mmmaisel/Keyboard/README.md

# Keyboard

This repo was migrated to [Codeberg](https://codeberg.org/mmmaisel/Keyboard).

An Open-Source and Open-Hardware full-sized modular, ergonomic, RGB keyboard.

This project is currently work in progress and not tested.

## License

Keyboard KiCAD hardware design files in the "hw" directory are licenses under
the CERN-OHL-S v2, or (at your option) any later version.

The Keyboard firmware in the "src" directory is licensed under the
GNU GPLv3, or (at your option) any later version.
