mmmaisel/Keyboard/hw/Keyboard-Outer-Case.FCStd

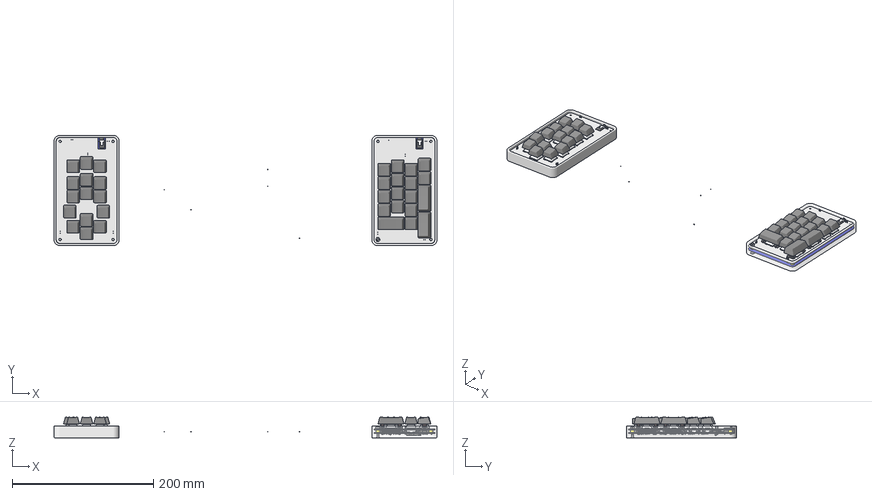
[picture p1: CAD file, 2024-01-11]
hw/Keyboard-Outer-Case.FCStd
542.3 x 156.3 x 29.3 mm
Outer Case
ISO14581 M3x16
M3-Mutter
Metal Nav
Metal Num
Case Clone
