mmmaisel/Keyboard/hw/CPU-Left.kicad_sch

## KiCad design hw/CPU-Left.kicad_sch (2026-01-05)

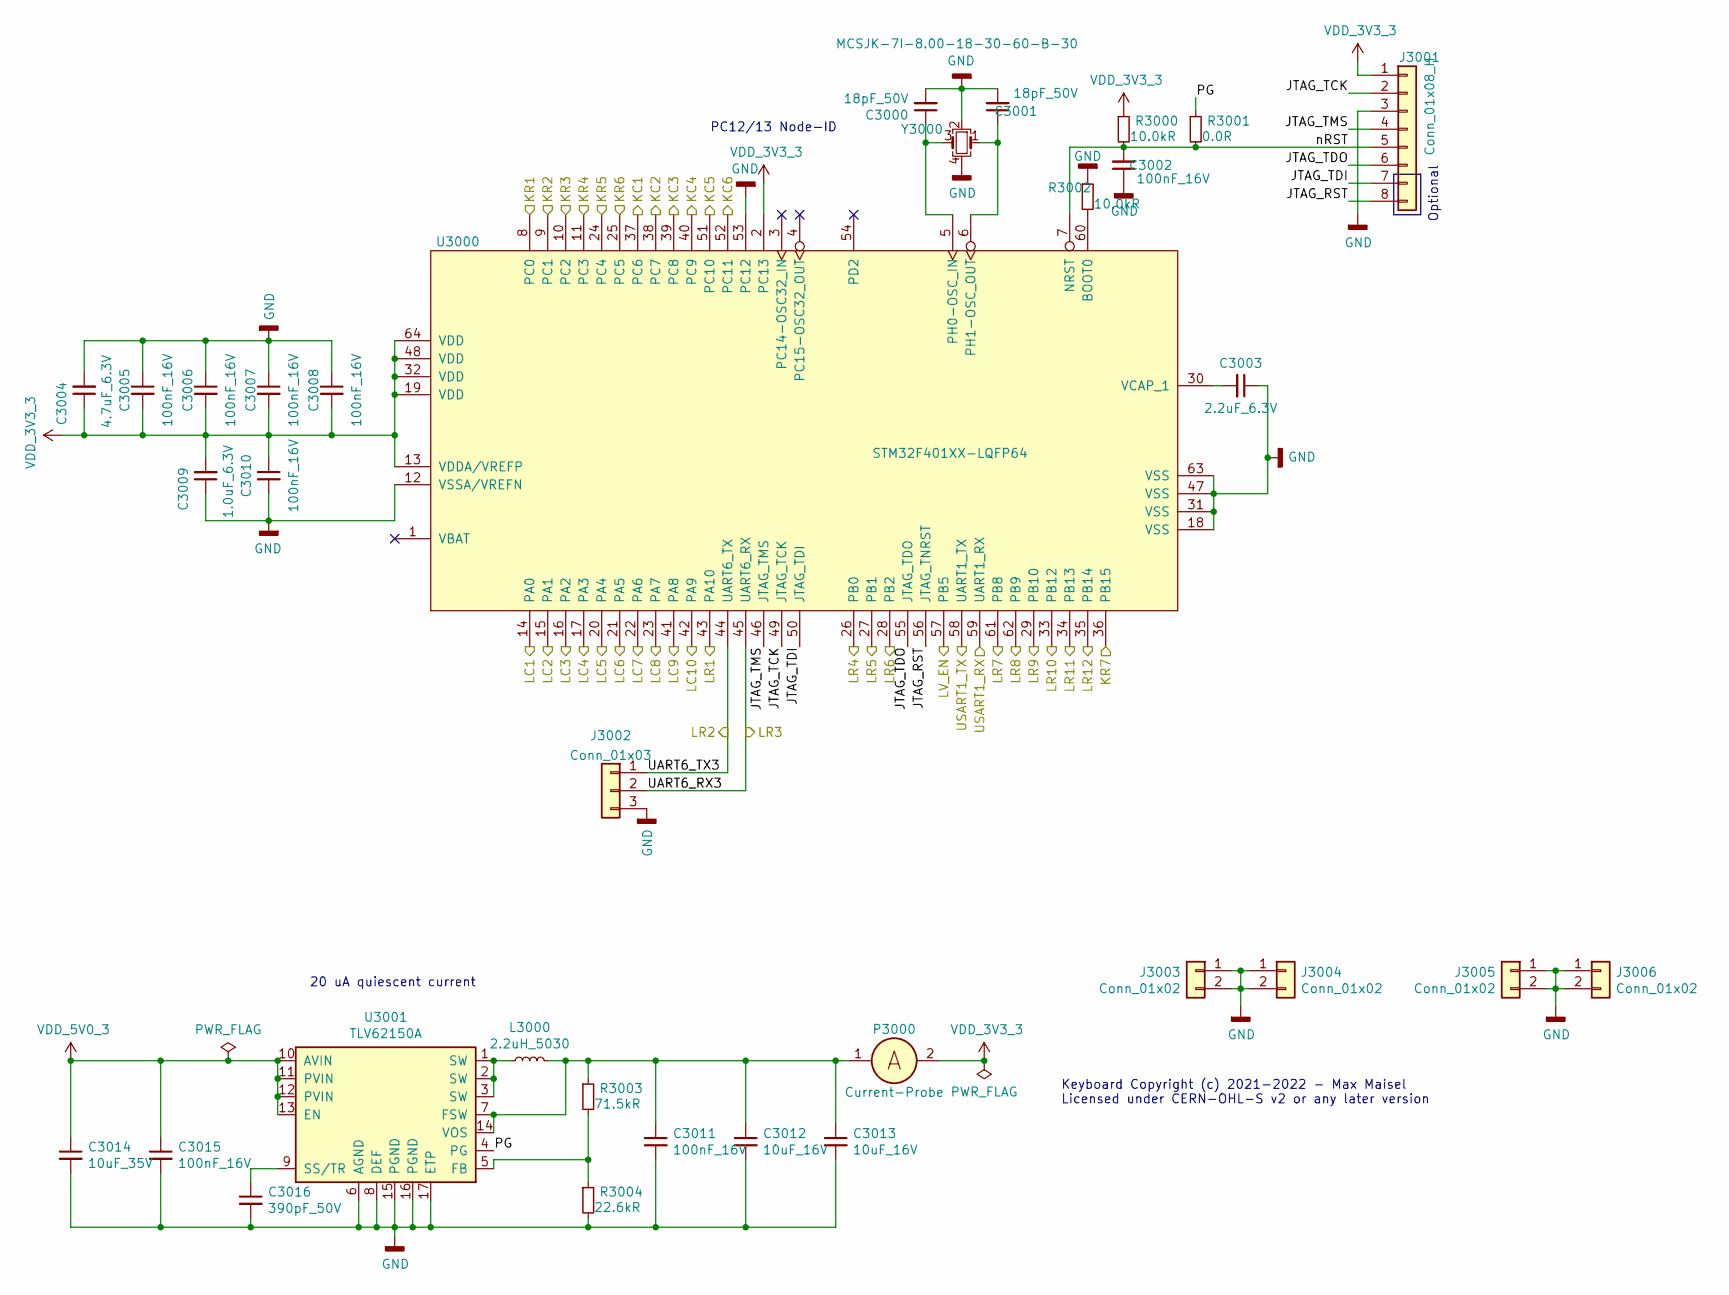
[picture p2: schematic CPU-Left.kicad_sch]

Parts:
C3000, C3001: 18pF_50V; C_0402; mouser# 81-GRM1555C1H180FA1D
C3002, C3005, C3006, C3007, C3008, C3010, C3011, C3015: 100nF_16V; C_0402; mouser# 80-C0402C104K4R
C3003: 2.2uF_6.3V; C_0402; mouser# 81-GRM155R60J225ME9D
C3004: 4.7uF_6.3V; C_0402; mouser# 81-GRM155R60J475ME7D
C3009: 1.0uF_6.3V; C_0402; mouser# 81-GRM152R60J105ME5D
C3012, C3013: 10uF_16V; C_1206; mouser# 80-C1206C106K4P
C3014: 10uF_35V; C_1210; mouser# 963-GMK325BJ106KN-T
C3016: 390pF_50V; C_0402; mouser# 81-GRM155R71H391KA1D
J3001: Conn_01x08_H; Pin_Header_Horizontal_1x08_Pitch2.54mm; farnell# 1593431
J3002: Conn_01x03; Pin_Header_Straight_1x03_Pitch2.54mm; farnell# 1593412
J3003, J3004, J3005, J3006: Conn_01x02; Pin_Header_Straight_1x02_Pitch2.54mm; farnell# 1593411
L3000: 2.2uH_5030; L_Taiyo-Yuden_NR-50xx; mouser# 963-NRS5030T2R2NMGJV
P3000: Current-Probe; Current-Probe-2.54
R3000, R3002: 10.0kR; R_0402; mouser# 667-ERJ-2RKF1002X
R3001: 0.0R; R_0402; mouser# 667-ERJ-2GE0R00X
R3003: 71.5kR; R_0402; mouser# 667-ERJ-2RKF7152X
R3004: 22.6kR; R_0402; mouser# 667-ERJ-S02F2262X
U3000: STM32F401XX-LQFP64; LQFP-64
U3001: TLV62150A; VQFN16-RGT; mouser# 595-TLV62150ARGTR
Y3000: MCSJK-7I-8.00-18-30-60-B-30; Crystal_SMD_Multicomp_5032; farnell# 2854013

Connections:
GND: C3000.2, C3001.2, C3002.1, C3003.1, C3004.2, C3005.1, C3006.1, C3007.1, C3008.1, C3009.1, C3010.2, C3011.2, C3012.2, C3013.2, C3014.2, C3015.2, C3016.2, J3001.3, J3002.3, J3003.1, J3003.2, J3004.1, J3004.2, J3005.1, J3005.2, J3006.1, J3006.2, R3002.1, R3004.2, U3000.12 (VSSA/VREFN), U3000.18 (VSS), U3000.31 (VSS), U3000.47 (VSS), U3000.53 (PC12), U3000.63 (VSS), U3001.6 (AGND), U3001.8 (DEF), U3001.15 (PGND), U3001.16 (PGND), U3001.17 (ETP), Y3000.2, Y3000.4
JTAG_RST: J3001.8, U3000.56 (PB4)
JTAG_TCK: J3001.2, U3000.49 (PA14)
JTAG_TDI: J3001.7, U3000.50 (PA15)
JTAG_TDO: J3001.6, U3000.55 (PB3)
JTAG_TMS: J3001.4, U3000.46 (PA13)
KC1: U3000.37 (PC6)
KC2: U3000.38 (PC7)
KC3: U3000.39 (PC8)
KC4: U3000.40 (PC9)
KC5: U3000.51 (PC10)
KC6: U3000.52 (PC11)
KR1: U3000.8 (PC0)
KR2: U3000.9 (PC1)
KR3: U3000.10 (PC2)
KR4: U3000.11 (PC3)
KR5: U3000.24 (PC4)
KR6: U3000.25 (PC5)
KR7: U3000.36 (PB15)
LC1: U3000.14 (PA0)
LC2: U3000.15 (PA1)
LC3: U3000.16 (PA2)
LC4: U3000.17 (PA3)
LC5: U3000.20 (PA4)
LC6: U3000.21 (PA5)
LC7: U3000.22 (PA6)
LC8: U3000.23 (PA7)
LC9: U3000.41 (PA8)
LC10: U3000.42 (PA9)
LR1: U3000.43 (PA10)
LR2: J3002.1, U3000.44 (PA11)
LR3: J3002.2, U3000.45 (PA12)
LR4: U3000.26 (PB0)
LR5: U3000.27 (PB1)
LR6: U3000.28 (PB2)
LR7: U3000.61 (PB8)
LR8: U3000.62 (PB9)
LR9: U3000.29 (PB10)
LR10: U3000.33 (PB12)
LR11: U3000.34 (PB13)
LR12: U3000.35 (PB14)
LV_EN: U3000.57 (PB5)
unnamed: C3000.1, U3000.5 (PH0-OSC_IN), Y3000.3
unnamed: C3001.1, U3000.6 (PH1-OSC_OUT), Y3000.1
unnamed: C3003.2, U3000.30 (VCAP_1)
unnamed: C3011.1, C3012.1, C3013.1, L3000.2, P3000.1, R3003.1, U3001.7 (FSW), U3001.14 (VOS)
unnamed: C3016.1, U3001.9 (SS/TR)
unnamed: L3000.1, U3001.1 (SW), U3001.2 (SW), U3001.3 (SW)
unnamed: R3002.2, U3000.60 (BOOT0)
unnamed: R3003.2, R3004.1, U3001.5 (FB)
PG: R3001.1, U3001.4 (PG)
USART1_RX: U3000.59 (PB7)
USART1_TX: U3000.58 (PB6)
VDD_3V3_3: C3004.1, C3005.2, C3006.2, C3007.2, C3008.2, C3009.2, C3010.1, J3001.1, P3000.2, R3000.1, U3000.2 (PC13), U3000.13 (VDDA/VREFP), U3000.19 (VDD), U3000.32 (VDD), U3000.48 (VDD), U3000.64 (VDD)
VDD_5V0_3: C3014.1, C3015.1, U3001.10 (AVIN), U3001.11 (PVIN), U3001.12 (PVIN), U3001.13 (EN)
nRST: C3002.2, J3001.5, R3000.2, R3001.2, U3000.7 (NRST)

Notes on the sheet:
PC12/13 Node-ID
Keyboard Copyright (c) 2021-2022 - Max Maisel Licensed under CERN-OHL-S v2 or any later version
Optional
20 uA quiescent current
