mmmaisel/Keyboard/hw/CPU-Navblock.kicad_sch

## KiCad design hw/CPU-Navblock.kicad_sch (2026-01-05)

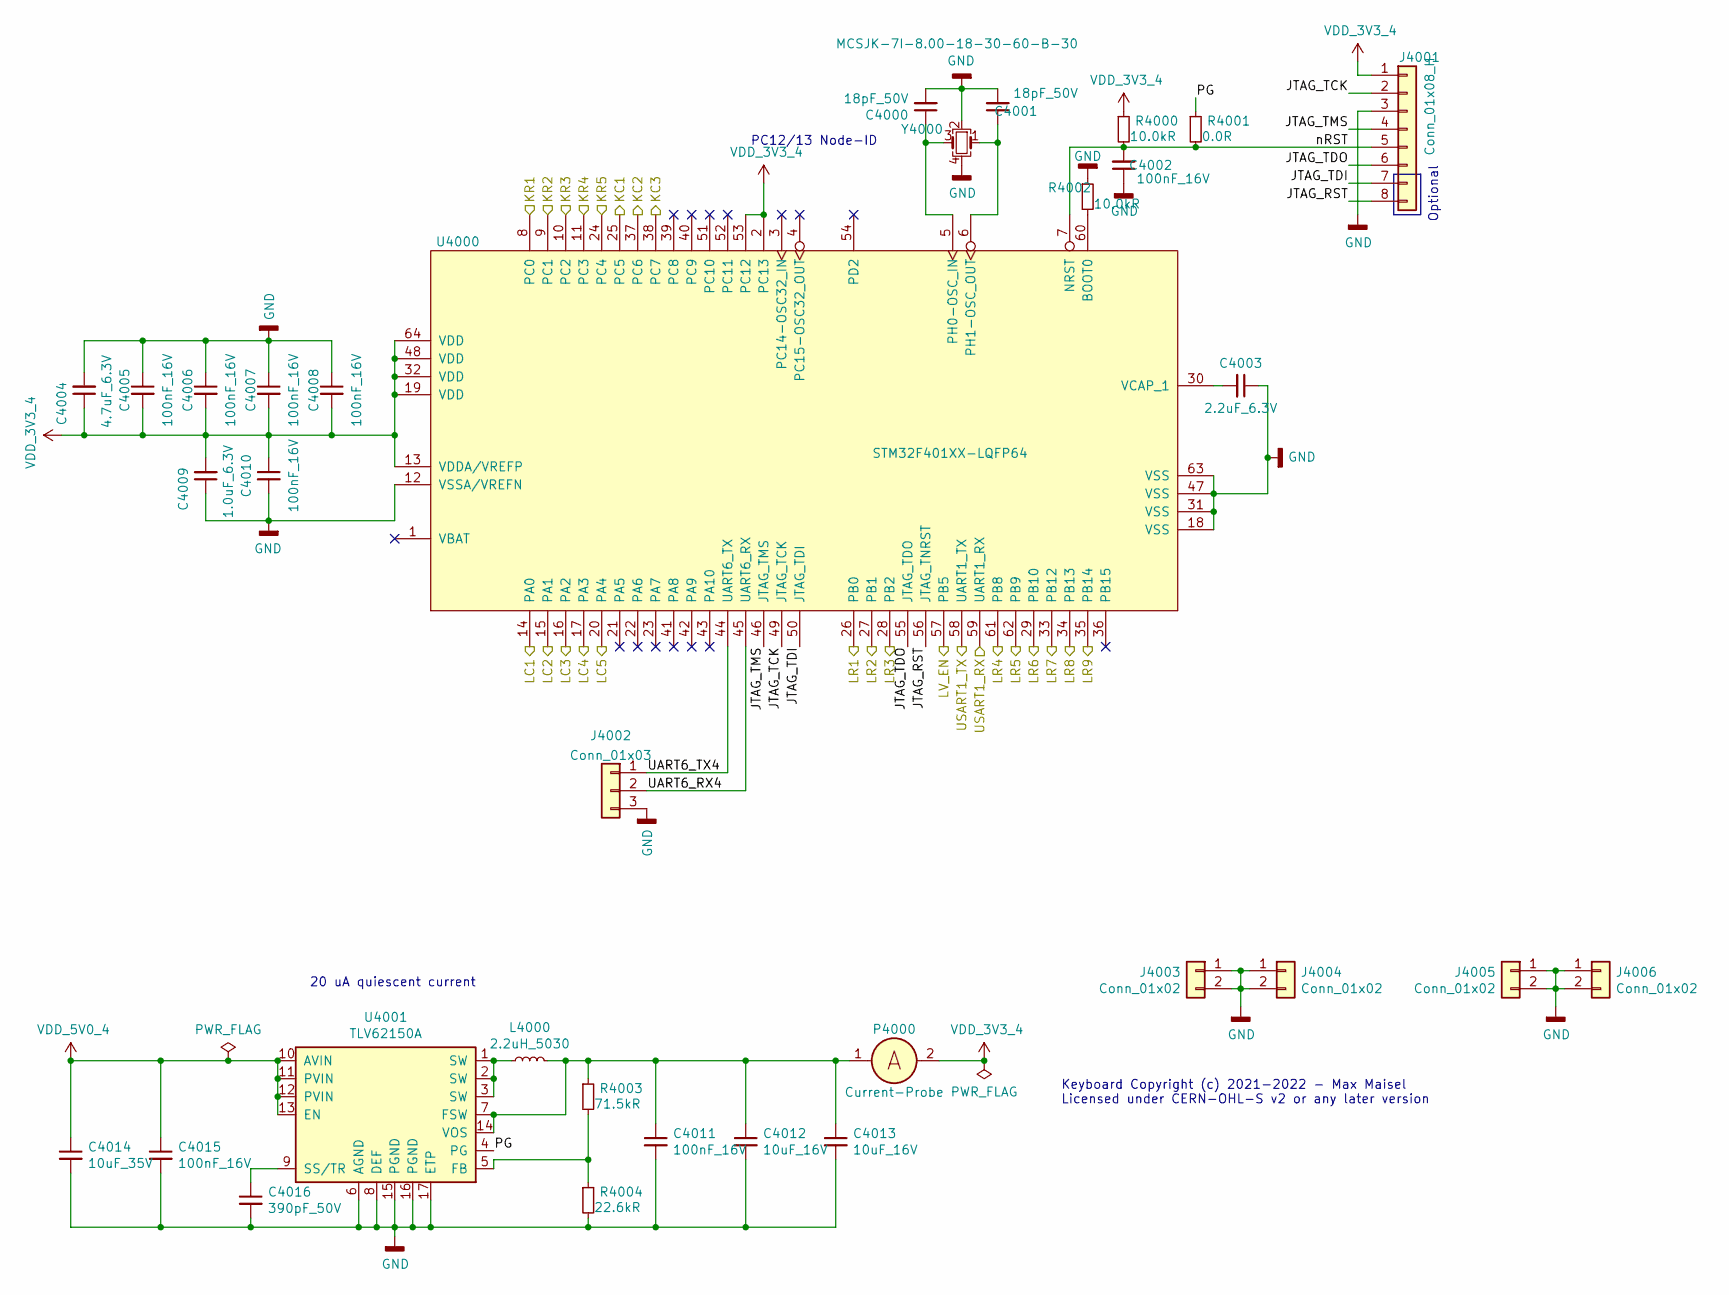
[picture p3: schematic CPU-Navblock.kicad_sch]

Parts:
C4000, C4001: 18pF_50V; C_0402; mouser# 81-GRM1555C1H180FA1D
C4002, C4005, C4006, C4007, C4008, C4010, C4011, C4015: 100nF_16V; C_0402; mouser# 80-C0402C104K4R
C4003: 2.2uF_6.3V; C_0402; mouser# 81-GRM155R60J225ME9D
C4004: 4.7uF_6.3V; C_0402; mouser# 81-GRM155R60J475ME7D
C4009: 1.0uF_6.3V; C_0402; mouser# 81-GRM152R60J105ME5D
C4012, C4013: 10uF_16V; C_1206; mouser# 80-C1206C106K4P
C4014: 10uF_35V; C_1210; mouser# 963-GMK325BJ106KN-T
C4016: 390pF_50V; C_0402; mouser# 81-GRM155R71H391KA1D
J4001: Conn_01x08_H; Pin_Header_Horizontal_1x08_Pitch2.54mm; farnell# 1593431
J4002: Conn_01x03; Pin_Header_Straight_1x03_Pitch2.54mm; farnell# 1593412
J4003, J4004, J4005, J4006: Conn_01x02; Pin_Header_Straight_1x02_Pitch2.54mm; farnell# 1593411
L4000: 2.2uH_5030; L_Taiyo-Yuden_NR-50xx; mouser# 963-NRS5030T2R2NMGJV
P4000: Current-Probe; Current-Probe-2.54
R4000, R4002: 10.0kR; R_0402; mouser# 667-ERJ-2RKF1002X
R4001: 0.0R; R_0402; mouser# 667-ERJ-2GE0R00X
R4003: 71.5kR; R_0402; mouser# 667-ERJ-2RKF7152X
R4004: 22.6kR; R_0402; mouser# 667-ERJ-S02F2262X
U4000: STM32F401XX-LQFP64; LQFP-64
U4001: TLV62150A; VQFN16-RGT; mouser# 595-TLV62150ARGTR
Y4000: MCSJK-7I-8.00-18-30-60-B-30; Crystal_SMD_Multicomp_5032; farnell# 2854013

Connections:
GND: C4000.2, C4001.2, C4002.1, C4003.1, C4004.2, C4005.1, C4006.1, C4007.1, C4008.1, C4009.1, C4010.2, C4011.2, C4012.2, C4013.2, C4014.2, C4015.2, C4016.2, J4001.3, J4002.3, J4003.1, J4003.2, J4004.1, J4004.2, J4005.1, J4005.2, J4006.1, J4006.2, R4002.1, R4004.2, U4000.12 (VSSA/VREFN), U4000.18 (VSS), U4000.31 (VSS), U4000.47 (VSS), U4000.63 (VSS), U4001.6 (AGND), U4001.8 (DEF), U4001.15 (PGND), U4001.16 (PGND), U4001.17 (ETP), Y4000.2, Y4000.4
JTAG_RST: J4001.8, U4000.56 (PB4)
JTAG_TCK: J4001.2, U4000.49 (PA14)
JTAG_TDI: J4001.7, U4000.50 (PA15)
JTAG_TDO: J4001.6, U4000.55 (PB3)
JTAG_TMS: J4001.4, U4000.46 (PA13)
KC1: U4000.25 (PC5)
KC2: U4000.37 (PC6)
KC3: U4000.38 (PC7)
KR1: U4000.8 (PC0)
KR2: U4000.9 (PC1)
KR3: U4000.10 (PC2)
KR4: U4000.11 (PC3)
KR5: U4000.24 (PC4)
LC1: U4000.14 (PA0)
LC2: U4000.15 (PA1)
LC3: U4000.16 (PA2)
LC4: U4000.17 (PA3)
LC5: U4000.20 (PA4)
LR1: U4000.26 (PB0)
LR2: U4000.27 (PB1)
LR3: U4000.28 (PB2)
LR4: U4000.61 (PB8)
LR5: U4000.62 (PB9)
LR6: U4000.29 (PB10)
LR7: U4000.33 (PB12)
LR8: U4000.34 (PB13)
LR9: U4000.35 (PB14)
LV_EN: U4000.57 (PB5)
unnamed: C4000.1, U4000.5 (PH0-OSC_IN), Y4000.3
unnamed: C4001.1, U4000.6 (PH1-OSC_OUT), Y4000.1
unnamed: C4003.2, U4000.30 (VCAP_1)
unnamed: C4011.1, C4012.1, C4013.1, L4000.2, P4000.1, R4003.1, U4001.7 (FSW), U4001.14 (VOS)
unnamed: C4016.1, U4001.9 (SS/TR)
unnamed: L4000.1, U4001.1 (SW), U4001.2 (SW), U4001.3 (SW)
unnamed: R4002.2, U4000.60 (BOOT0)
unnamed: R4003.2, R4004.1, U4001.5 (FB)
PG: R4001.1, U4001.4 (PG)
UART6_RX4: J4002.2, U4000.45 (PA12)
UART6_TX4: J4002.1, U4000.44 (PA11)
USART1_RX: U4000.59 (PB7)
USART1_TX: U4000.58 (PB6)
VDD_3V3_4: C4004.1, C4005.2, C4006.2, C4007.2, C4008.2, C4009.2, C4010.1, J4001.1, P4000.2, R4000.1, U4000.2 (PC13), U4000.13 (VDDA/VREFP), U4000.19 (VDD), U4000.32 (VDD), U4000.48 (VDD), U4000.53 (PC12), U4000.64 (VDD)
VDD_5V0_4: C4014.1, C4015.1, U4001.10 (AVIN), U4001.11 (PVIN), U4001.12 (PVIN), U4001.13 (EN)
nRST: C4002.2, J4001.5, R4000.2, R4001.2, U4000.7 (NRST)

Notes on the sheet:
PC12/13 Node-ID
Optional
Keyboard Copyright (c) 2021-2022 - Max Maisel Licensed under CERN-OHL-S v2 or any later version
20 uA quiescent current
