mmmaisel/Keyboard/hw/CPU-Numblock.kicad_sch

## KiCad design hw/CPU-Numblock.kicad_sch (2026-01-05)

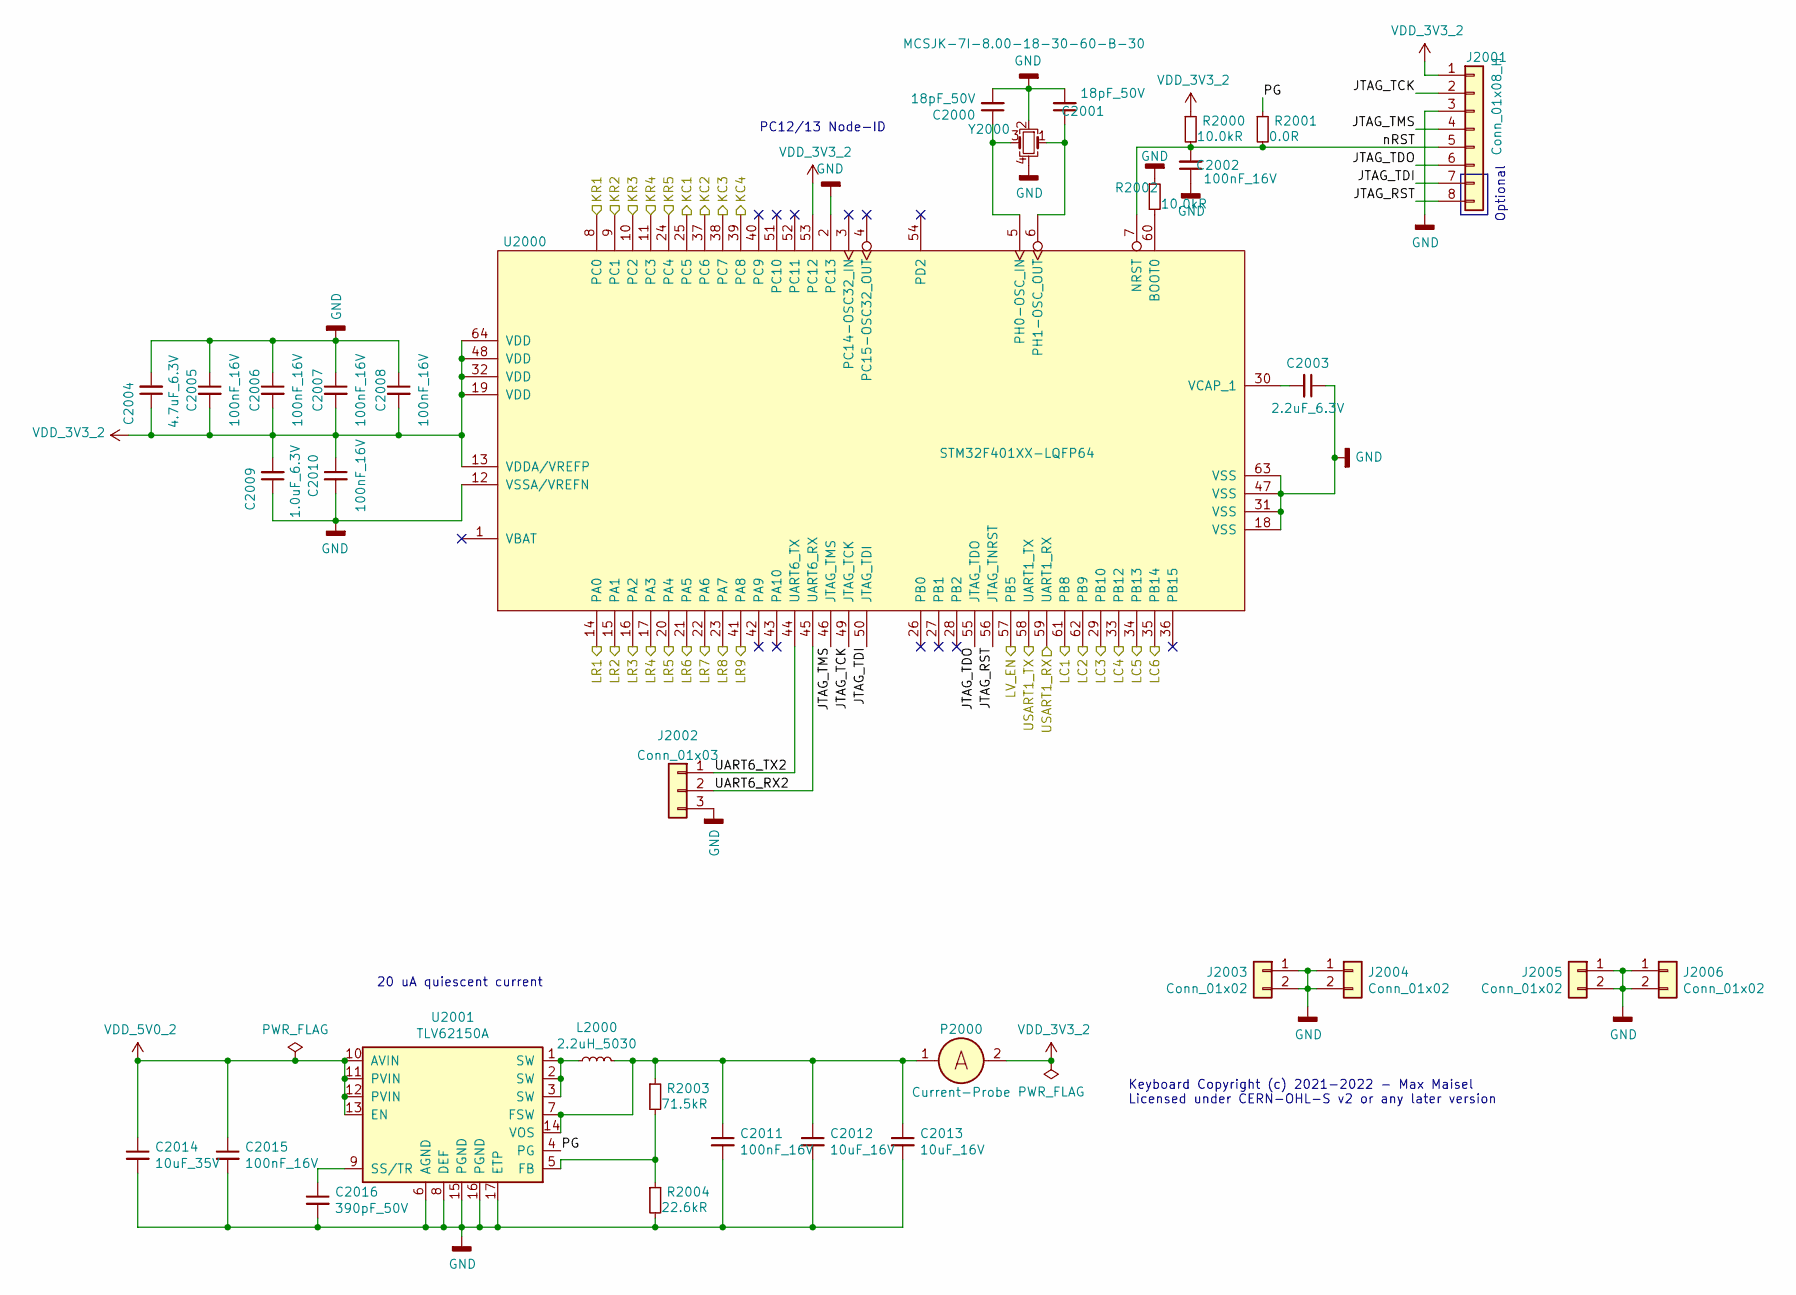
[picture p4: schematic CPU-Numblock.kicad_sch]

Parts:
C2000, C2001: 18pF_50V; C_0402; mouser# 81-GRM1555C1H180FA1D
C2002, C2005, C2006, C2007, C2008, C2010, C2011, C2015: 100nF_16V; C_0402; mouser# 80-C0402C104K4R
C2003: 2.2uF_6.3V; C_0402; mouser# 81-GRM155R60J225ME9D
C2004: 4.7uF_6.3V; C_0402; mouser# 81-GRM155R60J475ME7D
C2009: 1.0uF_6.3V; C_0402; mouser# 81-GRM152R60J105ME5D
C2012, C2013: 10uF_16V; C_1206; mouser# 80-C1206C106K4P
C2014: 10uF_35V; C_1210; mouser# 963-GMK325BJ106KN-T
C2016: 390pF_50V; C_0402; mouser# 81-GRM155R71H391KA1D
J2001: Conn_01x08_H; Pin_Header_Horizontal_1x08_Pitch2.54mm; farnell# 1593431
J2002: Conn_01x03; Pin_Header_Straight_1x03_Pitch2.54mm; farnell# 1593412
J2003, J2004, J2005, J2006: Conn_01x02; Pin_Header_Straight_1x02_Pitch2.54mm; farnell# 1593411
L2000: 2.2uH_5030; L_Taiyo-Yuden_NR-50xx; mouser# 963-NRS5030T2R2NMGJV
P2000: Current-Probe; Current-Probe-2.54
R2000, R2002: 10.0kR; R_0402; mouser# 667-ERJ-2RKF1002X
R2001: 0.0R; R_0402; mouser# 667-ERJ-2GE0R00X
R2003: 71.5kR; R_0402; mouser# 667-ERJ-2RKF7152X
R2004: 22.6kR; R_0402; mouser# 667-ERJ-S02F2262X
U2000: STM32F401XX-LQFP64; LQFP-64
U2001: TLV62150A; VQFN16-RGT; mouser# 595-TLV62150ARGTR
Y2000: MCSJK-7I-8.00-18-30-60-B-30; Crystal_SMD_Multicomp_5032; farnell# 2854013

Connections:
GND: C2000.2, C2001.2, C2002.1, C2003.1, C2004.2, C2005.1, C2006.1, C2007.1, C2008.1, C2009.1, C2010.2, C2011.2, C2012.2, C2013.2, C2014.2, C2015.2, C2016.2, J2001.3, J2002.3, J2003.1, J2003.2, J2004.1, J2004.2, J2005.1, J2005.2, J2006.1, J2006.2, R2002.1, R2004.2, U2000.2 (PC13), U2000.12 (VSSA/VREFN), U2000.18 (VSS), U2000.31 (VSS), U2000.47 (VSS), U2000.63 (VSS), U2001.6 (AGND), U2001.8 (DEF), U2001.15 (PGND), U2001.16 (PGND), U2001.17 (ETP), Y2000.2, Y2000.4
JTAG_RST: J2001.8, U2000.56 (PB4)
JTAG_TCK: J2001.2, U2000.49 (PA14)
JTAG_TDI: J2001.7, U2000.50 (PA15)
JTAG_TDO: J2001.6, U2000.55 (PB3)
JTAG_TMS: J2001.4, U2000.46 (PA13)
KC1: U2000.25 (PC5)
KC2: U2000.37 (PC6)
KC3: U2000.38 (PC7)
KC4: U2000.39 (PC8)
KR1: U2000.8 (PC0)
KR2: U2000.9 (PC1)
KR3: U2000.10 (PC2)
KR4: U2000.11 (PC3)
KR5: U2000.24 (PC4)
LC1: U2000.61 (PB8)
LC2: U2000.62 (PB9)
LC3: U2000.29 (PB10)
LC4: U2000.33 (PB12)
LC5: U2000.34 (PB13)
LC6: U2000.35 (PB14)
LR1: U2000.14 (PA0)
LR2: U2000.15 (PA1)
LR3: U2000.16 (PA2)
LR4: U2000.17 (PA3)
LR5: U2000.20 (PA4)
LR6: U2000.21 (PA5)
LR7: U2000.22 (PA6)
LR8: U2000.23 (PA7)
LR9: U2000.41 (PA8)
LV_EN: U2000.57 (PB5)
unnamed: C2000.1, U2000.5 (PH0-OSC_IN), Y2000.3
unnamed: C2001.1, U2000.6 (PH1-OSC_OUT), Y2000.1
unnamed: C2003.2, U2000.30 (VCAP_1)
unnamed: C2011.1, C2012.1, C2013.1, L2000.2, P2000.1, R2003.1, U2001.7 (FSW), U2001.14 (VOS)
unnamed: C2016.1, U2001.9 (SS/TR)
unnamed: L2000.1, U2001.1 (SW), U2001.2 (SW), U2001.3 (SW)
unnamed: R2002.2, U2000.60 (BOOT0)
unnamed: R2003.2, R2004.1, U2001.5 (FB)
PG: R2001.1, U2001.4 (PG)
UART6_RX2: J2002.2, U2000.45 (PA12)
UART6_TX2: J2002.1, U2000.44 (PA11)
USART1_RX: U2000.59 (PB7)
USART1_TX: U2000.58 (PB6)
VDD_3V3_2: C2004.1, C2005.2, C2006.2, C2007.2, C2008.2, C2009.2, C2010.1, J2001.1, P2000.2, R2000.1, U2000.13 (VDDA/VREFP), U2000.19 (VDD), U2000.32 (VDD), U2000.48 (VDD), U2000.53 (PC12), U2000.64 (VDD)
VDD_5V0_2: C2014.1, C2015.1, U2001.10 (AVIN), U2001.11 (PVIN), U2001.12 (PVIN), U2001.13 (EN)
nRST: C2002.2, J2001.5, R2000.2, R2001.2, U2000.7 (NRST)

Notes on the sheet:
20 uA quiescent current
Optional
PC12/13 Node-ID
Keyboard Copyright (c) 2021-2022 - Max Maisel Licensed under CERN-OHL-S v2 or any later version
