mmmaisel/Keyboard/hw/CPU-Right.kicad_sch

## KiCad design hw/CPU-Right.kicad_sch (2026-01-05)

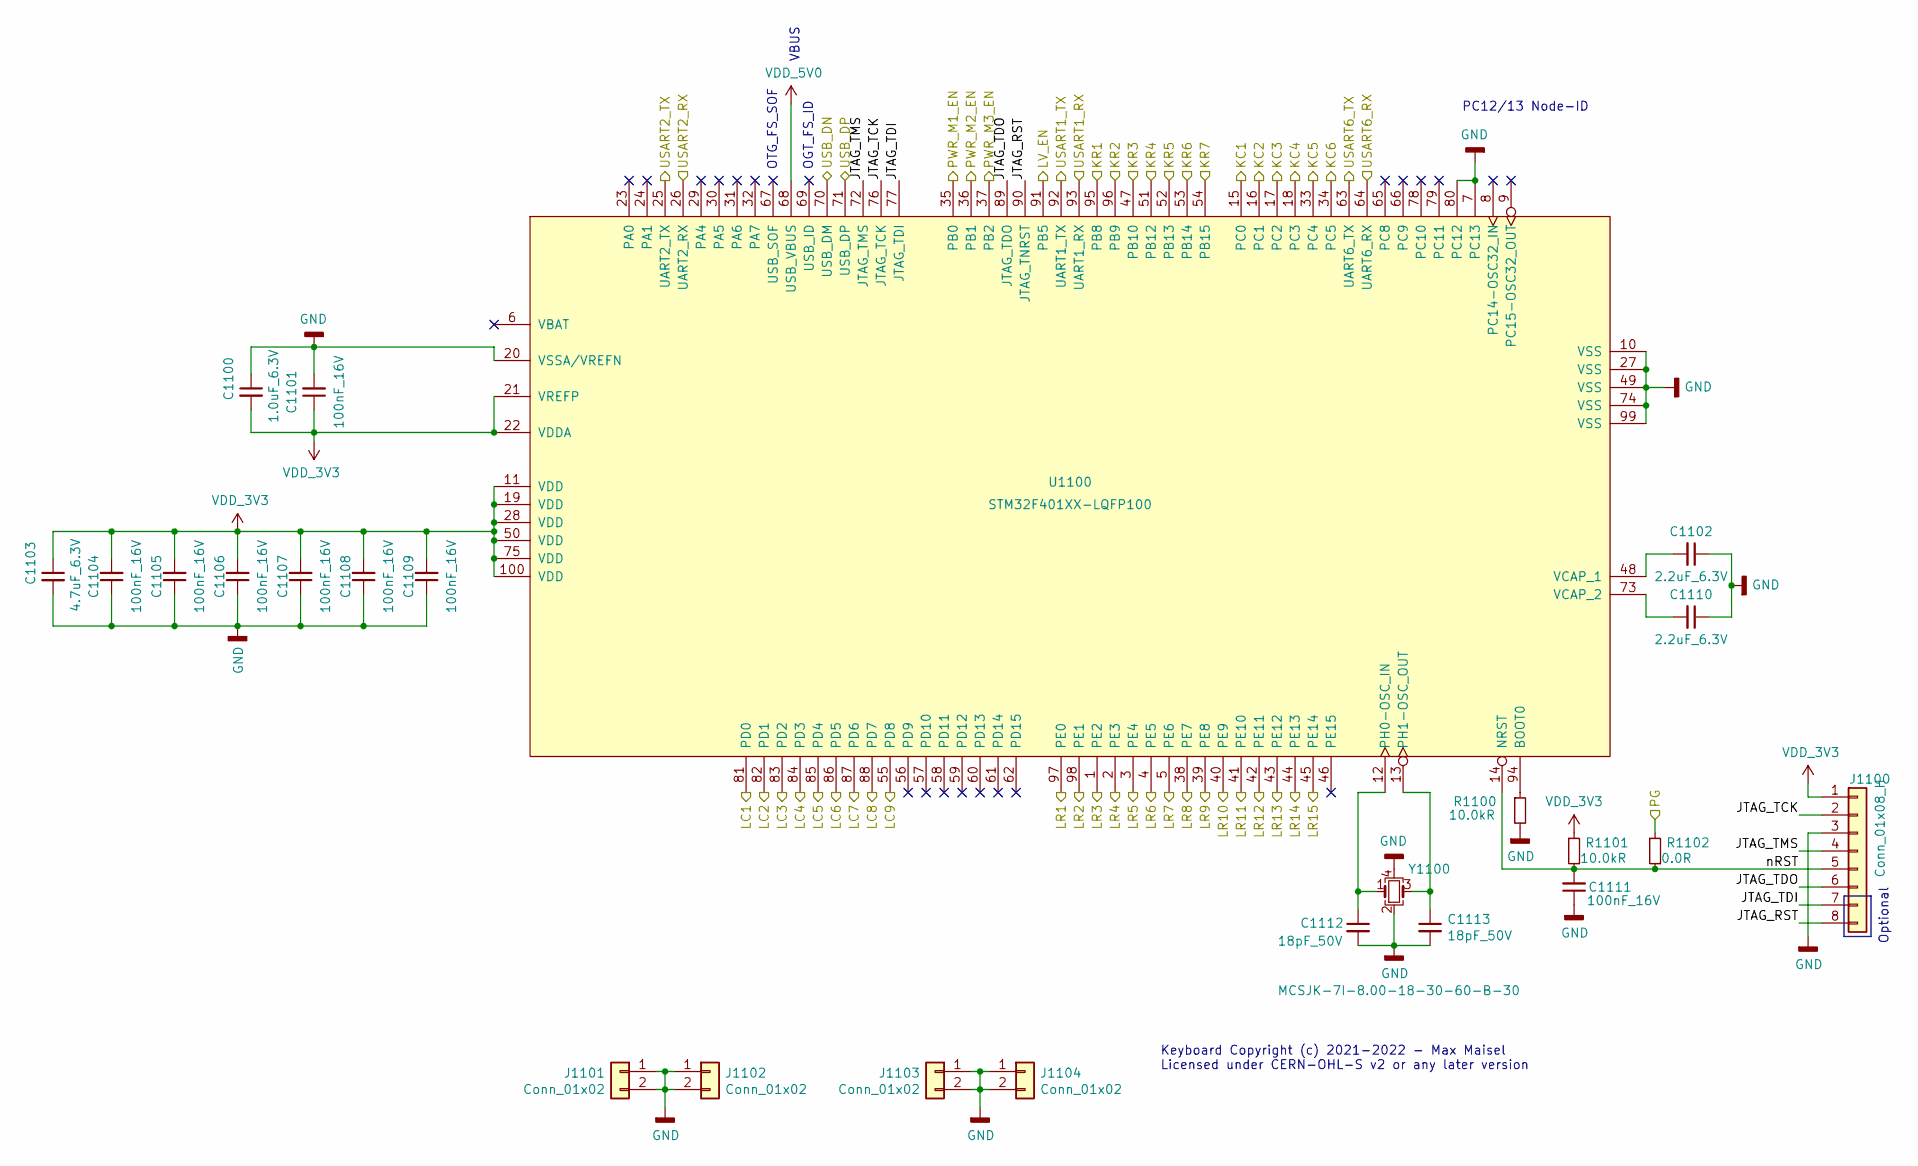
[picture p5: schematic CPU-Right.kicad_sch]

Parts:
C1100: 1.0uF_6.3V; C_0402; mouser# 81-GRM152R60J105ME5D
C1101, C1104, C1105, C1106, C1107, C1108, C1109, C1111: 100nF_16V; C_0402; mouser# 80-C0402C104K4R
C1102, C1110: 2.2uF_6.3V; C_0402; mouser# 81-GRM155R60J225ME9D
C1103: 4.7uF_6.3V; C_0402; mouser# 81-GRM155R60J475ME7D
C1112, C1113: 18pF_50V; C_0402; mouser# 81-GRM1555C1H180FA1D
J1100: Conn_01x08_H; Pin_Header_Horizontal_1x08_Pitch2.54mm; farnell# 1593431
J1101, J1102, J1103, J1104: Conn_01x02; Pin_Header_Straight_1x02_Pitch2.54mm; farnell# 1593411
R1100, R1101: 10.0kR; R_0402; mouser# 667-ERJ-2RKF1002X
R1102: 0.0R; R_0402; mouser# 667-ERJ-2GE0R00X
U1100: STM32F401XX-LQFP100; LQFP-100
Y1100: MCSJK-7I-8.00-18-30-60-B-30; Crystal_SMD_Multicomp_5032; farnell# 2854013

Connections:
GND: C1100.1, C1101.2, C1102.1, C1103.2, C1104.1, C1105.1, C1106.1, C1107.1, C1108.1, C1109.1, C1110.1, C1111.1, C1112.2, C1113.2, J1100.3, J1101.1, J1101.2, J1102.1, J1102.2, J1103.1, J1103.2, J1104.1, J1104.2, R1100.2, U1100.7 (PC13), U1100.10 (VSS), U1100.20 (VSSA/VREFN), U1100.27 (VSS), U1100.49 (VSS), U1100.74 (VSS), U1100.80 (PC12), U1100.99 (VSS), Y1100.2, Y1100.4
JTAG_RST: J1100.8, U1100.90 (PB4)
JTAG_TCK: J1100.2, U1100.76 (PA14)
JTAG_TDI: J1100.7, U1100.77 (PA15)
JTAG_TDO: J1100.6, U1100.89 (PB3)
JTAG_TMS: J1100.4, U1100.72 (PA13)
KC1: U1100.15 (PC0)
KC2: U1100.16 (PC1)
KC3: U1100.17 (PC2)
KC4: U1100.18 (PC3)
KC5: U1100.33 (PC4)
KC6: U1100.34 (PC5)
KR1: U1100.95 (PB8)
KR2: U1100.96 (PB9)
KR3: U1100.47 (PB10)
KR4: U1100.51 (PB12)
KR5: U1100.52 (PB13)
KR6: U1100.53 (PB14)
KR7: U1100.54 (PB15)
LC1: U1100.81 (PD0)
LC2: U1100.82 (PD1)
LC3: U1100.83 (PD2)
LC4: U1100.84 (PD3)
LC5: U1100.85 (PD4)
LC6: U1100.86 (PD5)
LC7: U1100.87 (PD6)
LC8: U1100.88 (PD7)
LC9: U1100.55 (PD8)
LR1: U1100.97 (PE0)
LR2: U1100.98 (PE1)
LR3: U1100.1 (PE2)
LR4: U1100.2 (PE3)
LR5: U1100.3 (PE4)
LR6: U1100.4 (PE5)
LR7: U1100.5 (PE6)
LR8: U1100.38 (PE7)
LR9: U1100.39 (PE8)
LR10: U1100.40 (PE9)
LR11: U1100.41 (PE10)
LR12: U1100.42 (PE11)
LR13: U1100.43 (PE12)
LR14: U1100.44 (PE13)
LR15: U1100.45 (PE14)
LV_EN: U1100.91 (PB5)
unnamed: C1102.2, U1100.48 (VCAP_1)
unnamed: C1110.2, U1100.73 (VCAP_2)
unnamed: C1112.1, U1100.12 (PH0-OSC_IN), Y1100.1
unnamed: C1113.1, U1100.13 (PH1-OSC_OUT), Y1100.3
unnamed: R1100.1, U1100.94 (BOOT0)
PG: R1102.1
PWR_M1_EN: U1100.35 (PB0)
PWR_M2_EN: U1100.36 (PB1)
PWR_M3_EN: U1100.37 (PB2)
USART1_RX: U1100.93 (PB7)
USART1_TX: U1100.92 (PB6)
USART2_RX: U1100.26 (PA3)
USART2_TX: U1100.25 (PA2)
USART6_RX: U1100.64 (PC7)
USART6_TX: U1100.63 (PC6)
USB_DN: U1100.70 (PA11)
USB_DP: U1100.71 (PA12)
VDD_3V3: C1100.2, C1101.1, C1103.1, C1104.2, C1105.2, C1106.2, C1107.2, C1108.2, C1109.2, J1100.1, R1101.1, U1100.11 (VDD), U1100.19 (VDD), U1100.21 (VREFP), U1100.22 (VDDA), U1100.28 (VDD), U1100.50 (VDD), U1100.75 (VDD), U1100.100 (VDD)
VDD_5V0: U1100.68 (PA9)
nRST: C1111.2, J1100.5, R1101.2, R1102.2, U1100.14 (NRST)

Notes on the sheet:
Keyboard Copyright (c) 2021-2022 - Max Maisel Licensed under CERN-OHL-S v2 or any later version
VBUS
OTG_FS_SOF
Optional
PC12/13 Node-ID
OGT_FS_ID
