mmmaisel/Keyboard/hw/KeyMatrix-Left.kicad_sch

## KiCad design hw/KeyMatrix-Left.kicad_sch (2026-01-05)

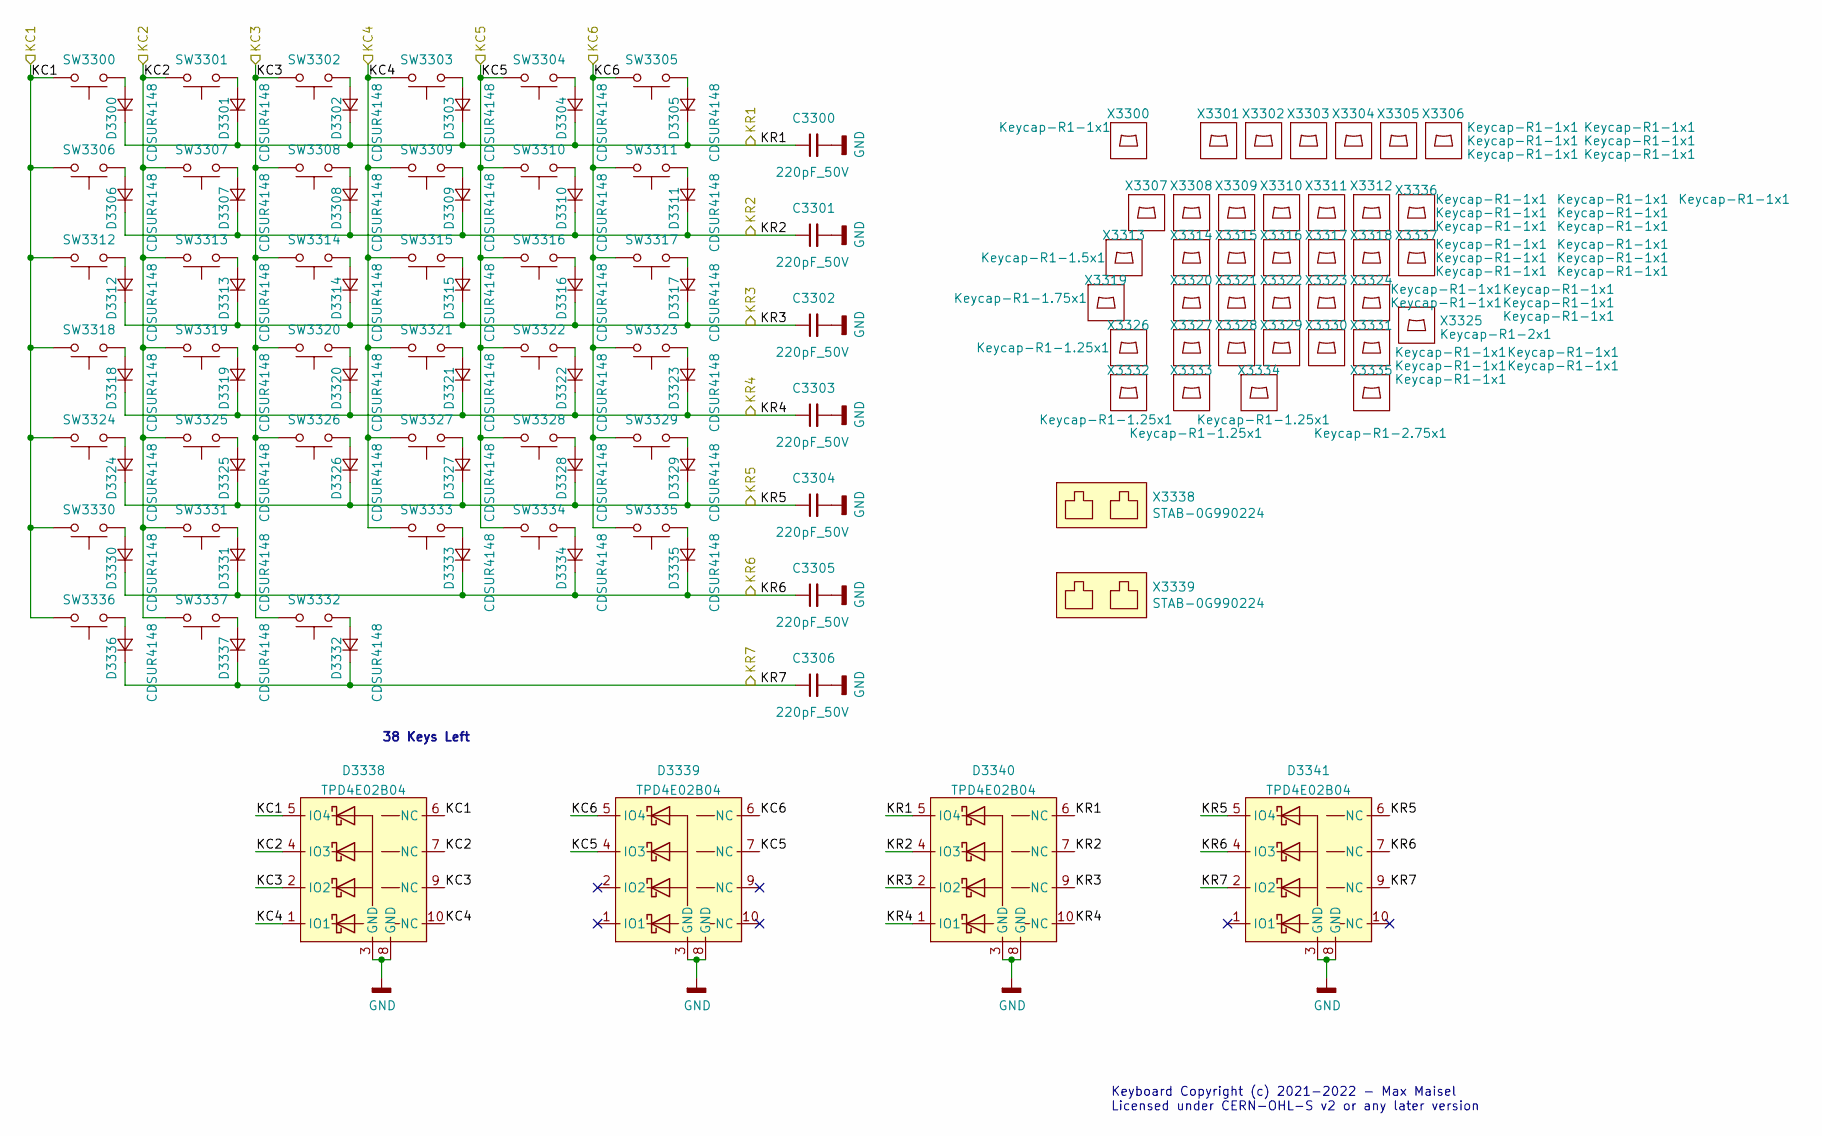
[picture p6: schematic KeyMatrix-Left.kicad_sch]

Parts:
C3300, C3301, C3302, C3303, C3304, C3305, C3306: 220pF_50V; C_0402; mouser# 81-GRM0335C1H221JA1D
D3300, D3301, D3302, D3303, D3304, D3305, D3306, D3307, D3308, D3309, D3310, D3311, D3312, D3313, D3314, D3315, D3316, D3317, D3318, D3319, D3320, D3321, D3322, D3323, D3324, D3325, D3326, D3327, D3328, D3329, D3330, D3331, D3332, D3333, D3334, D3335, D3336, D3337: CDSUR4148; SOD-523; mouser# 750-CDSUR4148
D3338, D3339, D3340, D3341: TPD4E02B04; USON10; mouser# 595-TPD4E02B04DQAR
SW3300, SW3301, SW3302, SW3303, SW3304, SW3305, SW3306, SW3307, SW3308, SW3309, SW3310, SW3311, SW3312, SW3313, SW3314, SW3315, SW3316, SW3317, SW3318, SW3319, SW3320, SW3321, SW3322, SW3323, SW3324, SW3325, SW3326, SW3327, SW3328, SW3329, SW3330, SW3331, SW3332, SW3333, SW3334, SW3335, SW3336, SW3337: SW_Cherry_MX_RGB; SW_Cherry_MX1A_RGB
X3300, X3301, X3302, X3303, X3304, X3305, X3306, X3307, X3308, X3309, X3310, X3311, X3312, X3314, X3315, X3316, X3317, X3318, X3320, X3321, X3322, X3323, X3324, X3327, X3328, X3329, X3330, X3331, X3336, X3337: Keycap-R1-1x1
X3313: Keycap-R1-1.5x1
X3319: Keycap-R1-1.75x1
X3325: Keycap-R1-2x1
X3326, X3332, X3333, X3334: Keycap-R1-1.25x1
X3335: Keycap-R1-2.75x1
X3338, X3339: STAB-0G990224; STAB-G99-0224; mouser# 540-G99-0224

Connections:
GND: C3300.2, C3301.2, C3302.2, C3303.2, C3304.2, C3305.2, C3306.2, D3338.3 (GND), D3338.8 (GND), D3339.3 (GND), D3339.8 (GND), D3340.3 (GND), D3340.8 (GND), D3341.3 (GND), D3341.8 (GND)
KC1: D3338.5 (IO4), D3338.6 (NC), SW3300.1, SW3306.1, SW3312.1, SW3318.1, SW3324.1, SW3330.1, SW3336.1
KC2: D3338.4 (IO3), D3338.7 (NC), SW3301.1, SW3307.1, SW3313.1, SW3319.1, SW3325.1, SW3331.1, SW3337.1
KC3: D3338.2 (IO2), D3338.9 (NC), SW3302.1, SW3308.1, SW3314.1, SW3320.1, SW3326.1, SW3332.1
KC4: D3338.1 (IO1), D3338.10 (NC), SW3303.1, SW3309.1, SW3315.1, SW3321.1, SW3327.1, SW3333.1
KC5: D3339.4 (IO3), D3339.7 (NC), SW3304.1, SW3310.1, SW3316.1, SW3322.1, SW3328.1, SW3334.1
KC6: D3339.5 (IO4), D3339.6 (NC), SW3305.1, SW3311.1, SW3317.1, SW3323.1, SW3329.1, SW3335.1
KR1: C3300.1, D3300.1 (K), D3301.1 (K), D3302.1 (K), D3303.1 (K), D3304.1 (K), D3305.1 (K), D3340.5 (IO4), D3340.6 (NC)
KR2: C3301.1, D3306.1 (K), D3307.1 (K), D3308.1 (K), D3309.1 (K), D3310.1 (K), D3311.1 (K), D3340.4 (IO3), D3340.7 (NC)
KR3: C3302.1, D3312.1 (K), D3313.1 (K), D3314.1 (K), D3315.1 (K), D3316.1 (K), D3317.1 (K), D3340.2 (IO2), D3340.9 (NC)
KR4: C3303.1, D3318.1 (K), D3319.1 (K), D3320.1 (K), D3321.1 (K), D3322.1 (K), D3323.1 (K), D3340.1 (IO1), D3340.10 (NC)
KR5: C3304.1, D3324.1 (K), D3325.1 (K), D3326.1 (K), D3327.1 (K), D3328.1 (K), D3329.1 (K), D3341.5 (IO4), D3341.6 (NC)
KR6: C3305.1, D3330.1 (K), D3331.1 (K), D3333.1 (K), D3334.1 (K), D3335.1 (K), D3341.4 (IO3), D3341.7 (NC)
KR7: C3306.1, D3332.1 (K), D3336.1 (K), D3337.1 (K), D3341.2 (IO2), D3341.9 (NC)
unnamed: D3300.2 (A), SW3300.2
unnamed: D3301.2 (A), SW3301.2
unnamed: D3302.2 (A), SW3302.2
unnamed: D3303.2 (A), SW3303.2
unnamed: D3304.2 (A), SW3304.2
unnamed: D3305.2 (A), SW3305.2
unnamed: D3306.2 (A), SW3306.2
unnamed: D3307.2 (A), SW3307.2
unnamed: D3308.2 (A), SW3308.2
unnamed: D3309.2 (A), SW3309.2
unnamed: D3310.2 (A), SW3310.2
unnamed: D3311.2 (A), SW3311.2
unnamed: D3312.2 (A), SW3312.2
unnamed: D3313.2 (A), SW3313.2
unnamed: D3314.2 (A), SW3314.2
unnamed: D3315.2 (A), SW3315.2
unnamed: D3316.2 (A), SW3316.2
unnamed: D3317.2 (A), SW3317.2
unnamed: D3318.2 (A), SW3318.2
unnamed: D3319.2 (A), SW3319.2
unnamed: D3320.2 (A), SW3320.2
unnamed: D3321.2 (A), SW3321.2
unnamed: D3322.2 (A), SW3322.2
unnamed: D3323.2 (A), SW3323.2
unnamed: D3324.2 (A), SW3324.2
unnamed: D3325.2 (A), SW3325.2
unnamed: D3326.2 (A), SW3326.2
unnamed: D3327.2 (A), SW3327.2
unnamed: D3328.2 (A), SW3328.2
unnamed: D3329.2 (A), SW3329.2
unnamed: D3330.2 (A), SW3330.2
unnamed: D3331.2 (A), SW3331.2
unnamed: D3332.2 (A), SW3332.2
unnamed: D3333.2 (A), SW3333.2
unnamed: D3334.2 (A), SW3334.2
unnamed: D3335.2 (A), SW3335.2
unnamed: D3336.2 (A), SW3336.2
unnamed: D3337.2 (A), SW3337.2

Notes on the sheet:
Keyboard Copyright (c) 2021-2022 - Max Maisel Licensed under CERN-OHL-S v2 or any later version
38 Keys Left
