mmmaisel/Keyboard/hw/KeyMatrix-Navblock.kicad_sch

## KiCad design hw/KeyMatrix-Navblock.kicad_sch (2026-01-05)

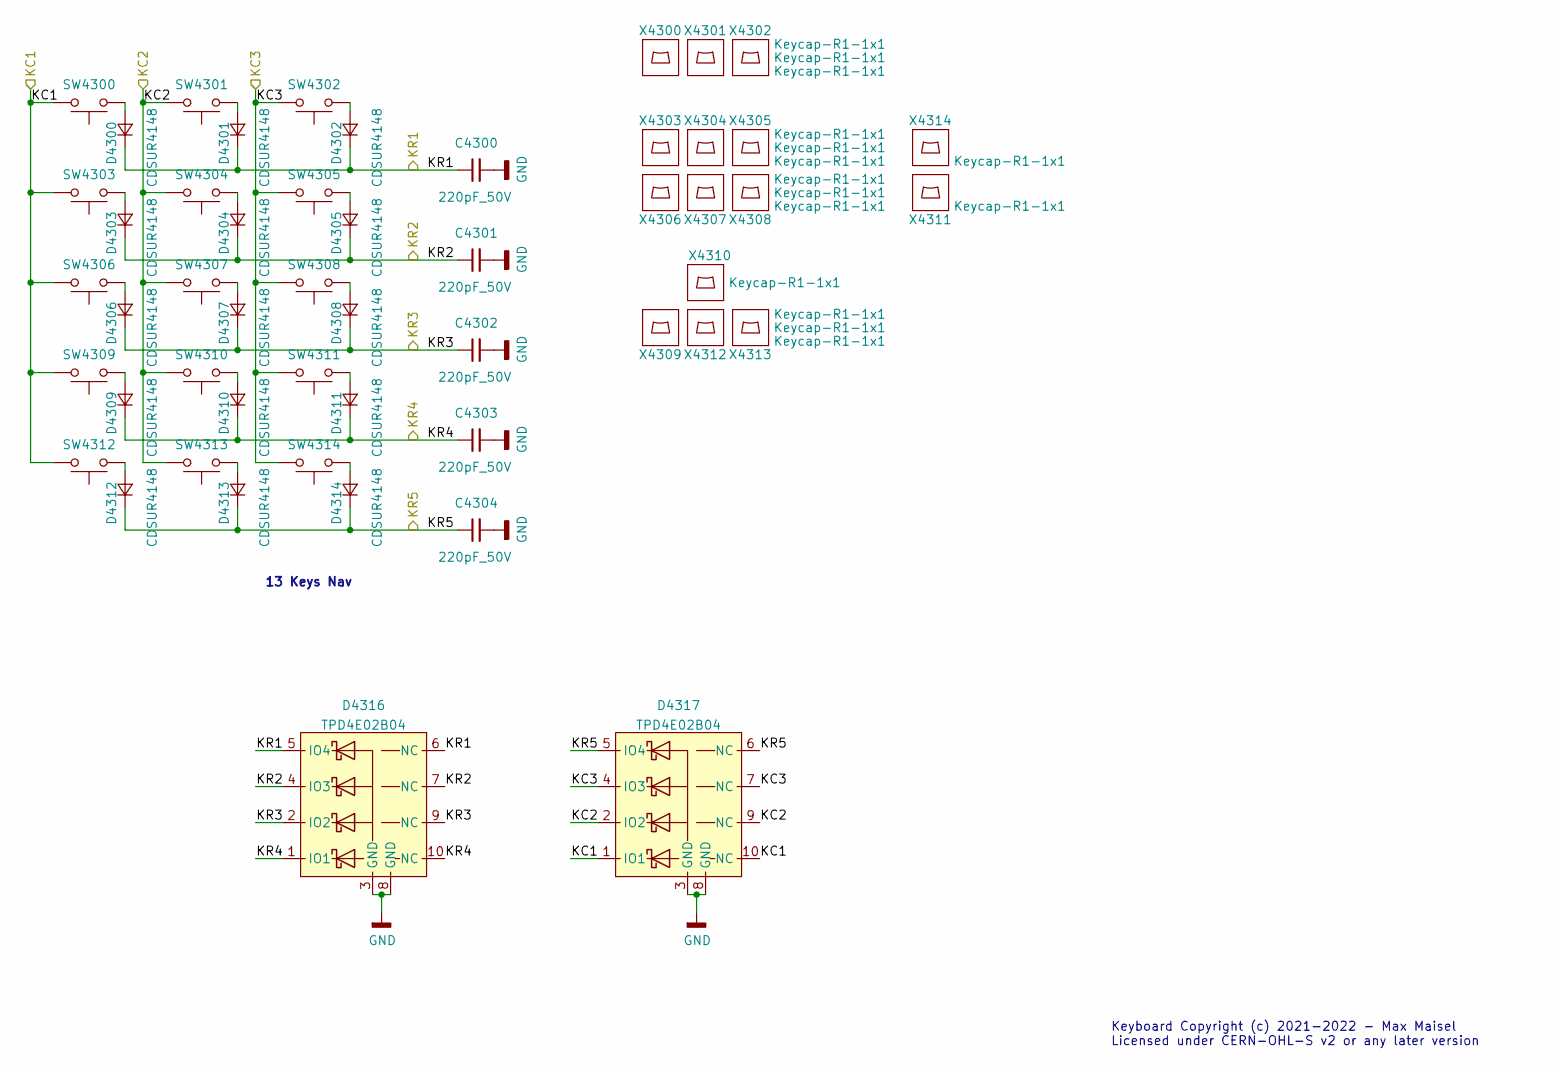
[picture p7: schematic KeyMatrix-Navblock.kicad_sch]

Parts:
C4300, C4301, C4302, C4303, C4304: 220pF_50V; C_0402; mouser# 81-GRM0335C1H221JA1D
D4300, D4301, D4302, D4303, D4304, D4305, D4306, D4307, D4308, D4309, D4310, D4311, D4312, D4313, D4314: CDSUR4148; SOD-523; mouser# 750-CDSUR4148
D4316, D4317: TPD4E02B04; USON10; mouser# 595-TPD4E02B04DQAR
SW4300, SW4301, SW4302, SW4303, SW4304, SW4305, SW4306, SW4307, SW4308, SW4309, SW4310, SW4311, SW4312, SW4313, SW4314: SW_Cherry_MX_RGB; SW_Cherry_MX1A_RGB
X4300, X4301, X4302, X4303, X4304, X4305, X4306, X4307, X4308, X4309, X4310, X4311, X4312, X4313, X4314: Keycap-R1-1x1

Connections:
GND: C4300.2, C4301.2, C4302.2, C4303.2, C4304.2, D4316.3 (GND), D4316.8 (GND), D4317.3 (GND), D4317.8 (GND)
KC1: D4317.1 (IO1), D4317.10 (NC), SW4300.1, SW4303.1, SW4306.1, SW4309.1, SW4312.1
KC2: D4317.2 (IO2), D4317.9 (NC), SW4301.1, SW4304.1, SW4307.1, SW4310.1, SW4313.1
KC3: D4317.4 (IO3), D4317.7 (NC), SW4302.1, SW4305.1, SW4308.1, SW4311.1, SW4314.1
KR1: C4300.1, D4300.1 (K), D4301.1 (K), D4302.1 (K), D4316.5 (IO4), D4316.6 (NC)
KR2: C4301.1, D4303.1 (K), D4304.1 (K), D4305.1 (K), D4316.4 (IO3), D4316.7 (NC)
KR3: C4302.1, D4306.1 (K), D4307.1 (K), D4308.1 (K), D4316.2 (IO2), D4316.9 (NC)
KR4: C4303.1, D4309.1 (K), D4310.1 (K), D4311.1 (K), D4316.1 (IO1), D4316.10 (NC)
KR5: C4304.1, D4312.1 (K), D4313.1 (K), D4314.1 (K), D4317.5 (IO4), D4317.6 (NC)
unnamed: D4300.2 (A), SW4300.2
unnamed: D4301.2 (A), SW4301.2
unnamed: D4302.2 (A), SW4302.2
unnamed: D4303.2 (A), SW4303.2
unnamed: D4304.2 (A), SW4304.2
unnamed: D4305.2 (A), SW4305.2
unnamed: D4306.2 (A), SW4306.2
unnamed: D4307.2 (A), SW4307.2
unnamed: D4308.2 (A), SW4308.2
unnamed: D4309.2 (A), SW4309.2
unnamed: D4310.2 (A), SW4310.2
unnamed: D4311.2 (A), SW4311.2
unnamed: D4312.2 (A), SW4312.2
unnamed: D4313.2 (A), SW4313.2
unnamed: D4314.2 (A), SW4314.2

Notes on the sheet:
Keyboard Copyright (c) 2021-2022 - Max Maisel Licensed under CERN-OHL-S v2 or any later version
13 Keys Nav
