mmmaisel/Keyboard/hw/KeyMatrix-Numblock.kicad_sch

## KiCad design hw/KeyMatrix-Numblock.kicad_sch (2026-01-05)

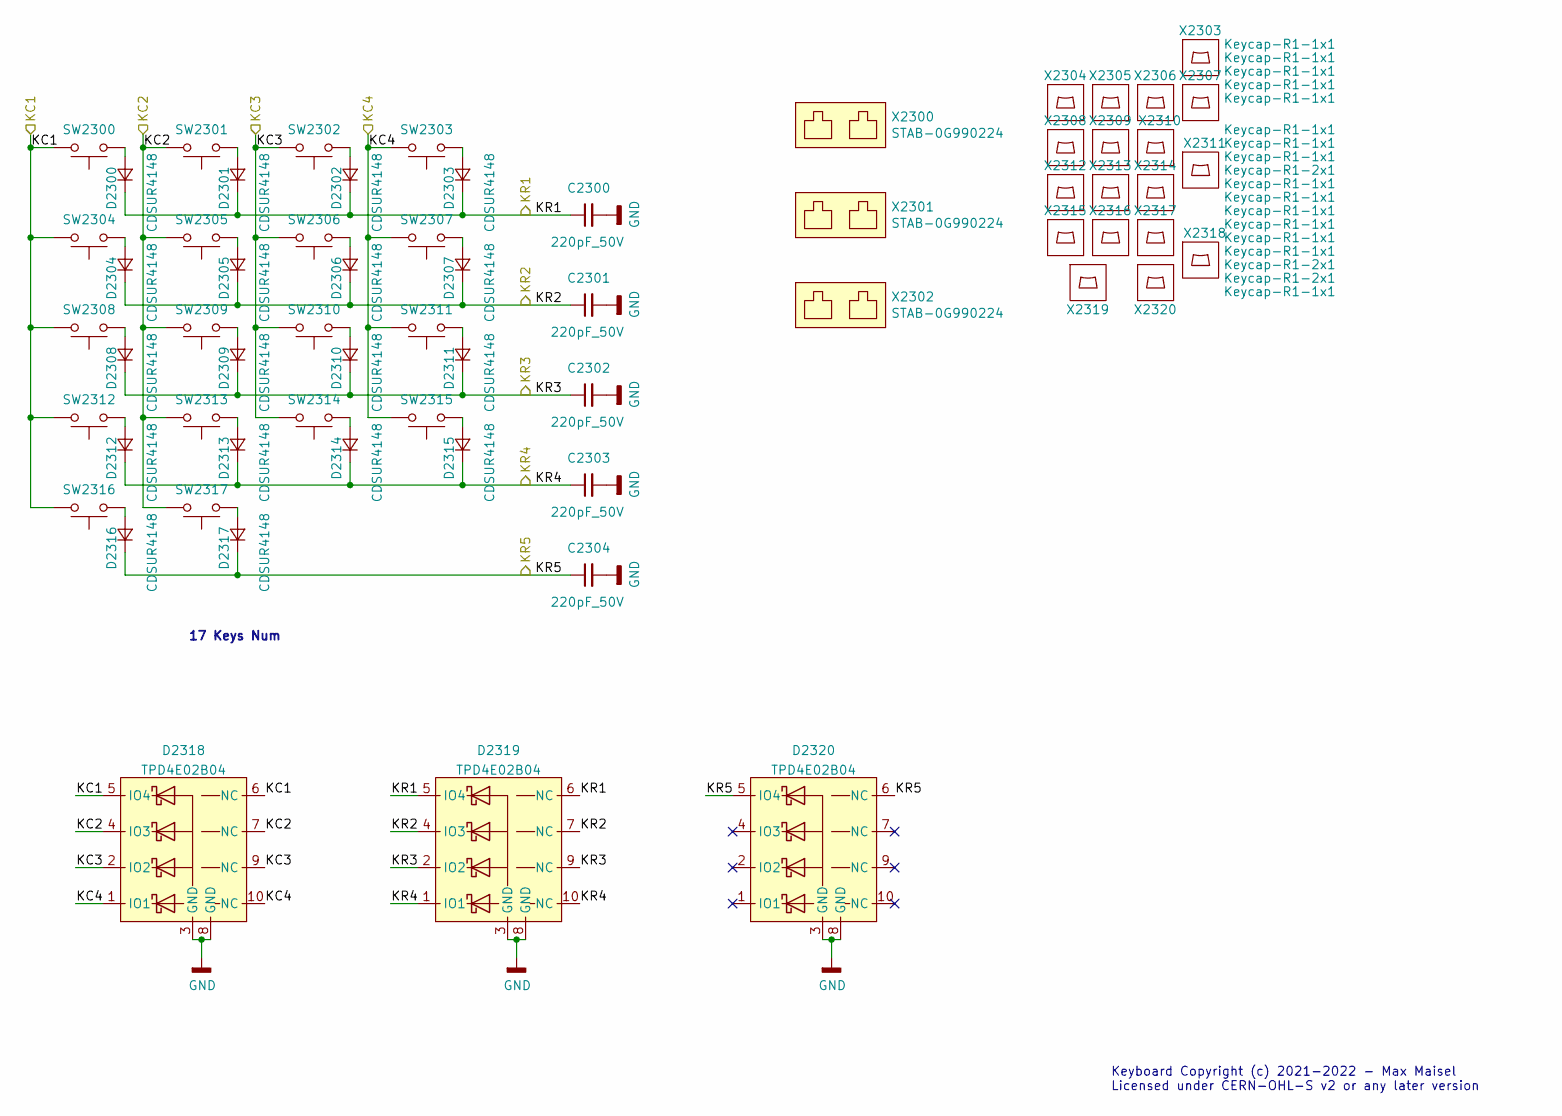
[picture p8: schematic KeyMatrix-Numblock.kicad_sch]

Parts:
C2300, C2301, C2302, C2303, C2304: 220pF_50V; C_0402; mouser# 81-GRM0335C1H221JA1D
D2300, D2301, D2302, D2303, D2304, D2305, D2306, D2307, D2308, D2309, D2310, D2311, D2312, D2313, D2314, D2315, D2316, D2317: CDSUR4148; SOD-523; mouser# 750-CDSUR4148
D2318, D2319, D2320: TPD4E02B04; USON10; mouser# 595-TPD4E02B04DQAR
SW2300, SW2301, SW2302, SW2303, SW2304, SW2305, SW2306, SW2307, SW2308, SW2309, SW2310, SW2311, SW2312, SW2313, SW2314, SW2315, SW2316, SW2317: SW_Cherry_MX_RGB; SW_Cherry_MX1A_RGB
X2300, X2301, X2302: STAB-0G990224; STAB-G99-0224; mouser# 540-G99-0224
X2303, X2304, X2305, X2306, X2307, X2308, X2309, X2310, X2312, X2313, X2314, X2315, X2316, X2317, X2320: Keycap-R1-1x1
X2311, X2318, X2319: Keycap-R1-2x1

Connections:
GND: C2300.2, C2301.2, C2302.2, C2303.2, C2304.2, D2318.3 (GND), D2318.8 (GND), D2319.3 (GND), D2319.8 (GND), D2320.3 (GND), D2320.8 (GND)
KC1: D2318.5 (IO4), D2318.6 (NC), SW2300.1, SW2304.1, SW2308.1, SW2312.1, SW2316.1
KC2: D2318.4 (IO3), D2318.7 (NC), SW2301.1, SW2305.1, SW2309.1, SW2313.1, SW2317.1
KC3: D2318.2 (IO2), D2318.9 (NC), SW2302.1, SW2306.1, SW2310.1, SW2314.1
KC4: D2318.1 (IO1), D2318.10 (NC), SW2303.1, SW2307.1, SW2311.1, SW2315.1
KR1: C2300.1, D2300.1 (K), D2301.1 (K), D2302.1 (K), D2303.1 (K), D2319.5 (IO4), D2319.6 (NC)
KR2: C2301.1, D2304.1 (K), D2305.1 (K), D2306.1 (K), D2307.1 (K), D2319.4 (IO3), D2319.7 (NC)
KR3: C2302.1, D2308.1 (K), D2309.1 (K), D2310.1 (K), D2311.1 (K), D2319.2 (IO2), D2319.9 (NC)
KR4: C2303.1, D2312.1 (K), D2313.1 (K), D2314.1 (K), D2315.1 (K), D2319.1 (IO1), D2319.10 (NC)
KR5: C2304.1, D2316.1 (K), D2317.1 (K), D2320.5 (IO4), D2320.6 (NC)
unnamed: D2300.2 (A), SW2300.2
unnamed: D2301.2 (A), SW2301.2
unnamed: D2302.2 (A), SW2302.2
unnamed: D2303.2 (A), SW2303.2
unnamed: D2304.2 (A), SW2304.2
unnamed: D2305.2 (A), SW2305.2
unnamed: D2306.2 (A), SW2306.2
unnamed: D2307.2 (A), SW2307.2
unnamed: D2308.2 (A), SW2308.2
unnamed: D2309.2 (A), SW2309.2
unnamed: D2310.2 (A), SW2310.2
unnamed: D2311.2 (A), SW2311.2
unnamed: D2312.2 (A), SW2312.2
unnamed: D2313.2 (A), SW2313.2
unnamed: D2314.2 (A), SW2314.2
unnamed: D2315.2 (A), SW2315.2
unnamed: D2316.2 (A), SW2316.2
unnamed: D2317.2 (A), SW2317.2

Notes on the sheet:
Keyboard Copyright (c) 2021-2022 - Max Maisel Licensed under CERN-OHL-S v2 or any later version
17 Keys Num
