mmmaisel/Keyboard/hw/KeyMatrix-Right.kicad_sch

## KiCad design hw/KeyMatrix-Right.kicad_sch (2026-01-05)

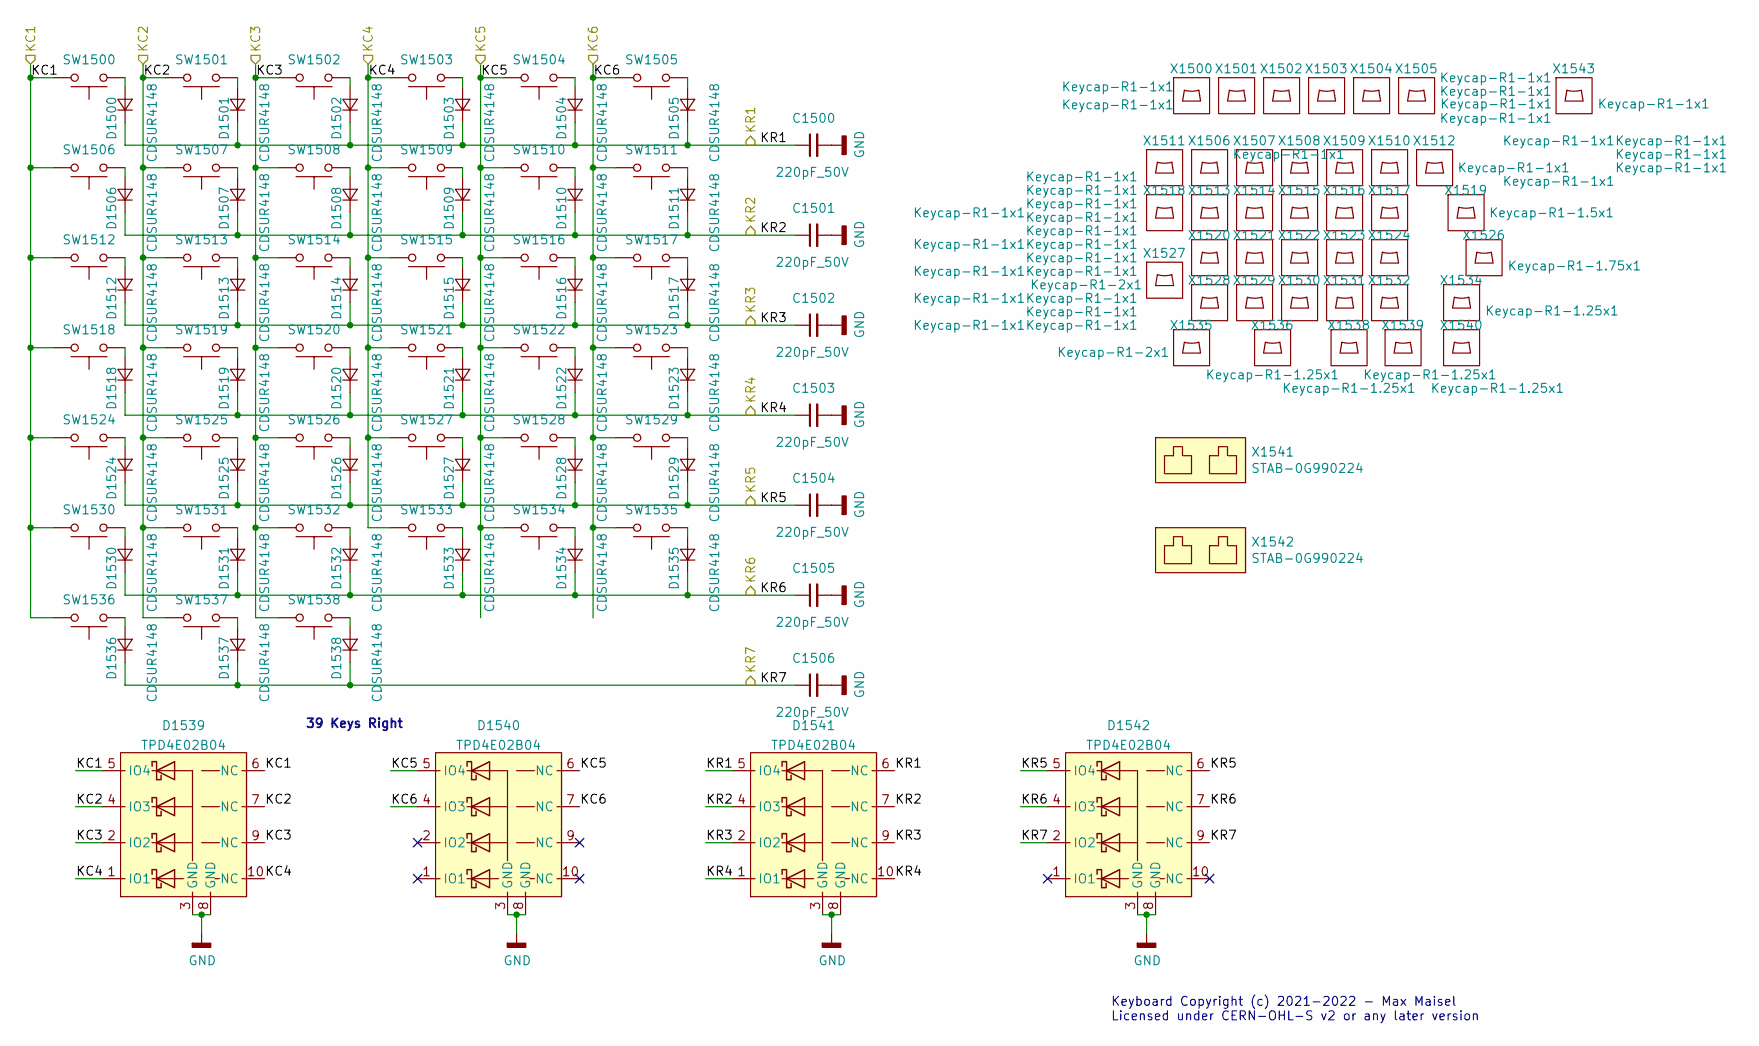
[picture p9: schematic KeyMatrix-Right.kicad_sch]

Parts:
C1500, C1501, C1502, C1503, C1504, C1505, C1506: 220pF_50V; C_0402; mouser# 81-GRM0335C1H221JA1D
D1500, D1501, D1502, D1503, D1504, D1505, D1506, D1507, D1508, D1509, D1510, D1511, D1512, D1513, D1514, D1515, D1516, D1517, D1518, D1519, D1520, D1521, D1522, D1523, D1524, D1525, D1526, D1527, D1528, D1529, D1530, D1531, D1532, D1533, D1534, D1535, D1536, D1537, D1538: CDSUR4148; SOD-523; mouser# 750-CDSUR4148
D1539, D1540, D1541, D1542: TPD4E02B04; USON10; mouser# 595-TPD4E02B04DQAR
SW1500, SW1501, SW1502, SW1503, SW1504, SW1505, SW1506, SW1507, SW1508, SW1509, SW1510, SW1511, SW1512, SW1513, SW1514, SW1515, SW1516, SW1517, SW1518, SW1519, SW1520, SW1521, SW1522, SW1523, SW1524, SW1525, SW1526, SW1527, SW1528, SW1529, SW1530, SW1531, SW1532, SW1533, SW1534, SW1535, SW1536, SW1537, SW1538: SW_Cherry_MX_RGB; SW_Cherry_MX1A_RGB
X1500, X1501, X1502, X1503, X1504, X1505, X1506, X1507, X1508, X1509, X1510, X1511, X1512, X1513, X1514, X1515, X1516, X1517, X1518, X1520, X1521, X1522, X1523, X1524, X1528, X1529, X1530, X1531, X1532, X1543: Keycap-R1-1x1
X1519: Keycap-R1-1.5x1
X1526: Keycap-R1-1.75x1
X1527, X1535: Keycap-R1-2x1
X1534, X1536, X1538, X1539, X1540: Keycap-R1-1.25x1
X1541, X1542: STAB-0G990224; STAB-G99-0224; mouser# 540-G99-0224

Connections:
GND: C1500.2, C1501.2, C1502.2, C1503.2, C1504.2, C1505.2, C1506.2, D1539.3 (GND), D1539.8 (GND), D1540.3 (GND), D1540.8 (GND), D1541.3 (GND), D1541.8 (GND), D1542.3 (GND), D1542.8 (GND)
KC1: D1539.5 (IO4), D1539.6 (NC), SW1500.1, SW1506.1, SW1512.1, SW1518.1, SW1524.1, SW1530.1, SW1536.1
KC2: D1539.4 (IO3), D1539.7 (NC), SW1501.1, SW1507.1, SW1513.1, SW1519.1, SW1525.1, SW1531.1, SW1537.1
KC3: D1539.2 (IO2), D1539.9 (NC), SW1502.1, SW1508.1, SW1514.1, SW1520.1, SW1526.1, SW1532.1, SW1538.1
KC4: D1539.1 (IO1), D1539.10 (NC), SW1503.1, SW1509.1, SW1515.1, SW1521.1, SW1527.1, SW1533.1
KC5: D1540.5 (IO4), D1540.6 (NC), SW1504.1, SW1510.1, SW1516.1, SW1522.1, SW1528.1, SW1534.1
KC6: D1540.4 (IO3), D1540.7 (NC), SW1505.1, SW1511.1, SW1517.1, SW1523.1, SW1529.1, SW1535.1
KR1: C1500.1, D1500.1 (K), D1501.1 (K), D1502.1 (K), D1503.1 (K), D1504.1 (K), D1505.1 (K), D1541.5 (IO4), D1541.6 (NC)
KR2: C1501.1, D1506.1 (K), D1507.1 (K), D1508.1 (K), D1509.1 (K), D1510.1 (K), D1511.1 (K), D1541.4 (IO3), D1541.7 (NC)
KR3: C1502.1, D1512.1 (K), D1513.1 (K), D1514.1 (K), D1515.1 (K), D1516.1 (K), D1517.1 (K), D1541.2 (IO2), D1541.9 (NC)
KR4: C1503.1, D1518.1 (K), D1519.1 (K), D1520.1 (K), D1521.1 (K), D1522.1 (K), D1523.1 (K), D1541.1 (IO1), D1541.10 (NC)
KR5: C1504.1, D1524.1 (K), D1525.1 (K), D1526.1 (K), D1527.1 (K), D1528.1 (K), D1529.1 (K), D1542.5 (IO4), D1542.6 (NC)
KR6: C1505.1, D1530.1 (K), D1531.1 (K), D1532.1 (K), D1533.1 (K), D1534.1 (K), D1535.1 (K), D1542.4 (IO3), D1542.7 (NC)
KR7: C1506.1, D1536.1 (K), D1537.1 (K), D1538.1 (K), D1542.2 (IO2), D1542.9 (NC)
unnamed: D1500.2 (A), SW1500.2
unnamed: D1501.2 (A), SW1501.2
unnamed: D1502.2 (A), SW1502.2
unnamed: D1503.2 (A), SW1503.2
unnamed: D1504.2 (A), SW1504.2
unnamed: D1505.2 (A), SW1505.2
unnamed: D1506.2 (A), SW1506.2
unnamed: D1507.2 (A), SW1507.2
unnamed: D1508.2 (A), SW1508.2
unnamed: D1509.2 (A), SW1509.2
unnamed: D1510.2 (A), SW1510.2
unnamed: D1511.2 (A), SW1511.2
unnamed: D1512.2 (A), SW1512.2
unnamed: D1513.2 (A), SW1513.2
unnamed: D1514.2 (A), SW1514.2
unnamed: D1515.2 (A), SW1515.2
unnamed: D1516.2 (A), SW1516.2
unnamed: D1517.2 (A), SW1517.2
unnamed: D1518.2 (A), SW1518.2
unnamed: D1519.2 (A), SW1519.2
unnamed: D1520.2 (A), SW1520.2
unnamed: D1521.2 (A), SW1521.2
unnamed: D1522.2 (A), SW1522.2
unnamed: D1523.2 (A), SW1523.2
unnamed: D1524.2 (A), SW1524.2
unnamed: D1525.2 (A), SW1525.2
unnamed: D1526.2 (A), SW1526.2
unnamed: D1527.2 (A), SW1527.2
unnamed: D1528.2 (A), SW1528.2
unnamed: D1529.2 (A), SW1529.2
unnamed: D1530.2 (A), SW1530.2
unnamed: D1531.2 (A), SW1531.2
unnamed: D1532.2 (A), SW1532.2
unnamed: D1533.2 (A), SW1533.2
unnamed: D1534.2 (A), SW1534.2
unnamed: D1535.2 (A), SW1535.2
unnamed: D1536.2 (A), SW1536.2
unnamed: D1537.2 (A), SW1537.2
unnamed: D1538.2 (A), SW1538.2

Notes on the sheet:
39 Keys Right
Keyboard Copyright (c) 2021-2022 - Max Maisel Licensed under CERN-OHL-S v2 or any later version
