mmmaisel/Keyboard/hw/Keyboard-Left.kicad_sch

## KiCad design hw/Keyboard-Left.kicad_sch (2026-01-05)

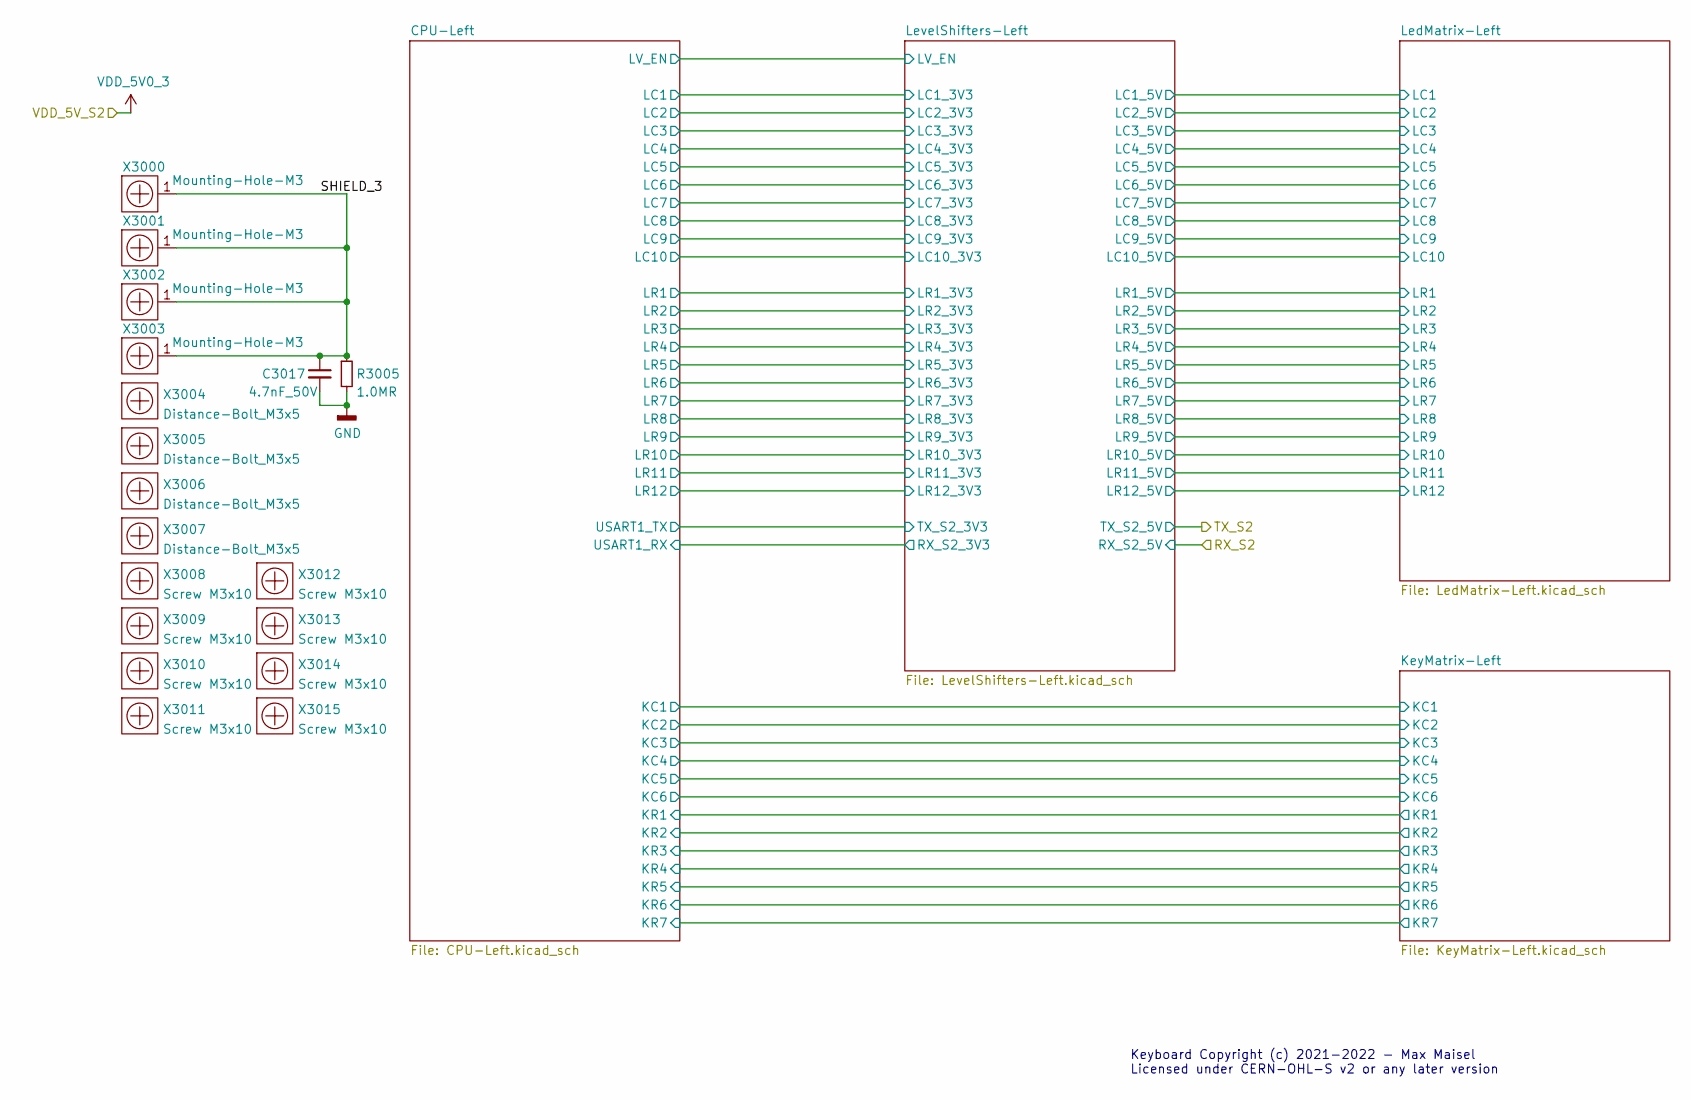
[picture p10: schematic Keyboard-Left.kicad_sch]

Parts:
C3017: 4.7nF_50V; C_0402; mouser# 810-CGA2B2X7R1H472K
R3005: 1.0MR; R_0402; mouser# 667-ERJ-2RKF1004X
X3000, X3001, X3002, X3003: Mounting-Hole-M3
X3004, X3005, X3006, X3007: Distance-Bolt_M3x5; DistanceBolt-6x3.5
X3008, X3009, X3010, X3011, X3012, X3013, X3014, X3015: Screw M3x10

Connections:
GND: C3017.2, R3005.2
SHIELD_3: C3017.1, R3005.1, X3000.1, X3001.1, X3002.1, X3003.1

Notes on the sheet:
Keyboard Copyright (c) 2021-2022 - Max Maisel Licensed under CERN-OHL-S v2 or any later version
