mmmaisel/Keyboard/hw/Keyboard-Navblock.kicad_sch

## KiCad design hw/Keyboard-Navblock.kicad_sch (2026-01-05)

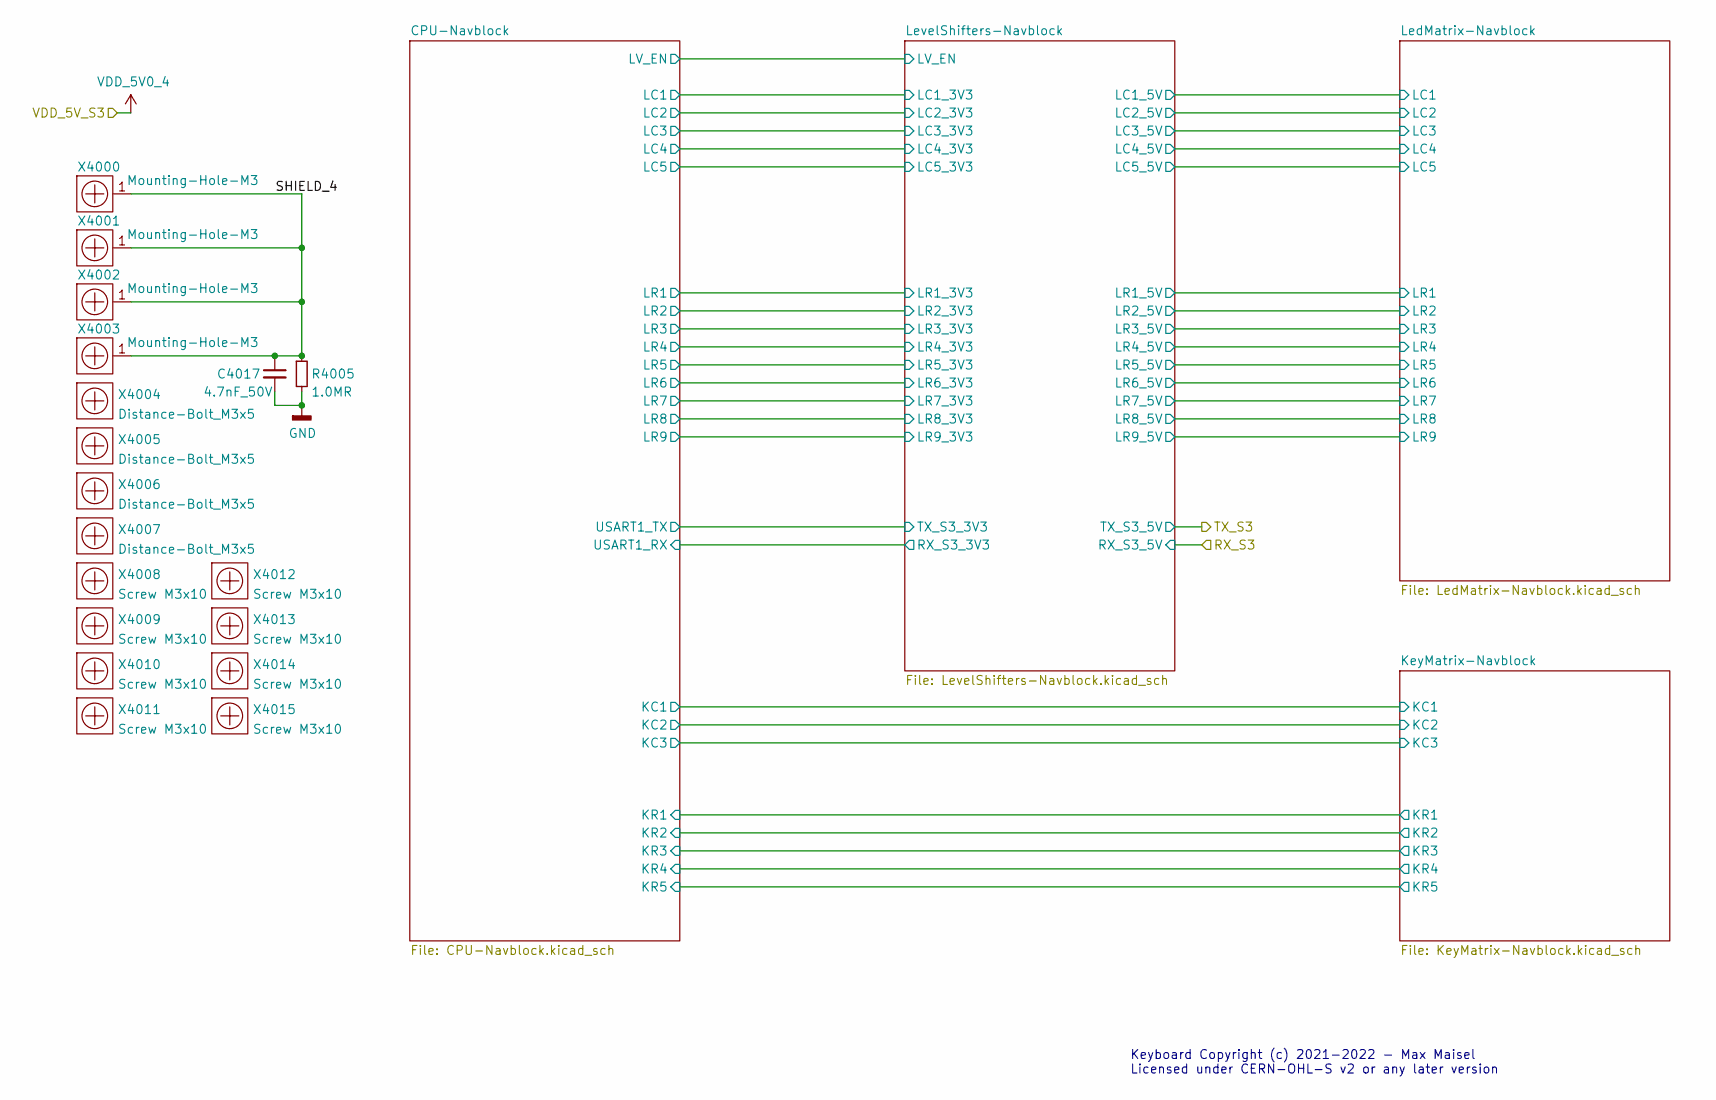
[picture p11: schematic Keyboard-Navblock.kicad_sch]

Parts:
C4017: 4.7nF_50V; C_0402; mouser# 810-CGA2B2X7R1H472K
R4005: 1.0MR; R_0402; mouser# 667-ERJ-2RKF1004X
X4000, X4001, X4002, X4003: Mounting-Hole-M3
X4004, X4005, X4006, X4007: Distance-Bolt_M3x5; DistanceBolt-6x3.5
X4008, X4009, X4010, X4011, X4012, X4013, X4014, X4015: Screw M3x10

Connections:
GND: C4017.2, R4005.2
SHIELD_4: C4017.1, R4005.1, X4000.1, X4001.1, X4002.1, X4003.1

Notes on the sheet:
Keyboard Copyright (c) 2021-2022 - Max Maisel Licensed under CERN-OHL-S v2 or any later version
