mmmaisel/Keyboard/hw/Keyboard-Numblock.kicad_sch

## KiCad design hw/Keyboard-Numblock.kicad_sch (2026-01-05)

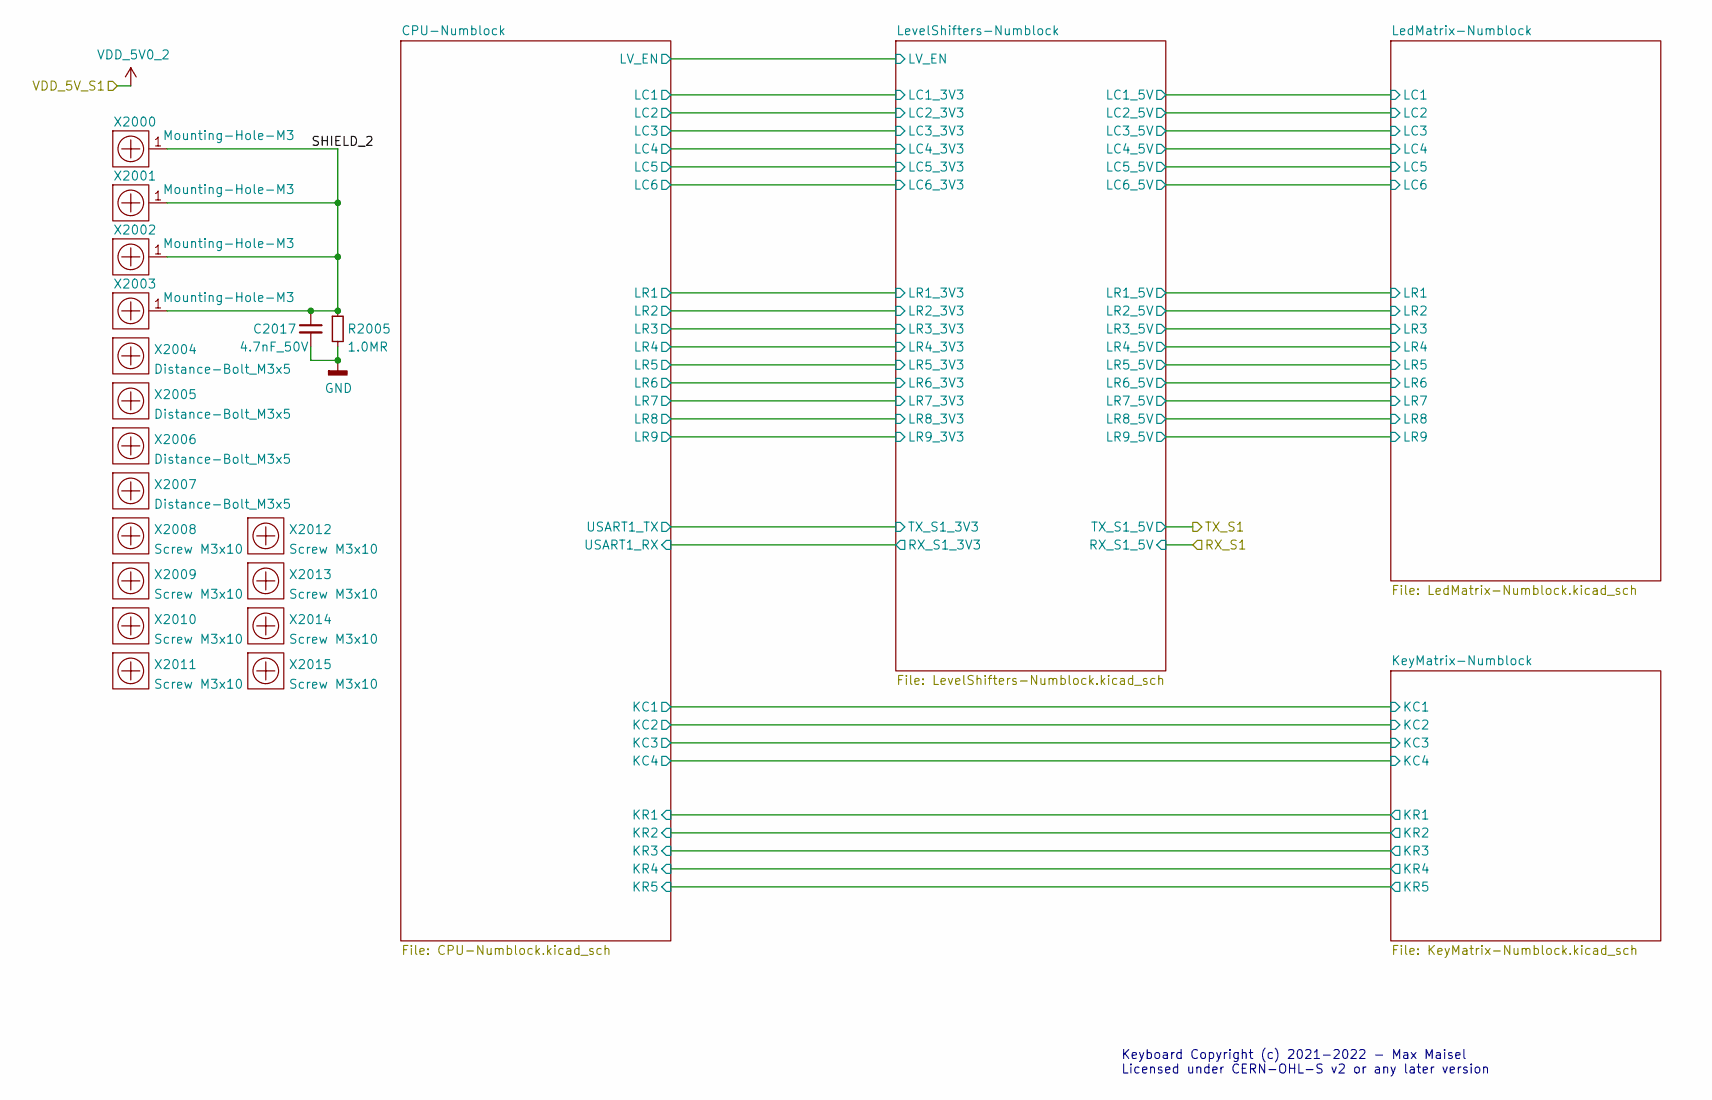
[picture p12: schematic Keyboard-Numblock.kicad_sch]

Parts:
C2017: 4.7nF_50V; C_0402; mouser# 810-CGA2B2X7R1H472K
R2005: 1.0MR; R_0402; mouser# 667-ERJ-2RKF1004X
X2000, X2001, X2002, X2003: Mounting-Hole-M3
X2004, X2005, X2006, X2007: Distance-Bolt_M3x5; DistanceBolt-6x3.5
X2008, X2009, X2010, X2011, X2012, X2013, X2014, X2015: Screw M3x10

Connections:
GND: C2017.2, R2005.2
SHIELD_2: C2017.1, R2005.1, X2000.1, X2001.1, X2002.1, X2003.1

Notes on the sheet:
Keyboard Copyright (c) 2021-2022 - Max Maisel Licensed under CERN-OHL-S v2 or any later version
