mmmaisel/Keyboard/hw/Keyboard-Right.kicad_sch

## KiCad design hw/Keyboard-Right.kicad_sch (2026-01-05)

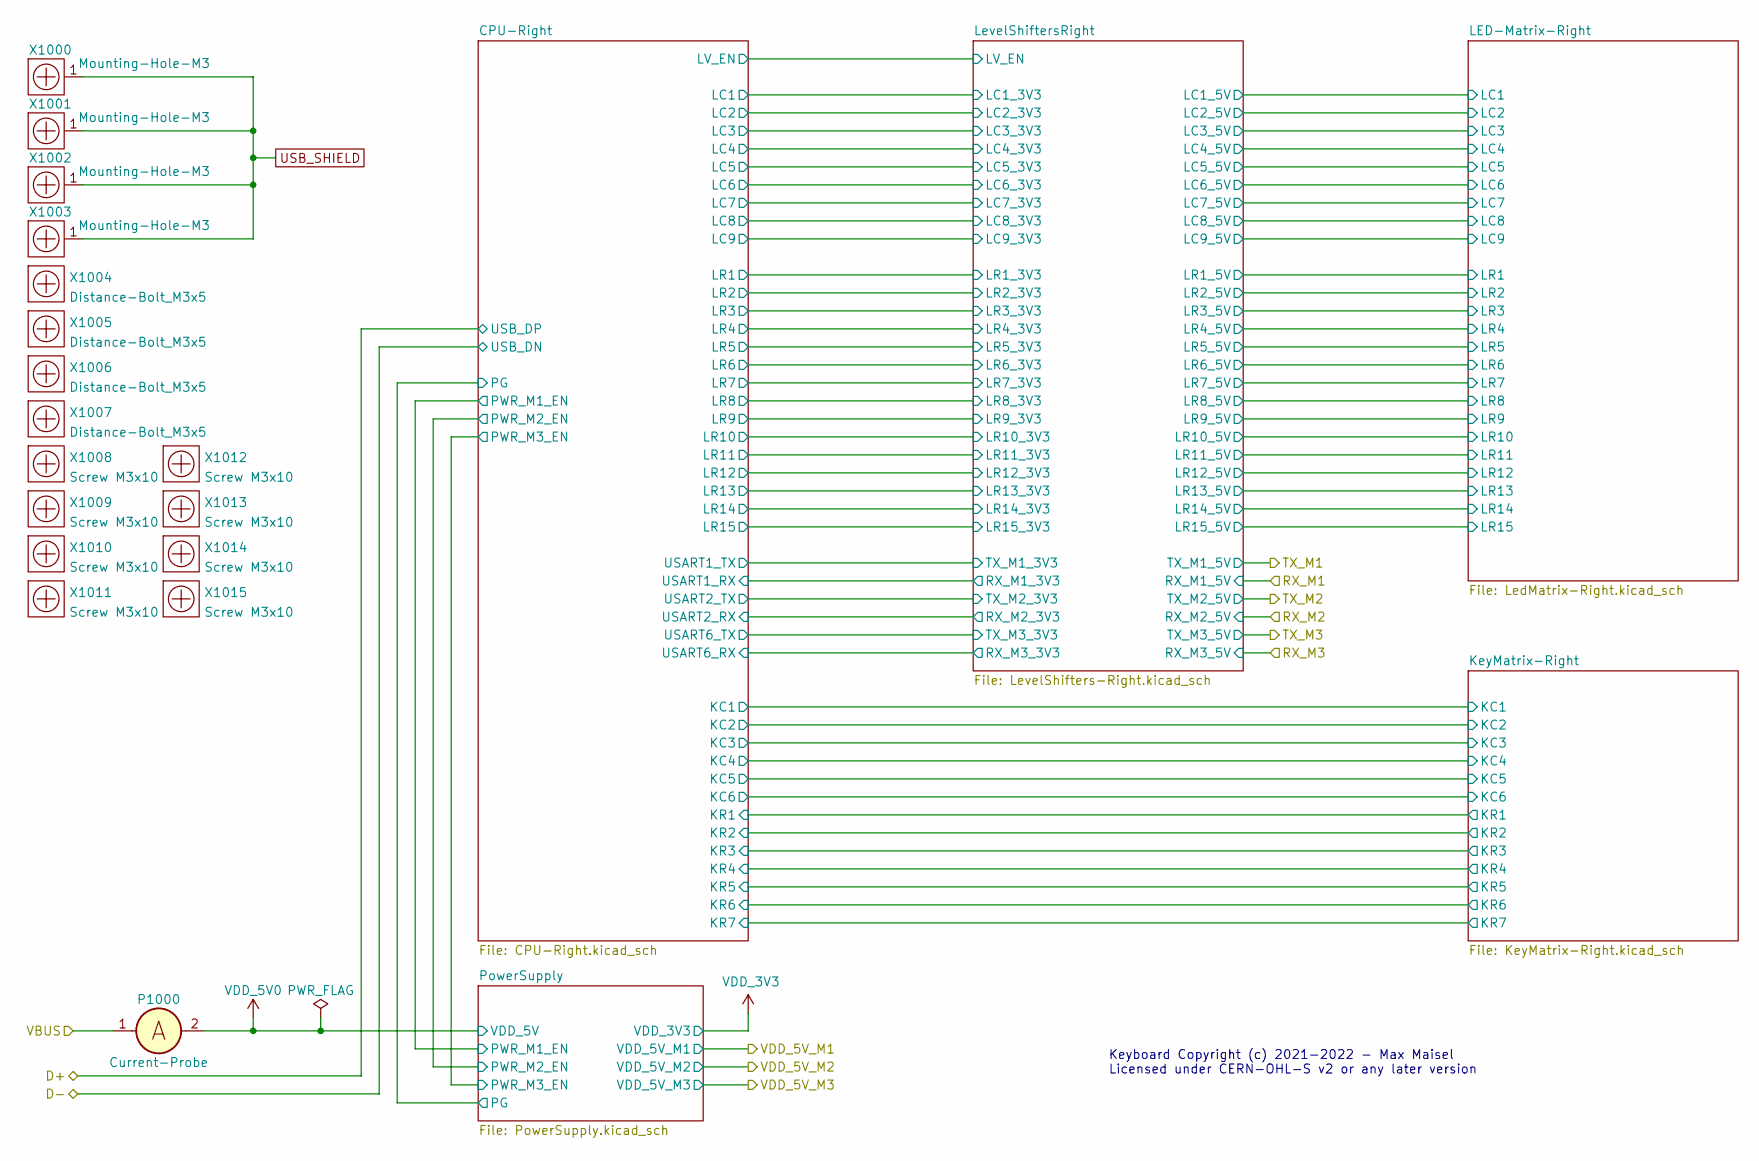
[picture p13: schematic Keyboard-Right.kicad_sch]

Parts:
P1000: Current-Probe; Current-Probe-2.54
X1000, X1001, X1002, X1003: Mounting-Hole-M3
X1004, X1005, X1006, X1007: Distance-Bolt_M3x5; DistanceBolt-6x3.5
X1008, X1009, X1010, X1011, X1012, X1013, X1014, X1015: Screw M3x10

Connections:
USB_SHIELD: X1000.1, X1001.1, X1002.1, X1003.1
VBUS: P1000.1
VDD_5V0: P1000.2

Notes on the sheet:
Keyboard Copyright (c) 2021-2022 - Max Maisel Licensed under CERN-OHL-S v2 or any later version
