mmmaisel/Keyboard/hw/Keyboard.kicad_sch

## KiCad design hw/Keyboard.kicad_sch (2026-01-05)

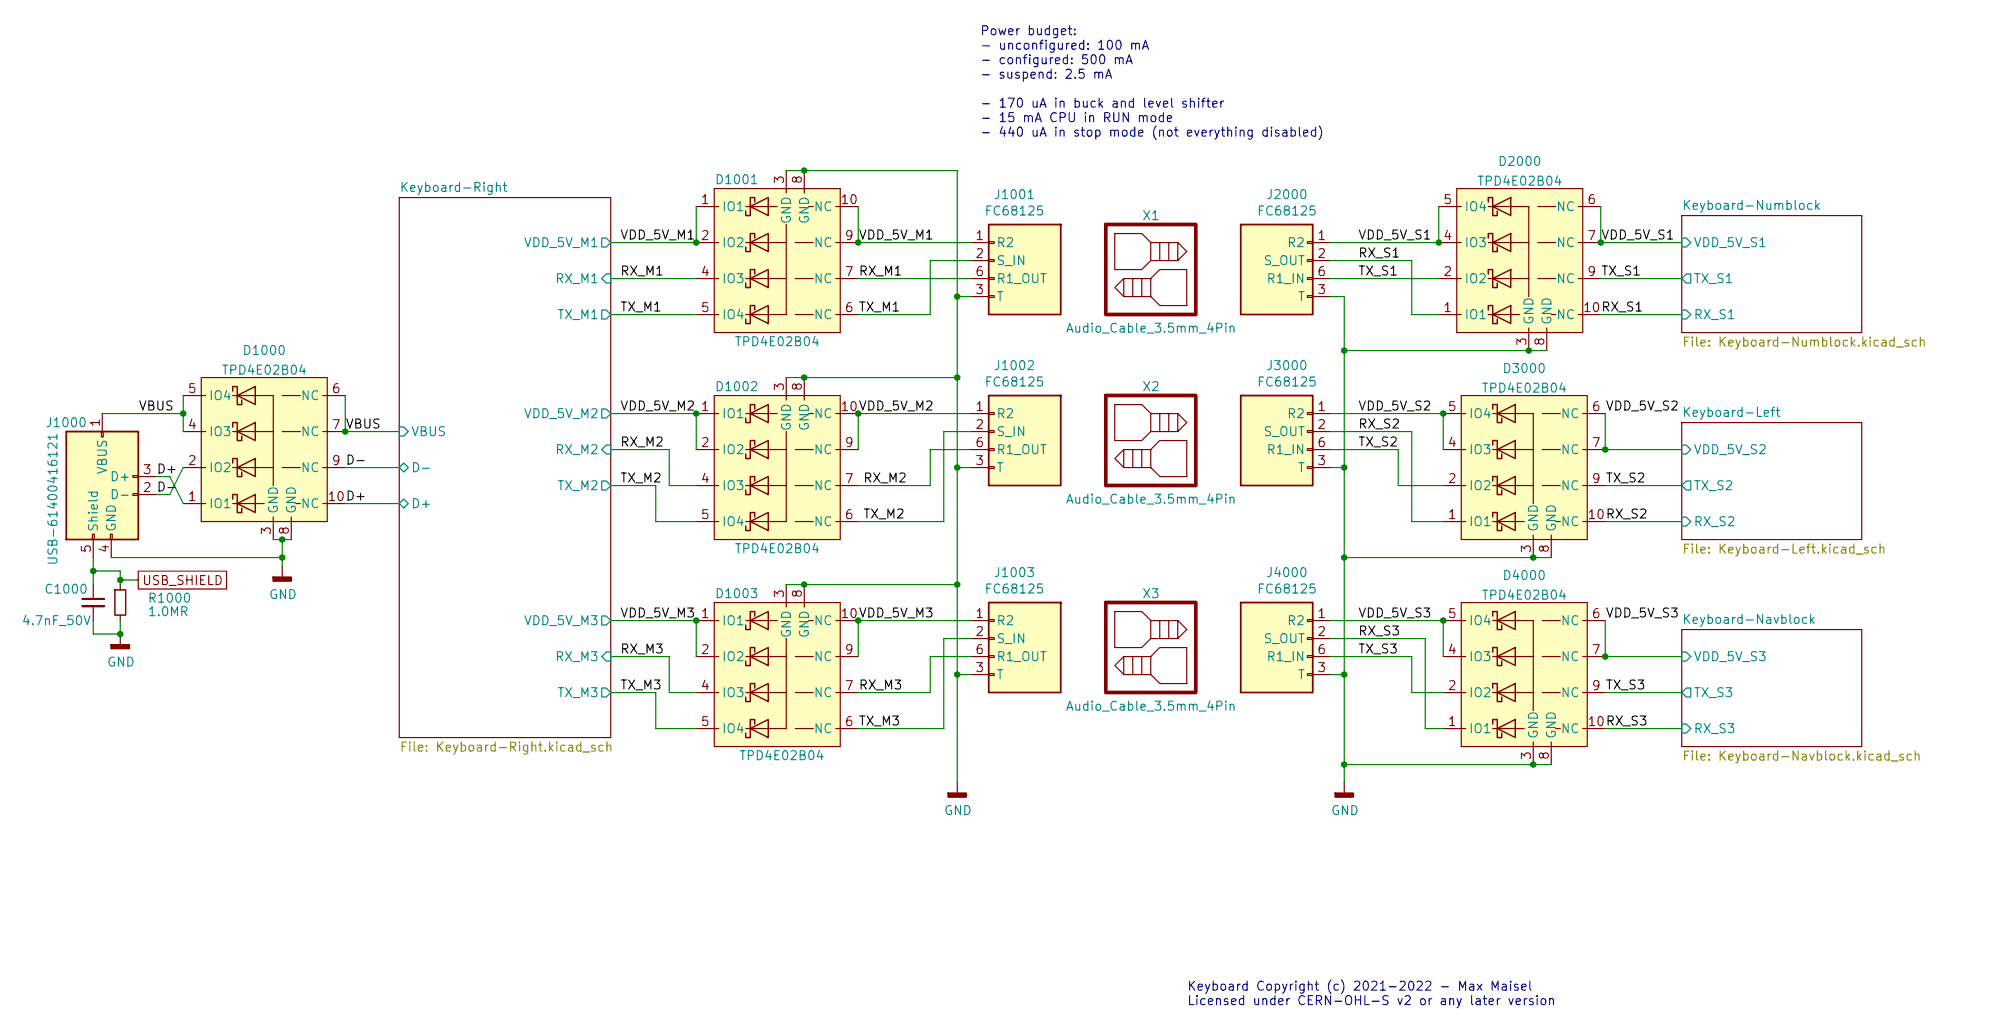
[picture p14: schematic Keyboard.kicad_sch]

Parts:
C1000: 4.7nF_50V; C_0402; mouser# 810-CGA2B2X7R1H472K
D1000, D1001, D1002, D1003, D2000, D3000, D4000: TPD4E02B04; USON10; mouser# 595-TPD4E02B04DQAR
J1000: USB-61400416121
J1001, J1002, J1003, J2000, J3000, J4000: FC68125
R1000: 1.0MR; R_0402; mouser# 667-ERJ-2RKF1004X
X1, X2, X3: Audio_Cable_3.5mm_4Pin

Connections:
D+: D1000.1 (IO1), D1000.10 (NC), J1000.3 (D+)
D-: D1000.2 (IO2), D1000.9 (NC), J1000.2 (D-)
GND: C1000.2, D1000.3 (GND), D1000.8 (GND), D1001.3 (GND), D1001.8 (GND), D1002.3 (GND), D1002.8 (GND), D1003.3 (GND), D1003.8 (GND), D2000.3 (GND), D2000.8 (GND), D3000.3 (GND), D3000.8 (GND), D4000.3 (GND), D4000.8 (GND), J1000.4 (GND), J1001.3 (T), J1002.3 (T), J1003.3 (T), J2000.3 (T), J3000.3 (T), J4000.3 (T), R1000.2
RX_M1: D1001.4 (IO3), D1001.7 (NC), J1001.6 (R1)
RX_M2: D1002.4 (IO3), D1002.7 (NC), J1002.6 (R1)
RX_M3: D1003.4 (IO3), D1003.7 (NC), J1003.6 (R1)
RX_S1: D2000.1 (IO1), D2000.10 (NC), J2000.2 (S)
RX_S2: D3000.1 (IO1), D3000.10 (NC), J3000.2 (S)
RX_S3: D4000.1 (IO1), D4000.10 (NC), J4000.2 (S)
TX_M1: D1001.5 (IO4), D1001.6 (NC), J1001.2 (S)
TX_M2: D1002.5 (IO4), D1002.6 (NC), J1002.2 (S)
TX_M3: D1003.5 (IO4), D1003.6 (NC), J1003.2 (S)
TX_S1: D2000.2 (IO2), D2000.9 (NC), J2000.6 (R1)
TX_S2: D3000.2 (IO2), D3000.9 (NC), J3000.6 (R1)
TX_S3: D4000.2 (IO2), D4000.9 (NC), J4000.6 (R1)
USB_SHIELD: C1000.1, J1000.5 (Shield), R1000.1
VBUS: D1000.4 (IO3), D1000.5 (IO4), D1000.6 (NC), D1000.7 (NC), J1000.1 (VBUS)
VDD_5V_M1: D1001.1 (IO1), D1001.2 (IO2), D1001.9 (NC), D1001.10 (NC), J1001.1 (R2)
VDD_5V_M2: D1002.1 (IO1), D1002.2 (IO2), D1002.9 (NC), D1002.10 (NC), J1002.1 (R2)
VDD_5V_M3: D1003.1 (IO1), D1003.2 (IO2), D1003.9 (NC), D1003.10 (NC), J1003.1 (R2)
VDD_5V_S1: D2000.4 (IO3), D2000.5 (IO4), D2000.6 (NC), D2000.7 (NC), J2000.1 (R2)
VDD_5V_S2: D3000.4 (IO3), D3000.5 (IO4), D3000.6 (NC), D3000.7 (NC), J3000.1 (R2)
VDD_5V_S3: D4000.4 (IO3), D4000.5 (IO4), D4000.6 (NC), D4000.7 (NC), J4000.1 (R2)

Notes on the sheet:
Power budget: - unconfigured: 100 mA - configured: 500 mA - suspend: 2.5 mA - 170 uA in buck and level shifter - 15 mA CPU in RUN mode - 440 uA in stop mode (not everything disabled)
Keyboard Copyright (c) 2021-2022 - Max Maisel Licensed under CERN-OHL-S v2 or any later version
