mmmaisel/Keyboard/hw/LedMatrix-Left.kicad_sch

## KiCad design hw/LedMatrix-Left.kicad_sch (2026-01-05)

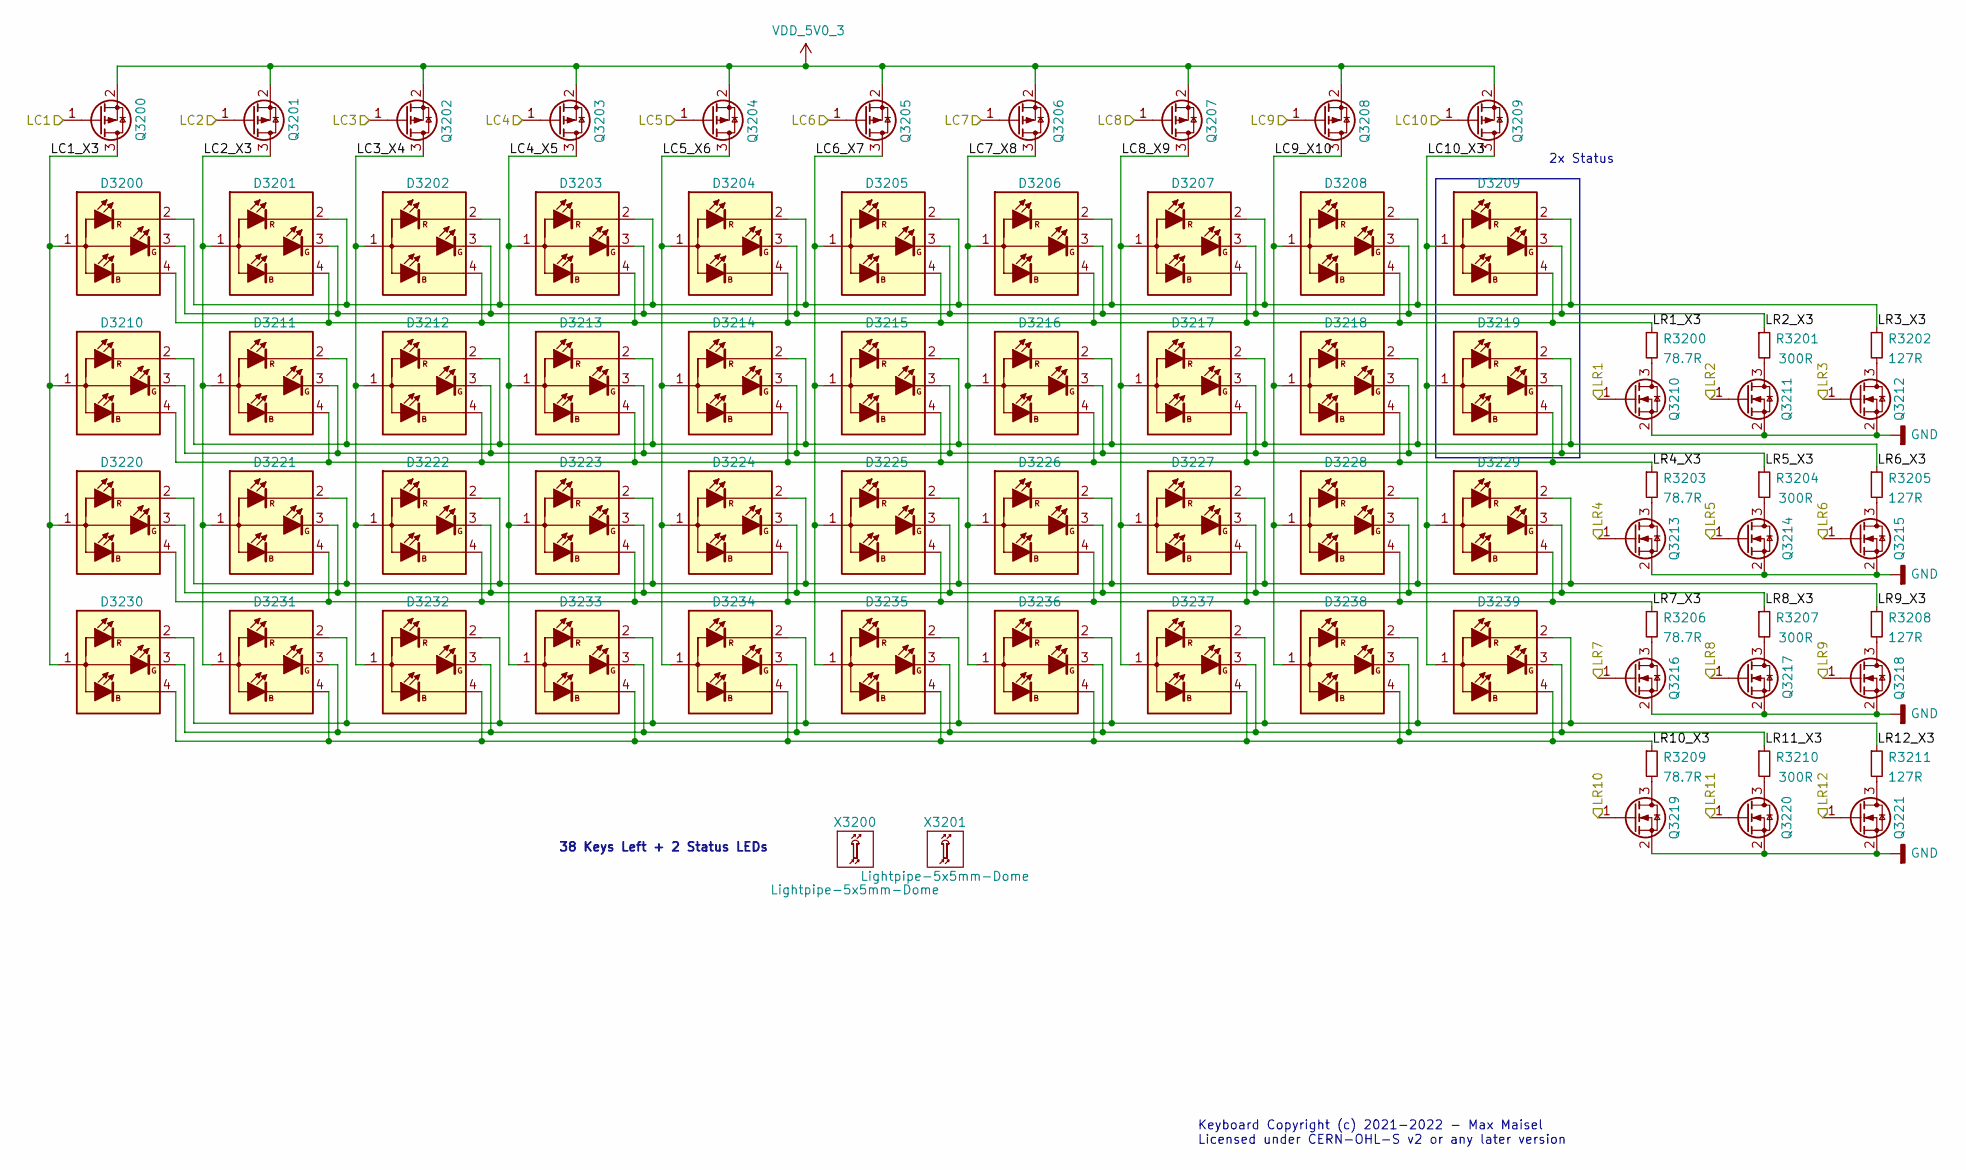
[picture p15: schematic LedMatrix-Left.kicad_sch]

Parts:
D3200, D3201, D3202, D3203, D3204, D3205, D3206, D3207, D3208, D3209, D3210, D3211, D3212, D3213, D3214, D3215, D3216, D3217, D3218, D3219, D3220, D3221, D3222, D3223, D3224, D3225, D3226, D3227, D3228, D3229, D3230, D3231, D3232, D3233, D3234, D3235, D3236, D3237, D3238, D3239: APTF1616LSEEZGKQBKC; APTF1616-RGB; mouser# 604-APTF1616LSEEZGKQ
Q3200, Q3201, Q3202, Q3203, Q3204, Q3205, Q3206, Q3207, Q3208, Q3209: NTA4151P; SC-75; mouser# 863-NTA4151PT1G; digikey# DTA114EET1GOSCT-ND
Q3210, Q3211, Q3212, Q3213, Q3214, Q3215, Q3216, Q3217, Q3218, Q3219, Q3220, Q3221: NTA4153N; SC-75; mouser# 863-NTA4153NT1G
R3200, R3203, R3206, R3209: 78.7R; R_0402; mouser# 603-RC0402FR-0778R7L
R3201, R3204, R3207, R3210: 300R; R_0402; mouser# 667-ERJ-2RKF3000X
R3202, R3205, R3208, R3211: 127R; R_0402; mouser# 603-RC0402FR-07127RL
X3200, X3201: Lightpipe-5x5mm-Dome; Lightpipe-51513530188F; mouser# 645-51513530188F

Connections:
GND: Q3210.2 (S), Q3211.2 (S), Q3212.2 (S), Q3213.2 (S), Q3214.2 (S), Q3215.2 (S), Q3216.2 (S), Q3217.2 (S), Q3218.2 (S), Q3219.2 (S), Q3220.2 (S), Q3221.2 (S)
LC1: Q3200.1 (G)
LC1_X3: D3200.1 (A), D3210.1 (A), D3220.1 (A), D3230.1 (A), Q3200.3 (D)
LC2: Q3201.1 (G)
LC2_X3: D3201.1 (A), D3211.1 (A), D3221.1 (A), D3231.1 (A), Q3201.3 (D)
LC3: Q3202.1 (G)
LC3_X4: D3202.1 (A), D3212.1 (A), D3222.1 (A), D3232.1 (A), Q3202.3 (D)
LC4: Q3203.1 (G)
LC4_X5: D3203.1 (A), D3213.1 (A), D3223.1 (A), D3233.1 (A), Q3203.3 (D)
LC5: Q3204.1 (G)
LC5_X6: D3204.1 (A), D3214.1 (A), D3224.1 (A), D3234.1 (A), Q3204.3 (D)
LC6: Q3205.1 (G)
LC6_X7: D3205.1 (A), D3215.1 (A), D3225.1 (A), D3235.1 (A), Q3205.3 (D)
LC7: Q3206.1 (G)
LC7_X8: D3206.1 (A), D3216.1 (A), D3226.1 (A), D3236.1 (A), Q3206.3 (D)
LC8: Q3207.1 (G)
LC8_X9: D3207.1 (A), D3217.1 (A), D3227.1 (A), D3237.1 (A), Q3207.3 (D)
LC9: Q3208.1 (G)
LC9_X10: D3208.1 (A), D3218.1 (A), D3228.1 (A), D3238.1 (A), Q3208.3 (D)
LC10: Q3209.1 (G)
LC10_X3: D3209.1 (A), D3219.1 (A), D3229.1 (A), D3239.1 (A), Q3209.3 (D)
LR1: Q3210.1 (G)
LR1_X3: D3200.4 (KB), D3201.4 (KB), D3202.4 (KB), D3203.4 (KB), D3204.4 (KB), D3205.4 (KB), D3206.4 (KB), D3207.4 (KB), D3208.4 (KB), D3209.4 (KB), R3200.1
LR2: Q3211.1 (G)
LR2_X3: D3200.3 (KG), D3201.3 (KG), D3202.3 (KG), D3203.3 (KG), D3204.3 (KG), D3205.3 (KG), D3206.3 (KG), D3207.3 (KG), D3208.3 (KG), D3209.3 (KG), R3201.1
LR3: Q3212.1 (G)
LR3_X3: D3200.2 (KR), D3201.2 (KR), D3202.2 (KR), D3203.2 (KR), D3204.2 (KR), D3205.2 (KR), D3206.2 (KR), D3207.2 (KR), D3208.2 (KR), D3209.2 (KR), R3202.1
LR4: Q3213.1 (G)
LR4_X3: D3210.4 (KB), D3211.4 (KB), D3212.4 (KB), D3213.4 (KB), D3214.4 (KB), D3215.4 (KB), D3216.4 (KB), D3217.4 (KB), D3218.4 (KB), D3219.4 (KB), R3203.1
LR5: Q3214.1 (G)
LR5_X3: D3210.3 (KG), D3211.3 (KG), D3212.3 (KG), D3213.3 (KG), D3214.3 (KG), D3215.3 (KG), D3216.3 (KG), D3217.3 (KG), D3218.3 (KG), D3219.3 (KG), R3204.1
LR6: Q3215.1 (G)
LR6_X3: D3210.2 (KR), D3211.2 (KR), D3212.2 (KR), D3213.2 (KR), D3214.2 (KR), D3215.2 (KR), D3216.2 (KR), D3217.2 (KR), D3218.2 (KR), D3219.2 (KR), R3205.1
LR7: Q3216.1 (G)
LR7_X3: D3220.4 (KB), D3221.4 (KB), D3222.4 (KB), D3223.4 (KB), D3224.4 (KB), D3225.4 (KB), D3226.4 (KB), D3227.4 (KB), D3228.4 (KB), D3229.4 (KB), R3206.1
LR8: Q3217.1 (G)
LR8_X3: D3220.3 (KG), D3221.3 (KG), D3222.3 (KG), D3223.3 (KG), D3224.3 (KG), D3225.3 (KG), D3226.3 (KG), D3227.3 (KG), D3228.3 (KG), D3229.3 (KG), R3207.1
LR9: Q3218.1 (G)
LR9_X3: D3220.2 (KR), D3221.2 (KR), D3222.2 (KR), D3223.2 (KR), D3224.2 (KR), D3225.2 (KR), D3226.2 (KR), D3227.2 (KR), D3228.2 (KR), D3229.2 (KR), R3208.1
LR10: Q3219.1 (G)
LR10_X3: D3230.4 (KB), D3231.4 (KB), D3232.4 (KB), D3233.4 (KB), D3234.4 (KB), D3235.4 (KB), D3236.4 (KB), D3237.4 (KB), D3238.4 (KB), D3239.4 (KB), R3209.1
LR11: Q3220.1 (G)
LR11_X3: D3230.3 (KG), D3231.3 (KG), D3232.3 (KG), D3233.3 (KG), D3234.3 (KG), D3235.3 (KG), D3236.3 (KG), D3237.3 (KG), D3238.3 (KG), D3239.3 (KG), R3210.1
LR12: Q3221.1 (G)
LR12_X3: D3230.2 (KR), D3231.2 (KR), D3232.2 (KR), D3233.2 (KR), D3234.2 (KR), D3235.2 (KR), D3236.2 (KR), D3237.2 (KR), D3238.2 (KR), D3239.2 (KR), R3211.1
unnamed: Q3210.3 (D), R3200.2
unnamed: Q3211.3 (D), R3201.2
unnamed: Q3212.3 (D), R3202.2
unnamed: Q3213.3 (D), R3203.2
unnamed: Q3214.3 (D), R3204.2
unnamed: Q3215.3 (D), R3205.2
unnamed: Q3216.3 (D), R3206.2
unnamed: Q3217.3 (D), R3207.2
unnamed: Q3218.3 (D), R3208.2
unnamed: Q3219.3 (D), R3209.2
unnamed: Q3220.3 (D), R3210.2
unnamed: Q3221.3 (D), R3211.2
VDD_5V0_3: Q3200.2 (S), Q3201.2 (S), Q3202.2 (S), Q3203.2 (S), Q3204.2 (S), Q3205.2 (S), Q3206.2 (S), Q3207.2 (S), Q3208.2 (S), Q3209.2 (S)

Notes on the sheet:
38 Keys Left + 2 Status LEDs
2x Status
Keyboard Copyright (c) 2021-2022 - Max Maisel Licensed under CERN-OHL-S v2 or any later version
