mmmaisel/Keyboard/hw/LedMatrix-Navblock.kicad_sch

## KiCad design hw/LedMatrix-Navblock.kicad_sch (2026-01-05)

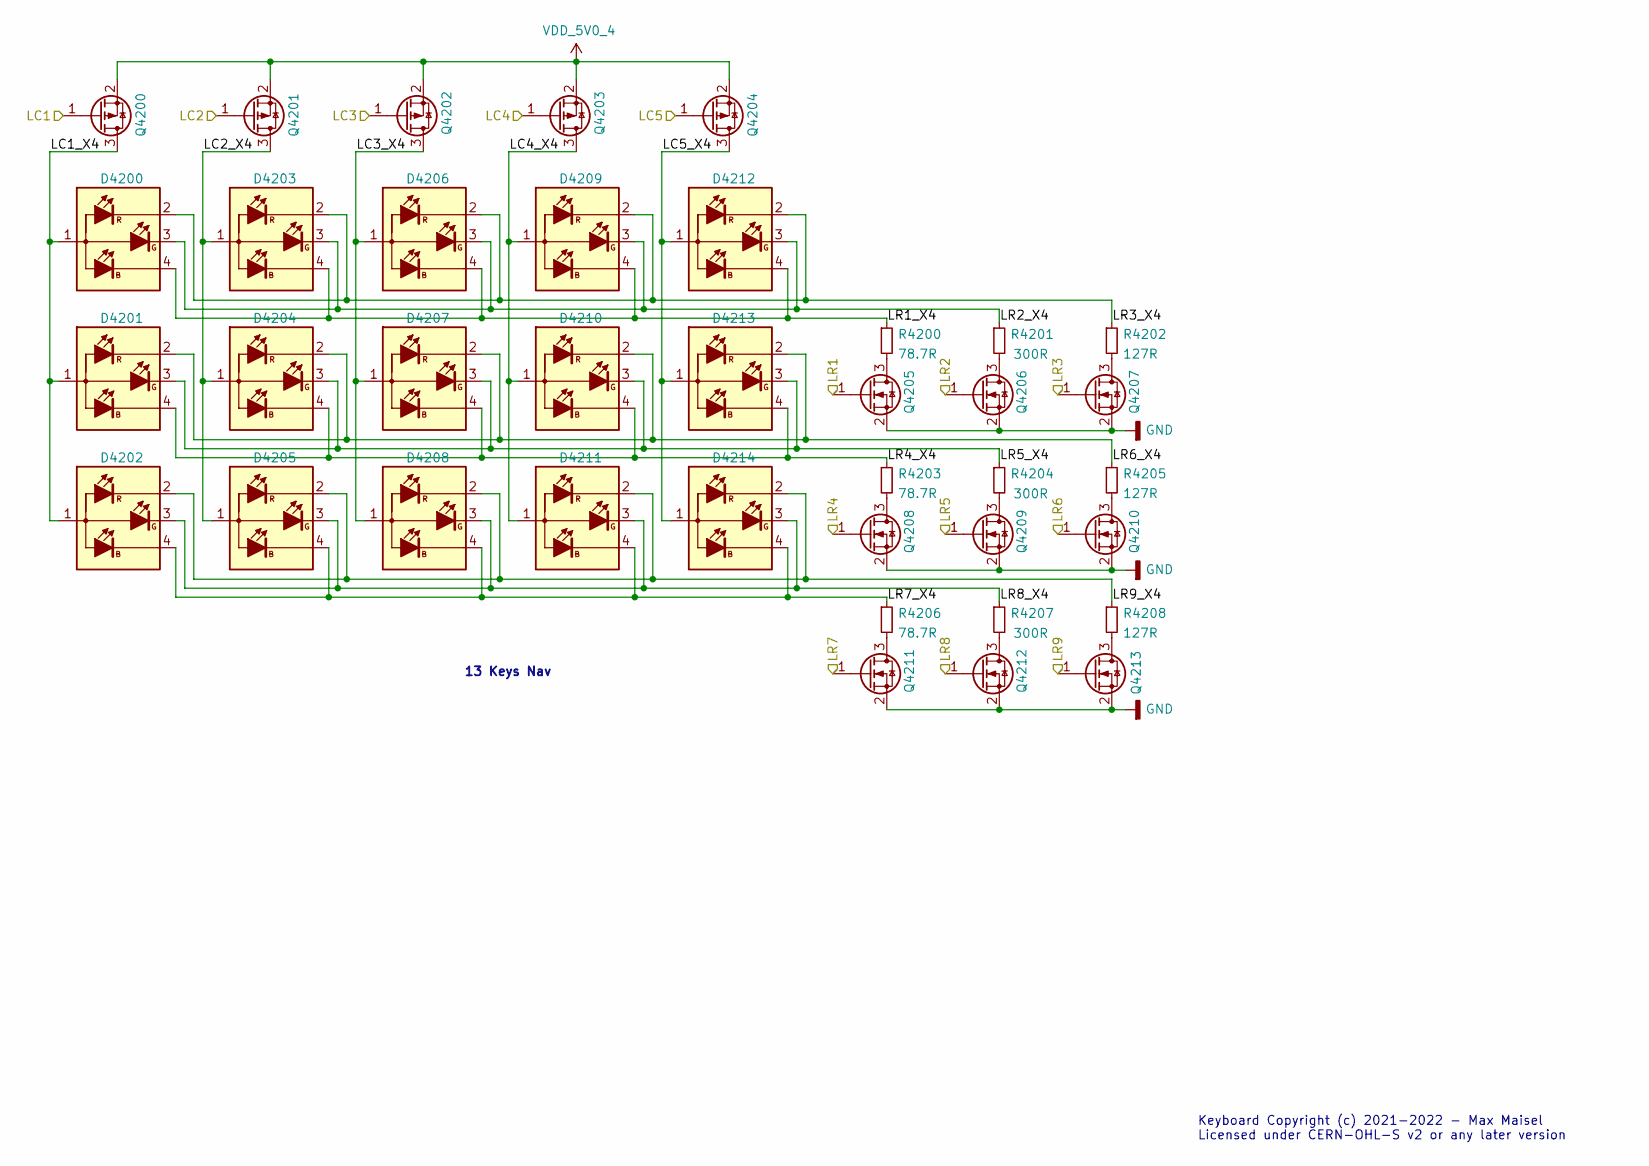
[picture p16: schematic LedMatrix-Navblock.kicad_sch]

Parts:
D4200, D4201, D4202, D4203, D4204, D4205, D4206, D4207, D4208, D4209, D4210, D4211, D4212, D4213, D4214: APTF1616LSEEZGKQBKC; APTF1616-RGB; mouser# 604-APTF1616LSEEZGKQ
Q4200, Q4201, Q4202, Q4203, Q4204: NTA4151P; SC-75; mouser# 863-NTA4151PT1G; digikey# DTA114EET1GOSCT-ND
Q4205, Q4206, Q4207, Q4208, Q4209, Q4210, Q4211, Q4212, Q4213: NTA4153N; SC-75; mouser# 863-NTA4153NT1G
R4200, R4203, R4206: 78.7R; R_0402; mouser# 603-RC0402FR-0778R7L
R4201, R4204, R4207: 300R; R_0402; mouser# 667-ERJ-2RKF3000X
R4202, R4205, R4208: 127R; R_0402; mouser# 603-RC0402FR-07127RL

Connections:
GND: Q4205.2 (S), Q4206.2 (S), Q4207.2 (S), Q4208.2 (S), Q4209.2 (S), Q4210.2 (S), Q4211.2 (S), Q4212.2 (S), Q4213.2 (S)
LC1: Q4200.1 (G)
LC1_X4: D4200.1 (A), D4201.1 (A), D4202.1 (A), Q4200.3 (D)
LC2: Q4201.1 (G)
LC2_X4: D4203.1 (A), D4204.1 (A), D4205.1 (A), Q4201.3 (D)
LC3: Q4202.1 (G)
LC3_X4: D4206.1 (A), D4207.1 (A), D4208.1 (A), Q4202.3 (D)
LC4: Q4203.1 (G)
LC4_X4: D4209.1 (A), D4210.1 (A), D4211.1 (A), Q4203.3 (D)
LC5: Q4204.1 (G)
LC5_X4: D4212.1 (A), D4213.1 (A), D4214.1 (A), Q4204.3 (D)
LR1: Q4205.1 (G)
LR1_X4: D4200.4 (KB), D4203.4 (KB), D4206.4 (KB), D4209.4 (KB), D4212.4 (KB), R4200.1
LR2: Q4206.1 (G)
LR2_X4: D4200.3 (KG), D4203.3 (KG), D4206.3 (KG), D4209.3 (KG), D4212.3 (KG), R4201.1
LR3: Q4207.1 (G)
LR3_X4: D4200.2 (KR), D4203.2 (KR), D4206.2 (KR), D4209.2 (KR), D4212.2 (KR), R4202.1
LR4: Q4208.1 (G)
LR4_X4: D4201.4 (KB), D4204.4 (KB), D4207.4 (KB), D4210.4 (KB), D4213.4 (KB), R4203.1
LR5: Q4209.1 (G)
LR5_X4: D4201.3 (KG), D4204.3 (KG), D4207.3 (KG), D4210.3 (KG), D4213.3 (KG), R4204.1
LR6: Q4210.1 (G)
LR6_X4: D4201.2 (KR), D4204.2 (KR), D4207.2 (KR), D4210.2 (KR), D4213.2 (KR), R4205.1
LR7: Q4211.1 (G)
LR7_X4: D4202.4 (KB), D4205.4 (KB), D4208.4 (KB), D4211.4 (KB), D4214.4 (KB), R4206.1
LR8: Q4212.1 (G)
LR8_X4: D4202.3 (KG), D4205.3 (KG), D4208.3 (KG), D4211.3 (KG), D4214.3 (KG), R4207.1
LR9: Q4213.1 (G)
LR9_X4: D4202.2 (KR), D4205.2 (KR), D4208.2 (KR), D4211.2 (KR), D4214.2 (KR), R4208.1
unnamed: Q4205.3 (D), R4200.2
unnamed: Q4206.3 (D), R4201.2
unnamed: Q4207.3 (D), R4202.2
unnamed: Q4208.3 (D), R4203.2
unnamed: Q4209.3 (D), R4204.2
unnamed: Q4210.3 (D), R4205.2
unnamed: Q4211.3 (D), R4206.2
unnamed: Q4212.3 (D), R4207.2
unnamed: Q4213.3 (D), R4208.2
VDD_5V0_4: Q4200.2 (S), Q4201.2 (S), Q4202.2 (S), Q4203.2 (S), Q4204.2 (S)

Notes on the sheet:
13 Keys Nav
Keyboard Copyright (c) 2021-2022 - Max Maisel Licensed under CERN-OHL-S v2 or any later version
