mmmaisel/Keyboard/hw/LedMatrix-Numblock.kicad_sch

## KiCad design hw/LedMatrix-Numblock.kicad_sch (2026-01-05)

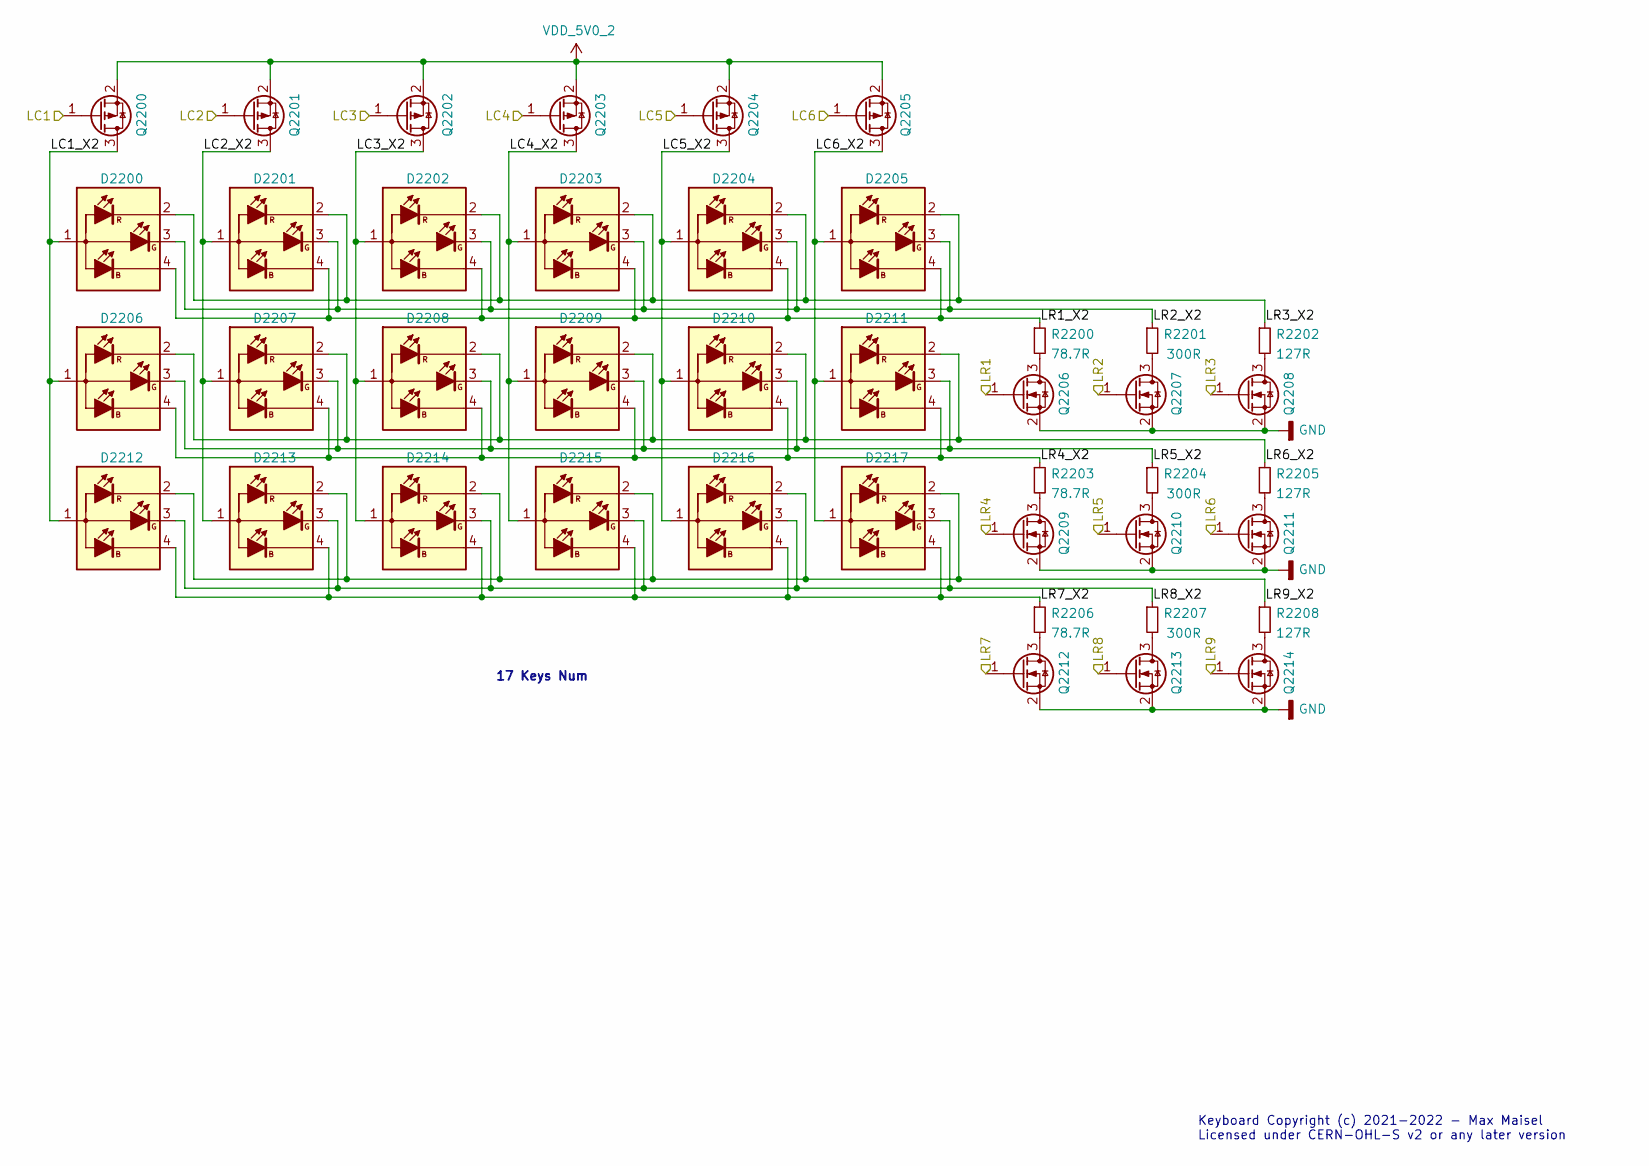
[picture p17: schematic LedMatrix-Numblock.kicad_sch]

Parts:
D2200, D2201, D2202, D2203, D2204, D2205, D2206, D2207, D2208, D2209, D2210, D2211, D2212, D2213, D2214, D2215, D2216, D2217: APTF1616LSEEZGKQBKC; APTF1616-RGB; mouser# 604-APTF1616LSEEZGKQ
Q2200, Q2201, Q2202, Q2203, Q2204, Q2205: NTA4151P; SC-75; mouser# 863-NTA4151PT1G; digikey# DTA114EET1GOSCT-ND
Q2206, Q2207, Q2208, Q2209, Q2210, Q2211, Q2212, Q2213, Q2214: NTA4153N; SC-75; mouser# 863-NTA4153NT1G
R2200, R2203, R2206: 78.7R; R_0402; mouser# 603-RC0402FR-0778R7L
R2201, R2204, R2207: 300R; R_0402; mouser# 667-ERJ-2RKF3000X
R2202, R2205, R2208: 127R; R_0402; mouser# 603-RC0402FR-07127RL

Connections:
GND: Q2206.2 (S), Q2207.2 (S), Q2208.2 (S), Q2209.2 (S), Q2210.2 (S), Q2211.2 (S), Q2212.2 (S), Q2213.2 (S), Q2214.2 (S)
LC1: Q2200.1 (G)
LC1_X2: D2200.1 (A), D2206.1 (A), D2212.1 (A), Q2200.3 (D)
LC2: Q2201.1 (G)
LC2_X2: D2201.1 (A), D2207.1 (A), D2213.1 (A), Q2201.3 (D)
LC3: Q2202.1 (G)
LC3_X2: D2202.1 (A), D2208.1 (A), D2214.1 (A), Q2202.3 (D)
LC4: Q2203.1 (G)
LC4_X2: D2203.1 (A), D2209.1 (A), D2215.1 (A), Q2203.3 (D)
LC5: Q2204.1 (G)
LC5_X2: D2204.1 (A), D2210.1 (A), D2216.1 (A), Q2204.3 (D)
LC6: Q2205.1 (G)
LC6_X2: D2205.1 (A), D2211.1 (A), D2217.1 (A), Q2205.3 (D)
LR1: Q2206.1 (G)
LR1_X2: D2200.4 (KB), D2201.4 (KB), D2202.4 (KB), D2203.4 (KB), D2204.4 (KB), D2205.4 (KB), R2200.1
LR2: Q2207.1 (G)
LR2_X2: D2200.3 (KG), D2201.3 (KG), D2202.3 (KG), D2203.3 (KG), D2204.3 (KG), D2205.3 (KG), R2201.1
LR3: Q2208.1 (G)
LR3_X2: D2200.2 (KR), D2201.2 (KR), D2202.2 (KR), D2203.2 (KR), D2204.2 (KR), D2205.2 (KR), R2202.1
LR4: Q2209.1 (G)
LR4_X2: D2206.4 (KB), D2207.4 (KB), D2208.4 (KB), D2209.4 (KB), D2210.4 (KB), D2211.4 (KB), R2203.1
LR5: Q2210.1 (G)
LR5_X2: D2206.3 (KG), D2207.3 (KG), D2208.3 (KG), D2209.3 (KG), D2210.3 (KG), D2211.3 (KG), R2204.1
LR6: Q2211.1 (G)
LR6_X2: D2206.2 (KR), D2207.2 (KR), D2208.2 (KR), D2209.2 (KR), D2210.2 (KR), D2211.2 (KR), R2205.1
LR7: Q2212.1 (G)
LR7_X2: D2212.4 (KB), D2213.4 (KB), D2214.4 (KB), D2215.4 (KB), D2216.4 (KB), D2217.4 (KB), R2206.1
LR8: Q2213.1 (G)
LR8_X2: D2212.3 (KG), D2213.3 (KG), D2214.3 (KG), D2215.3 (KG), D2216.3 (KG), D2217.3 (KG), R2207.1
LR9: Q2214.1 (G)
LR9_X2: D2212.2 (KR), D2213.2 (KR), D2214.2 (KR), D2215.2 (KR), D2216.2 (KR), D2217.2 (KR), R2208.1
unnamed: Q2206.3 (D), R2200.2
unnamed: Q2207.3 (D), R2201.2
unnamed: Q2208.3 (D), R2202.2
unnamed: Q2209.3 (D), R2203.2
unnamed: Q2210.3 (D), R2204.2
unnamed: Q2211.3 (D), R2205.2
unnamed: Q2212.3 (D), R2206.2
unnamed: Q2213.3 (D), R2207.2
unnamed: Q2214.3 (D), R2208.2
VDD_5V0_2: Q2200.2 (S), Q2201.2 (S), Q2202.2 (S), Q2203.2 (S), Q2204.2 (S), Q2205.2 (S)

Notes on the sheet:
17 Keys Num
Keyboard Copyright (c) 2021-2022 - Max Maisel Licensed under CERN-OHL-S v2 or any later version
