mmmaisel/Keyboard/hw/LedMatrix-Right.kicad_sch

## KiCad design hw/LedMatrix-Right.kicad_sch (2026-01-05)

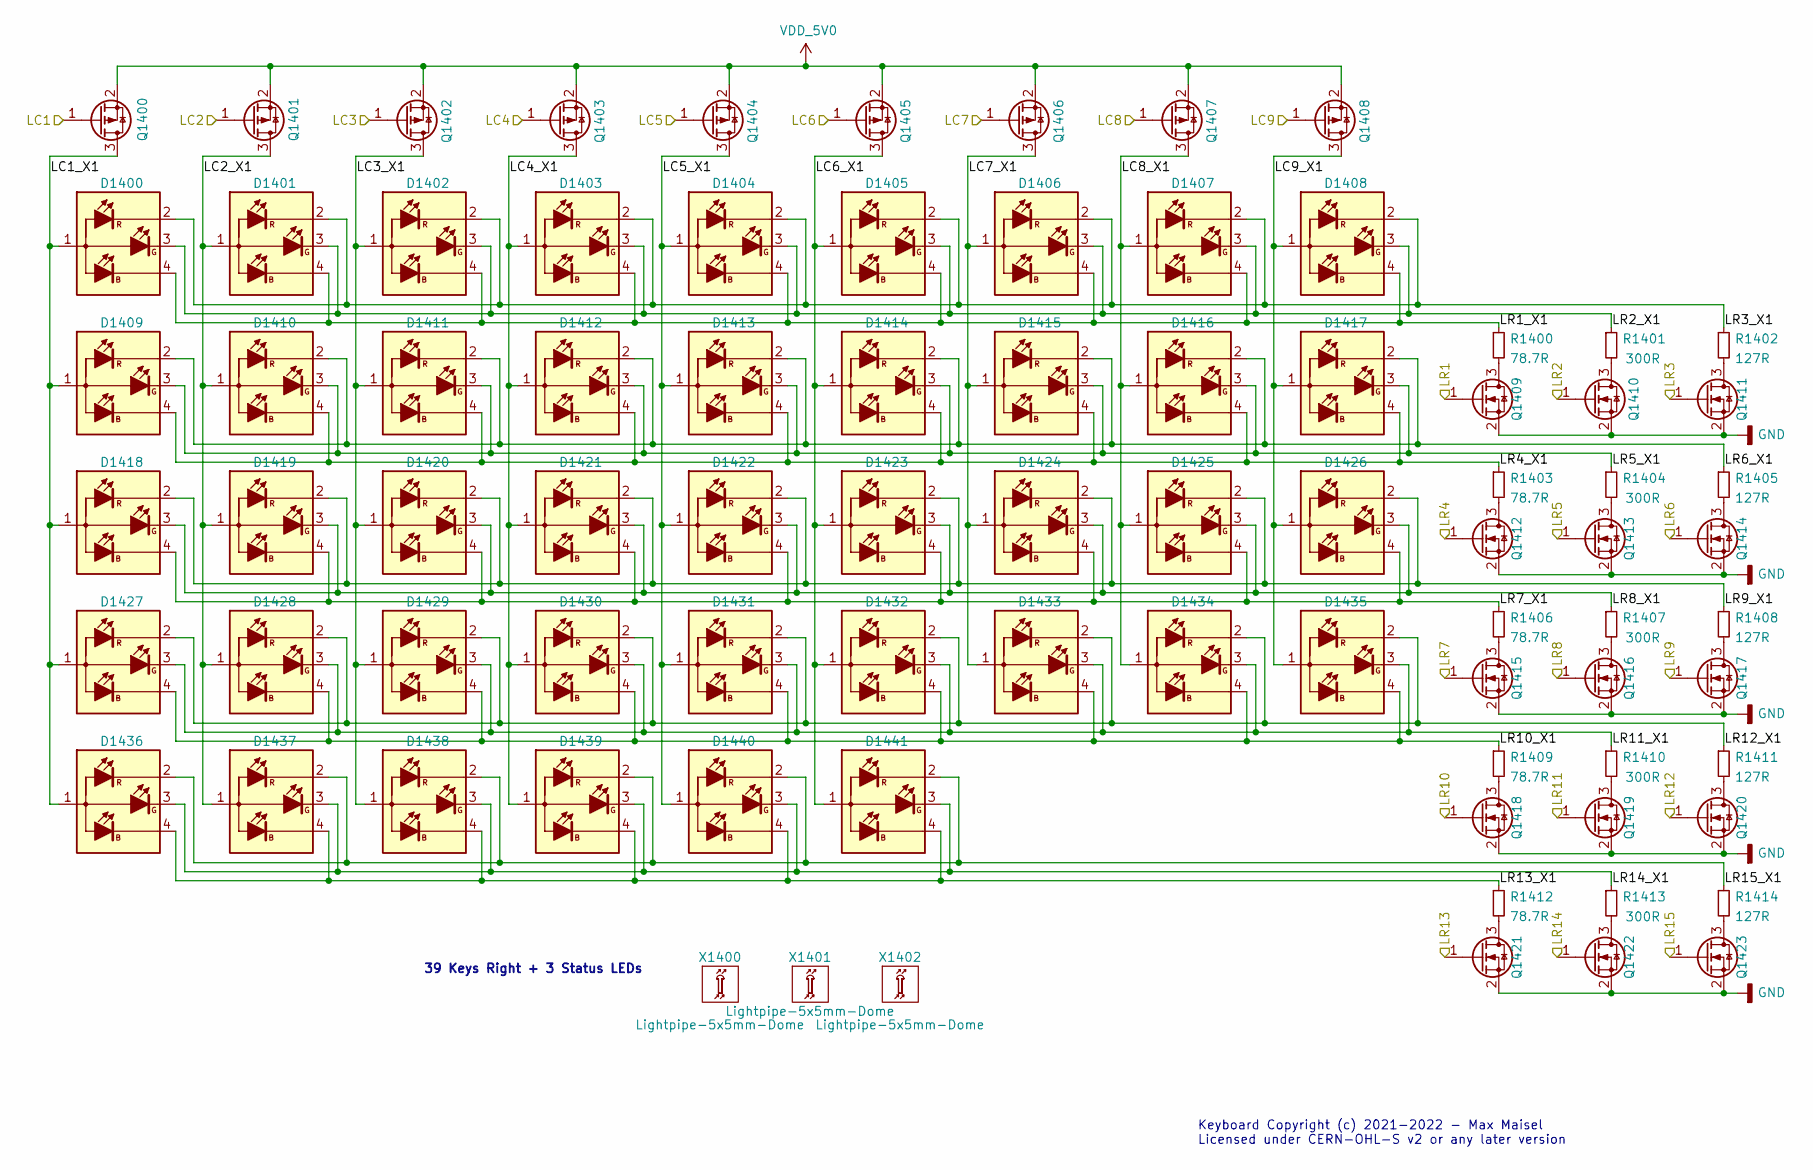
[picture p18: schematic LedMatrix-Right.kicad_sch]

Parts:
D1400, D1401, D1402, D1403, D1404, D1405, D1406, D1407, D1408, D1409, D1410, D1411, D1412, D1413, D1414, D1415, D1416, D1417, D1418, D1419, D1420, D1421, D1422, D1423, D1424, D1425, D1426, D1427, D1428, D1429, D1430, D1431, D1432, D1433, D1434, D1435, D1436, D1437, D1438, D1439, D1440, D1441: APTF1616LSEEZGKQBKC; APTF1616-RGB; mouser# 604-APTF1616LSEEZGKQ
Q1400, Q1401, Q1402, Q1403, Q1404, Q1405, Q1406, Q1407, Q1408: NTA4151P; SC-75; mouser# 863-NTA4151PT1G; digikey# DTA114EET1GOSCT-ND
Q1409, Q1410, Q1411, Q1412, Q1413, Q1414, Q1415, Q1416, Q1417, Q1418, Q1419, Q1420, Q1421, Q1422, Q1423: NTA4153N; SC-75; mouser# 863-NTA4153NT1G
R1400, R1403, R1406, R1409, R1412: 78.7R; R_0402; mouser# 603-RC0402FR-0778R7L
R1401, R1404, R1407, R1410, R1413: 300R; R_0402; mouser# 667-ERJ-2RKF3000X
R1402, R1405, R1408, R1411, R1414: 127R; R_0402; mouser# 603-RC0402FR-07127RL
X1400, X1401, X1402: Lightpipe-5x5mm-Dome; Lightpipe-51513530188F; mouser# 645-51513530188F

Connections:
GND: Q1409.2 (S), Q1410.2 (S), Q1411.2 (S), Q1412.2 (S), Q1413.2 (S), Q1414.2 (S), Q1415.2 (S), Q1416.2 (S), Q1417.2 (S), Q1418.2 (S), Q1419.2 (S), Q1420.2 (S), Q1421.2 (S), Q1422.2 (S), Q1423.2 (S)
LC1: Q1400.1 (G)
LC1_X1: D1400.1 (A), D1409.1 (A), D1418.1 (A), D1427.1 (A), D1436.1 (A), Q1400.3 (D)
LC2: Q1401.1 (G)
LC2_X1: D1401.1 (A), D1410.1 (A), D1419.1 (A), D1428.1 (A), D1437.1 (A), Q1401.3 (D)
LC3: Q1402.1 (G)
LC3_X1: D1402.1 (A), D1411.1 (A), D1420.1 (A), D1429.1 (A), D1438.1 (A), Q1402.3 (D)
LC4: Q1403.1 (G)
LC4_X1: D1403.1 (A), D1412.1 (A), D1421.1 (A), D1430.1 (A), D1439.1 (A), Q1403.3 (D)
LC5: Q1404.1 (G)
LC5_X1: D1404.1 (A), D1413.1 (A), D1422.1 (A), D1431.1 (A), D1440.1 (A), Q1404.3 (D)
LC6: Q1405.1 (G)
LC6_X1: D1405.1 (A), D1414.1 (A), D1423.1 (A), D1432.1 (A), D1441.1 (A), Q1405.3 (D)
LC7: Q1406.1 (G)
LC7_X1: D1406.1 (A), D1415.1 (A), D1424.1 (A), D1433.1 (A), Q1406.3 (D)
LC8: Q1407.1 (G)
LC8_X1: D1407.1 (A), D1416.1 (A), D1425.1 (A), D1434.1 (A), Q1407.3 (D)
LC9: Q1408.1 (G)
LC9_X1: D1408.1 (A), D1417.1 (A), D1426.1 (A), D1435.1 (A), Q1408.3 (D)
LR1: Q1409.1 (G)
LR1_X1: D1400.4 (KB), D1401.4 (KB), D1402.4 (KB), D1403.4 (KB), D1404.4 (KB), D1405.4 (KB), D1406.4 (KB), D1407.4 (KB), D1408.4 (KB), R1400.1
LR2: Q1410.1 (G)
LR2_X1: D1400.3 (KG), D1401.3 (KG), D1402.3 (KG), D1403.3 (KG), D1404.3 (KG), D1405.3 (KG), D1406.3 (KG), D1407.3 (KG), D1408.3 (KG), R1401.1
LR3: Q1411.1 (G)
LR3_X1: D1400.2 (KR), D1401.2 (KR), D1402.2 (KR), D1403.2 (KR), D1404.2 (KR), D1405.2 (KR), D1406.2 (KR), D1407.2 (KR), D1408.2 (KR), R1402.1
LR4: Q1412.1 (G)
LR4_X1: D1409.4 (KB), D1410.4 (KB), D1411.4 (KB), D1412.4 (KB), D1413.4 (KB), D1414.4 (KB), D1415.4 (KB), D1416.4 (KB), D1417.4 (KB), R1403.1
LR5: Q1413.1 (G)
LR5_X1: D1409.3 (KG), D1410.3 (KG), D1411.3 (KG), D1412.3 (KG), D1413.3 (KG), D1414.3 (KG), D1415.3 (KG), D1416.3 (KG), D1417.3 (KG), R1404.1
LR6: Q1414.1 (G)
LR6_X1: D1409.2 (KR), D1410.2 (KR), D1411.2 (KR), D1412.2 (KR), D1413.2 (KR), D1414.2 (KR), D1415.2 (KR), D1416.2 (KR), D1417.2 (KR), R1405.1
LR7: Q1415.1 (G)
LR7_X1: D1418.4 (KB), D1419.4 (KB), D1420.4 (KB), D1421.4 (KB), D1422.4 (KB), D1423.4 (KB), D1424.4 (KB), D1425.4 (KB), D1426.4 (KB), R1406.1
LR8: Q1416.1 (G)
LR8_X1: D1418.3 (KG), D1419.3 (KG), D1420.3 (KG), D1421.3 (KG), D1422.3 (KG), D1423.3 (KG), D1424.3 (KG), D1425.3 (KG), D1426.3 (KG), R1407.1
LR9: Q1417.1 (G)
LR9_X1: D1418.2 (KR), D1419.2 (KR), D1420.2 (KR), D1421.2 (KR), D1422.2 (KR), D1423.2 (KR), D1424.2 (KR), D1425.2 (KR), D1426.2 (KR), R1408.1
LR10: Q1418.1 (G)
LR10_X1: D1427.4 (KB), D1428.4 (KB), D1429.4 (KB), D1430.4 (KB), D1431.4 (KB), D1432.4 (KB), D1433.4 (KB), D1434.4 (KB), D1435.4 (KB), R1409.1
LR11: Q1419.1 (G)
LR11_X1: D1427.3 (KG), D1428.3 (KG), D1429.3 (KG), D1430.3 (KG), D1431.3 (KG), D1432.3 (KG), D1433.3 (KG), D1434.3 (KG), D1435.3 (KG), R1410.1
LR12: Q1420.1 (G)
LR12_X1: D1427.2 (KR), D1428.2 (KR), D1429.2 (KR), D1430.2 (KR), D1431.2 (KR), D1432.2 (KR), D1433.2 (KR), D1434.2 (KR), D1435.2 (KR), R1411.1
LR13: Q1421.1 (G)
LR13_X1: D1436.4 (KB), D1437.4 (KB), D1438.4 (KB), D1439.4 (KB), D1440.4 (KB), D1441.4 (KB), R1412.1
LR14: Q1422.1 (G)
LR14_X1: D1436.3 (KG), D1437.3 (KG), D1438.3 (KG), D1439.3 (KG), D1440.3 (KG), D1441.3 (KG), R1413.1
LR15: Q1423.1 (G)
LR15_X1: D1436.2 (KR), D1437.2 (KR), D1438.2 (KR), D1439.2 (KR), D1440.2 (KR), D1441.2 (KR), R1414.1
unnamed: Q1409.3 (D), R1400.2
unnamed: Q1410.3 (D), R1401.2
unnamed: Q1411.3 (D), R1402.2
unnamed: Q1412.3 (D), R1403.2
unnamed: Q1413.3 (D), R1404.2
unnamed: Q1414.3 (D), R1405.2
unnamed: Q1415.3 (D), R1406.2
unnamed: Q1416.3 (D), R1407.2
unnamed: Q1417.3 (D), R1408.2
unnamed: Q1418.3 (D), R1409.2
unnamed: Q1419.3 (D), R1410.2
unnamed: Q1420.3 (D), R1411.2
unnamed: Q1421.3 (D), R1412.2
unnamed: Q1422.3 (D), R1413.2
unnamed: Q1423.3 (D), R1414.2
VDD_5V0: Q1400.2 (S), Q1401.2 (S), Q1402.2 (S), Q1403.2 (S), Q1404.2 (S), Q1405.2 (S), Q1406.2 (S), Q1407.2 (S), Q1408.2 (S)

Notes on the sheet:
39 Keys Right + 3 Status LEDs
Keyboard Copyright (c) 2021-2022 - Max Maisel Licensed under CERN-OHL-S v2 or any later version
