mmmaisel/Keyboard/hw/LevelShifters-Left.kicad_sch

## KiCad design hw/LevelShifters-Left.kicad_sch (2026-01-05)

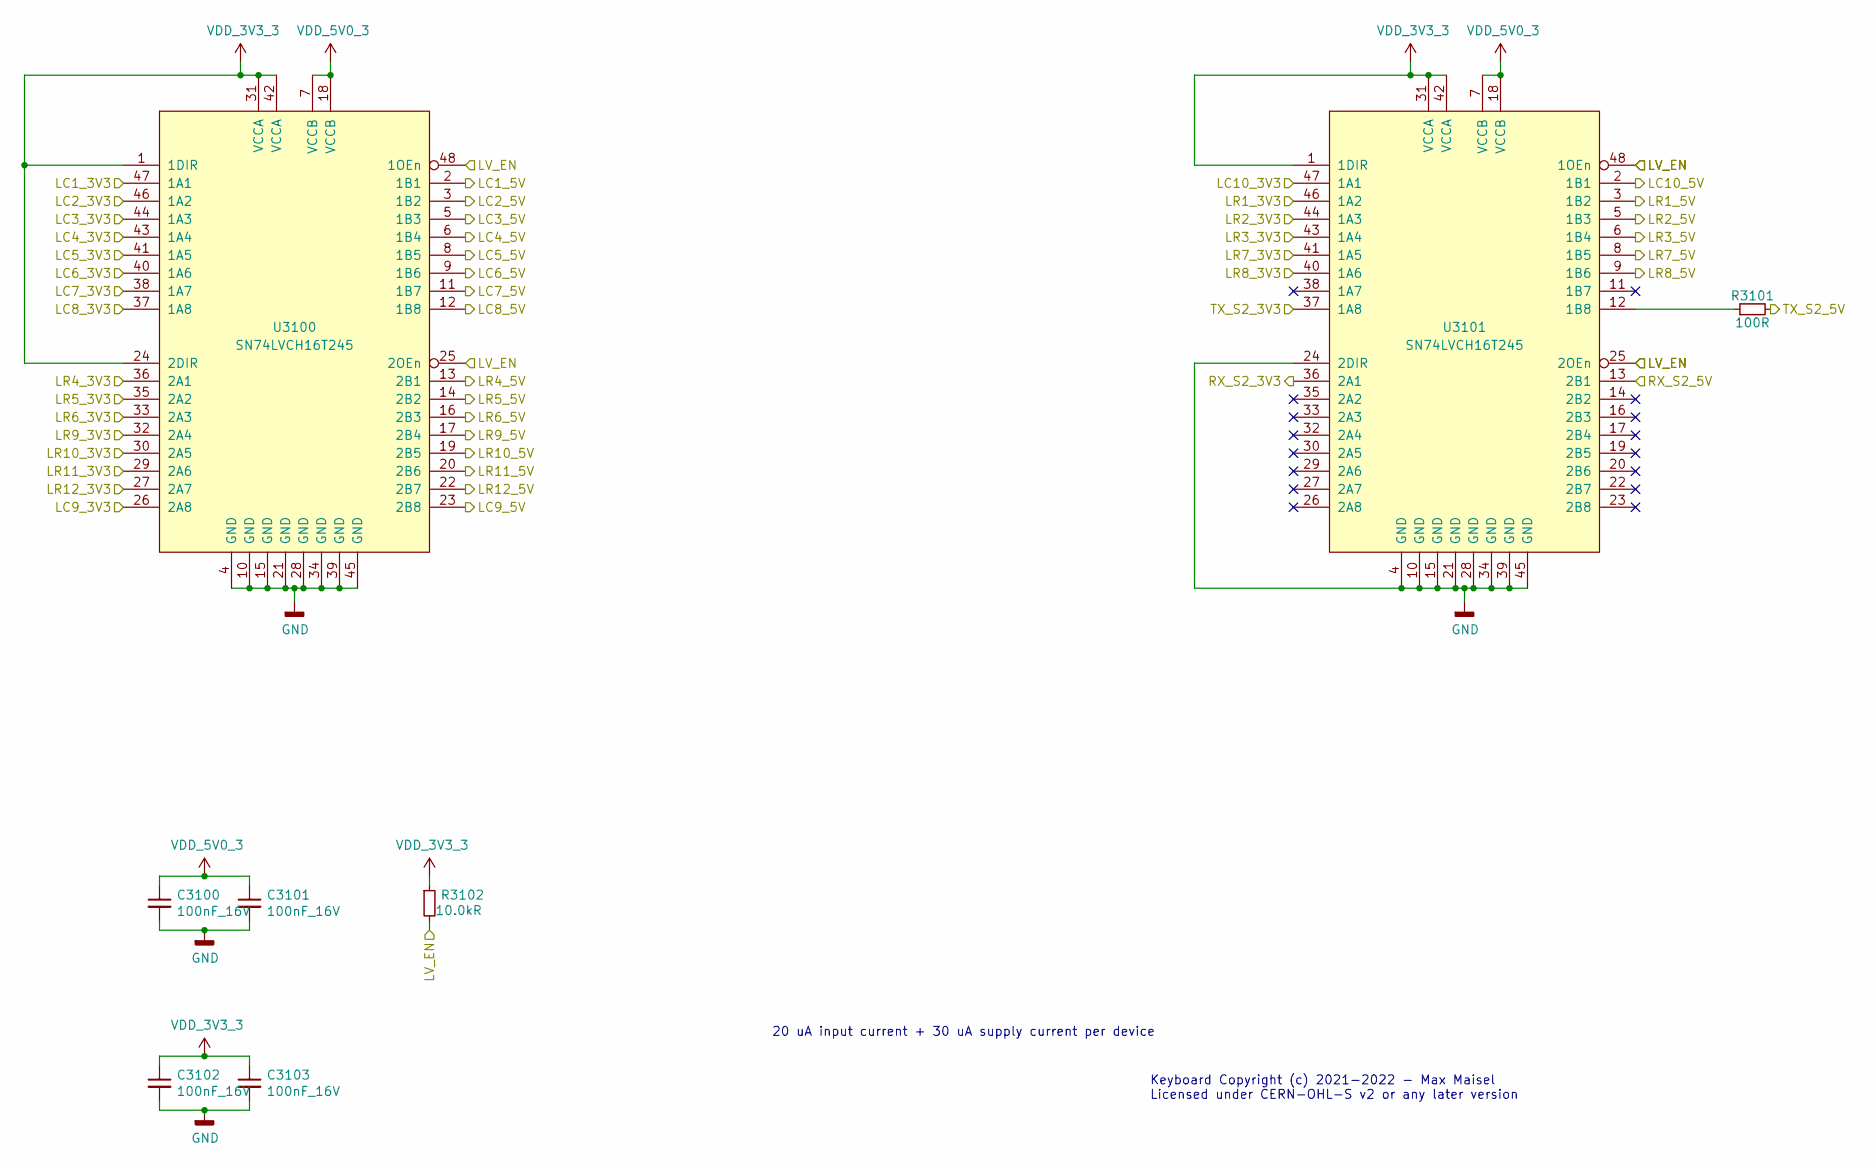
[picture p19: schematic LevelShifters-Left.kicad_sch]

Parts:
C3100, C3101, C3102, C3103: 100nF_16V; C_0402; mouser# 80-C0402C104K4R
R3101: 100R; R_0402; mouser# 667-ERJ-2RKF1000X
R3102: 10.0kR; R_0402; mouser# 667-ERJ-2RKF1002X
U3100, U3101: SN74LVCH16T245; TSSOP48-DGG

Connections:
GND: C3100.2, C3101.2, C3102.2, C3103.2, U3100.4 (GND), U3100.10 (GND), U3100.15 (GND), U3100.21 (GND), U3100.28 (GND), U3100.34 (GND), U3100.39 (GND), U3100.45 (GND), U3101.4 (GND), U3101.10 (GND), U3101.15 (GND), U3101.21 (GND), U3101.24 (2DIR), U3101.28 (GND), U3101.34 (GND), U3101.39 (GND), U3101.45 (GND)
LC1_3V3: U3100.47 (1A1)
LC1_5V: U3100.2 (1B1)
LC2_3V3: U3100.46 (1A2)
LC2_5V: U3100.3 (1B2)
LC3_3V3: U3100.44 (1A3)
LC3_5V: U3100.5 (1B3)
LC4_3V3: U3100.43 (1A4)
LC4_5V: U3100.6 (1B4)
LC5_3V3: U3100.41 (1A5)
LC5_5V: U3100.8 (1B5)
LC6_3V3: U3100.40 (1A6)
LC6_5V: U3100.9 (1B6)
LC7_3V3: U3100.38 (1A7)
LC7_5V: U3100.11 (1B7)
LC8_3V3: U3100.37 (1A8)
LC8_5V: U3100.12 (1B8)
LC9_3V3: U3100.26 (2A8)
LC9_5V: U3100.23 (2B8)
LC10_3V3: U3101.47 (1A1)
LC10_5V: U3101.2 (1B1)
LR1_3V3: U3101.46 (1A2)
LR1_5V: U3101.3 (1B2)
LR2_3V3: U3101.44 (1A3)
LR2_5V: U3101.5 (1B3)
LR3_3V3: U3101.43 (1A4)
LR3_5V: U3101.6 (1B4)
LR4_3V3: U3100.36 (2A1)
LR4_5V: U3100.13 (2B1)
LR5_3V3: U3100.35 (2A2)
LR5_5V: U3100.14 (2B2)
LR6_3V3: U3100.33 (2A3)
LR6_5V: U3100.16 (2B3)
LR7_3V3: U3101.41 (1A5)
LR7_5V: U3101.8 (1B5)
LR8_3V3: U3101.40 (1A6)
LR8_5V: U3101.9 (1B6)
LR9_3V3: U3100.32 (2A4)
LR9_5V: U3100.17 (2B4)
LR10_3V3: U3100.30 (2A5)
LR10_5V: U3100.19 (2B5)
LR11_3V3: U3100.29 (2A6)
LR11_5V: U3100.20 (2B6)
LR12_3V3: U3100.27 (2A7)
LR12_5V: U3100.22 (2B7)
LV_EN: R3102.2, U3100.25 (2OEn), U3100.48 (1OEn), U3101.25 (2OEn), U3101.48 (1OEn)
unnamed: R3101.1, U3101.12 (1B8)
RX_S2_3V3: U3101.36 (2A1)
RX_S2_5V: U3101.13 (2B1)
TX_S2_3V3: U3101.37 (1A8)
TX_S2_5V: R3101.2
VDD_3V3_3: C3102.1, C3103.1, R3102.1, U3100.1 (1DIR), U3100.24 (2DIR), U3100.31 (VCCA), U3100.42 (VCCA), U3101.1 (1DIR), U3101.31 (VCCA), U3101.42 (VCCA)
VDD_5V0_3: C3100.1, C3101.1, U3100.7 (VCCB), U3100.18 (VCCB), U3101.7 (VCCB), U3101.18 (VCCB)

Notes on the sheet:
Keyboard Copyright (c) 2021-2022 - Max Maisel Licensed under CERN-OHL-S v2 or any later version
20 uA input current + 30 uA supply current per device
