mmmaisel/Keyboard/hw/LevelShifters-Navblock.kicad_sch

## KiCad design hw/LevelShifters-Navblock.kicad_sch (2026-01-05)

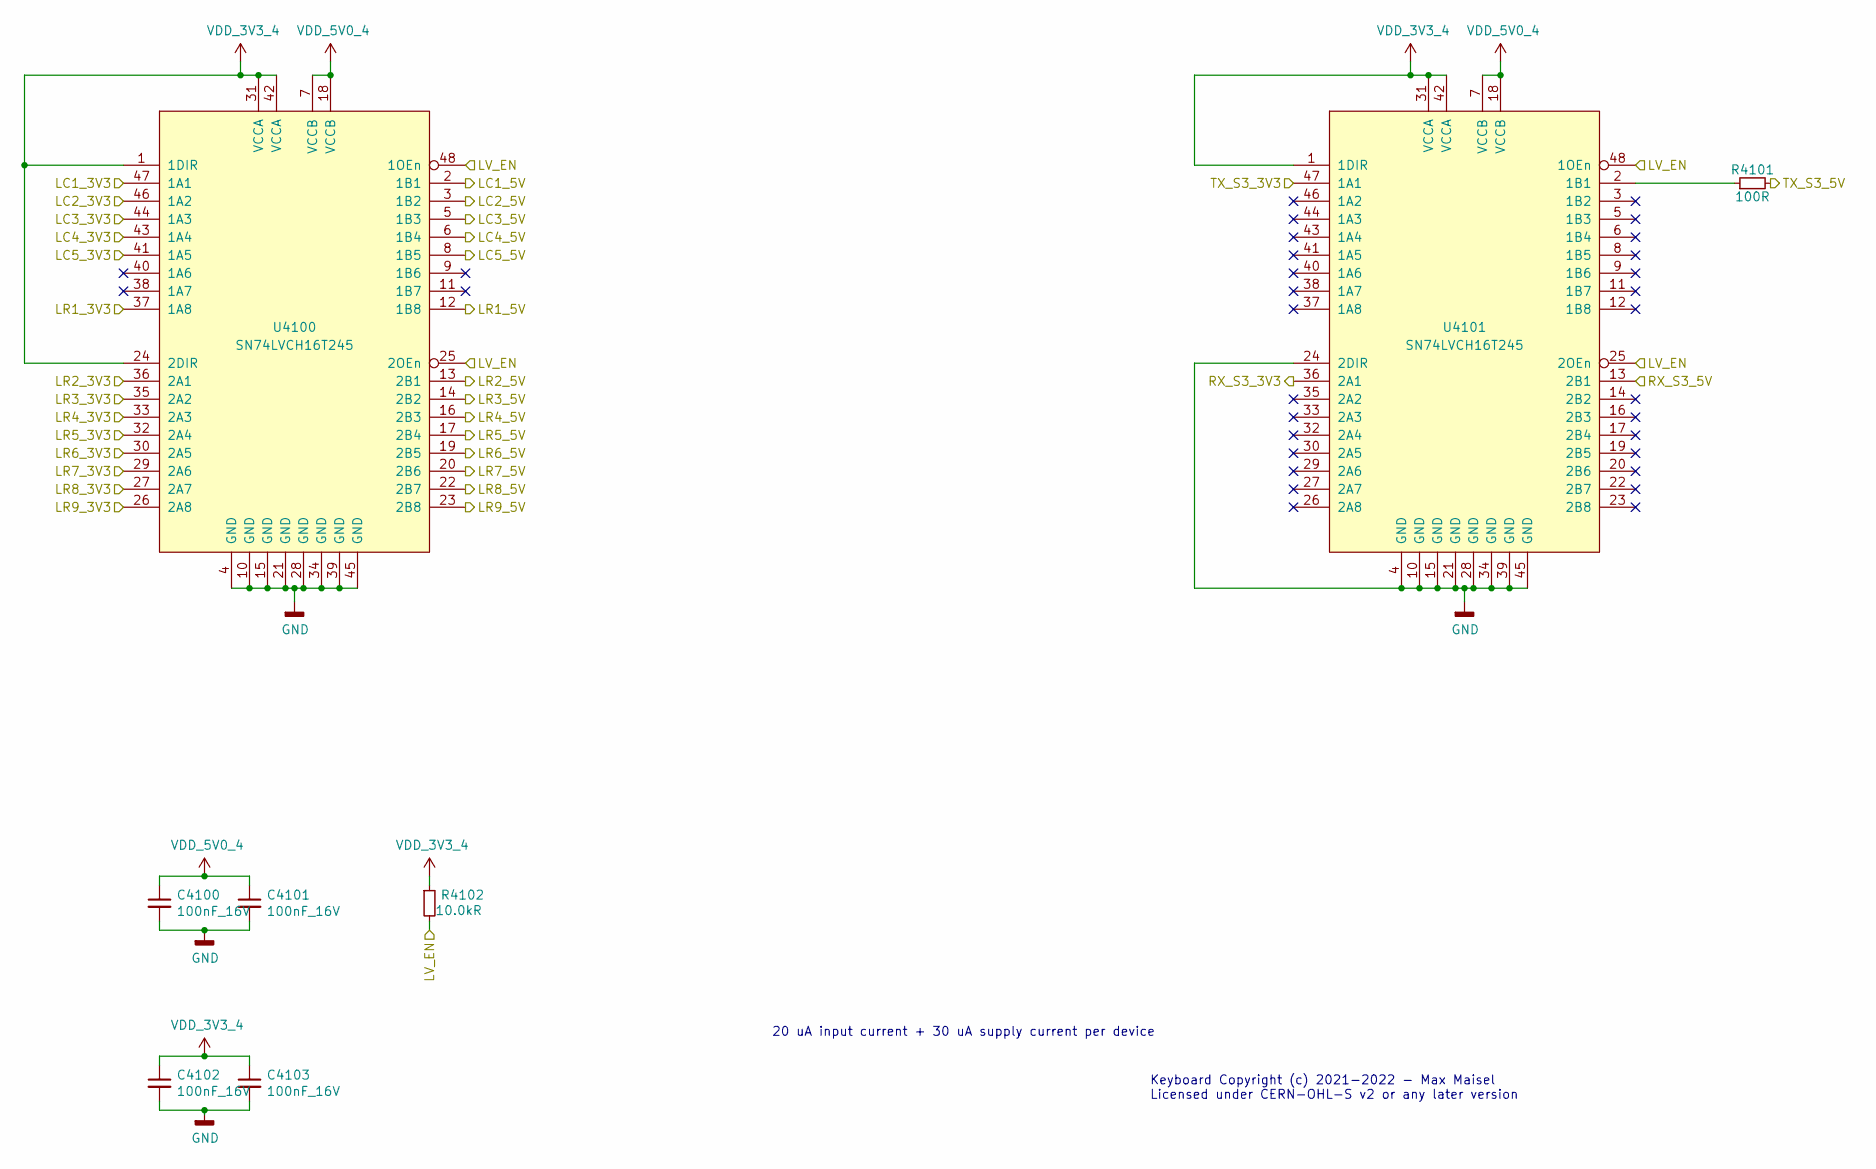
[picture p20: schematic LevelShifters-Navblock.kicad_sch]

Parts:
C4100, C4101, C4102, C4103: 100nF_16V; C_0402; mouser# 80-C0402C104K4R
R4101: 100R; R_0402; mouser# 667-ERJ-2RKF1000X
R4102: 10.0kR; R_0402; mouser# 667-ERJ-2RKF1002X
U4100, U4101: SN74LVCH16T245; TSSOP48-DGG

Connections:
GND: C4100.2, C4101.2, C4102.2, C4103.2, U4100.4 (GND), U4100.10 (GND), U4100.15 (GND), U4100.21 (GND), U4100.28 (GND), U4100.34 (GND), U4100.39 (GND), U4100.45 (GND), U4101.4 (GND), U4101.10 (GND), U4101.15 (GND), U4101.21 (GND), U4101.24 (2DIR), U4101.28 (GND), U4101.34 (GND), U4101.39 (GND), U4101.45 (GND)
LC1_3V3: U4100.47 (1A1)
LC1_5V: U4100.2 (1B1)
LC2_3V3: U4100.46 (1A2)
LC2_5V: U4100.3 (1B2)
LC3_3V3: U4100.44 (1A3)
LC3_5V: U4100.5 (1B3)
LC4_3V3: U4100.43 (1A4)
LC4_5V: U4100.6 (1B4)
LC5_3V3: U4100.41 (1A5)
LC5_5V: U4100.8 (1B5)
LR1_3V3: U4100.37 (1A8)
LR1_5V: U4100.12 (1B8)
LR2_3V3: U4100.36 (2A1)
LR2_5V: U4100.13 (2B1)
LR3_3V3: U4100.35 (2A2)
LR3_5V: U4100.14 (2B2)
LR4_3V3: U4100.33 (2A3)
LR4_5V: U4100.16 (2B3)
LR5_3V3: U4100.32 (2A4)
LR5_5V: U4100.17 (2B4)
LR6_3V3: U4100.30 (2A5)
LR6_5V: U4100.19 (2B5)
LR7_3V3: U4100.29 (2A6)
LR7_5V: U4100.20 (2B6)
LR8_3V3: U4100.27 (2A7)
LR8_5V: U4100.22 (2B7)
LR9_3V3: U4100.26 (2A8)
LR9_5V: U4100.23 (2B8)
LV_EN: R4102.2, U4100.25 (2OEn), U4100.48 (1OEn), U4101.25 (2OEn), U4101.48 (1OEn)
unnamed: R4101.1, U4101.2 (1B1)
RX_S3_3V3: U4101.36 (2A1)
RX_S3_5V: U4101.13 (2B1)
TX_S3_3V3: U4101.47 (1A1)
TX_S3_5V: R4101.2
VDD_3V3_4: C4102.1, C4103.1, R4102.1, U4100.1 (1DIR), U4100.24 (2DIR), U4100.31 (VCCA), U4100.42 (VCCA), U4101.1 (1DIR), U4101.31 (VCCA), U4101.42 (VCCA)
VDD_5V0_4: C4100.1, C4101.1, U4100.7 (VCCB), U4100.18 (VCCB), U4101.7 (VCCB), U4101.18 (VCCB)

Notes on the sheet:
Keyboard Copyright (c) 2021-2022 - Max Maisel Licensed under CERN-OHL-S v2 or any later version
20 uA input current + 30 uA supply current per device
