mmmaisel/Keyboard/hw/LevelShifters-Numblock.kicad_sch

## KiCad design hw/LevelShifters-Numblock.kicad_sch (2026-01-05)

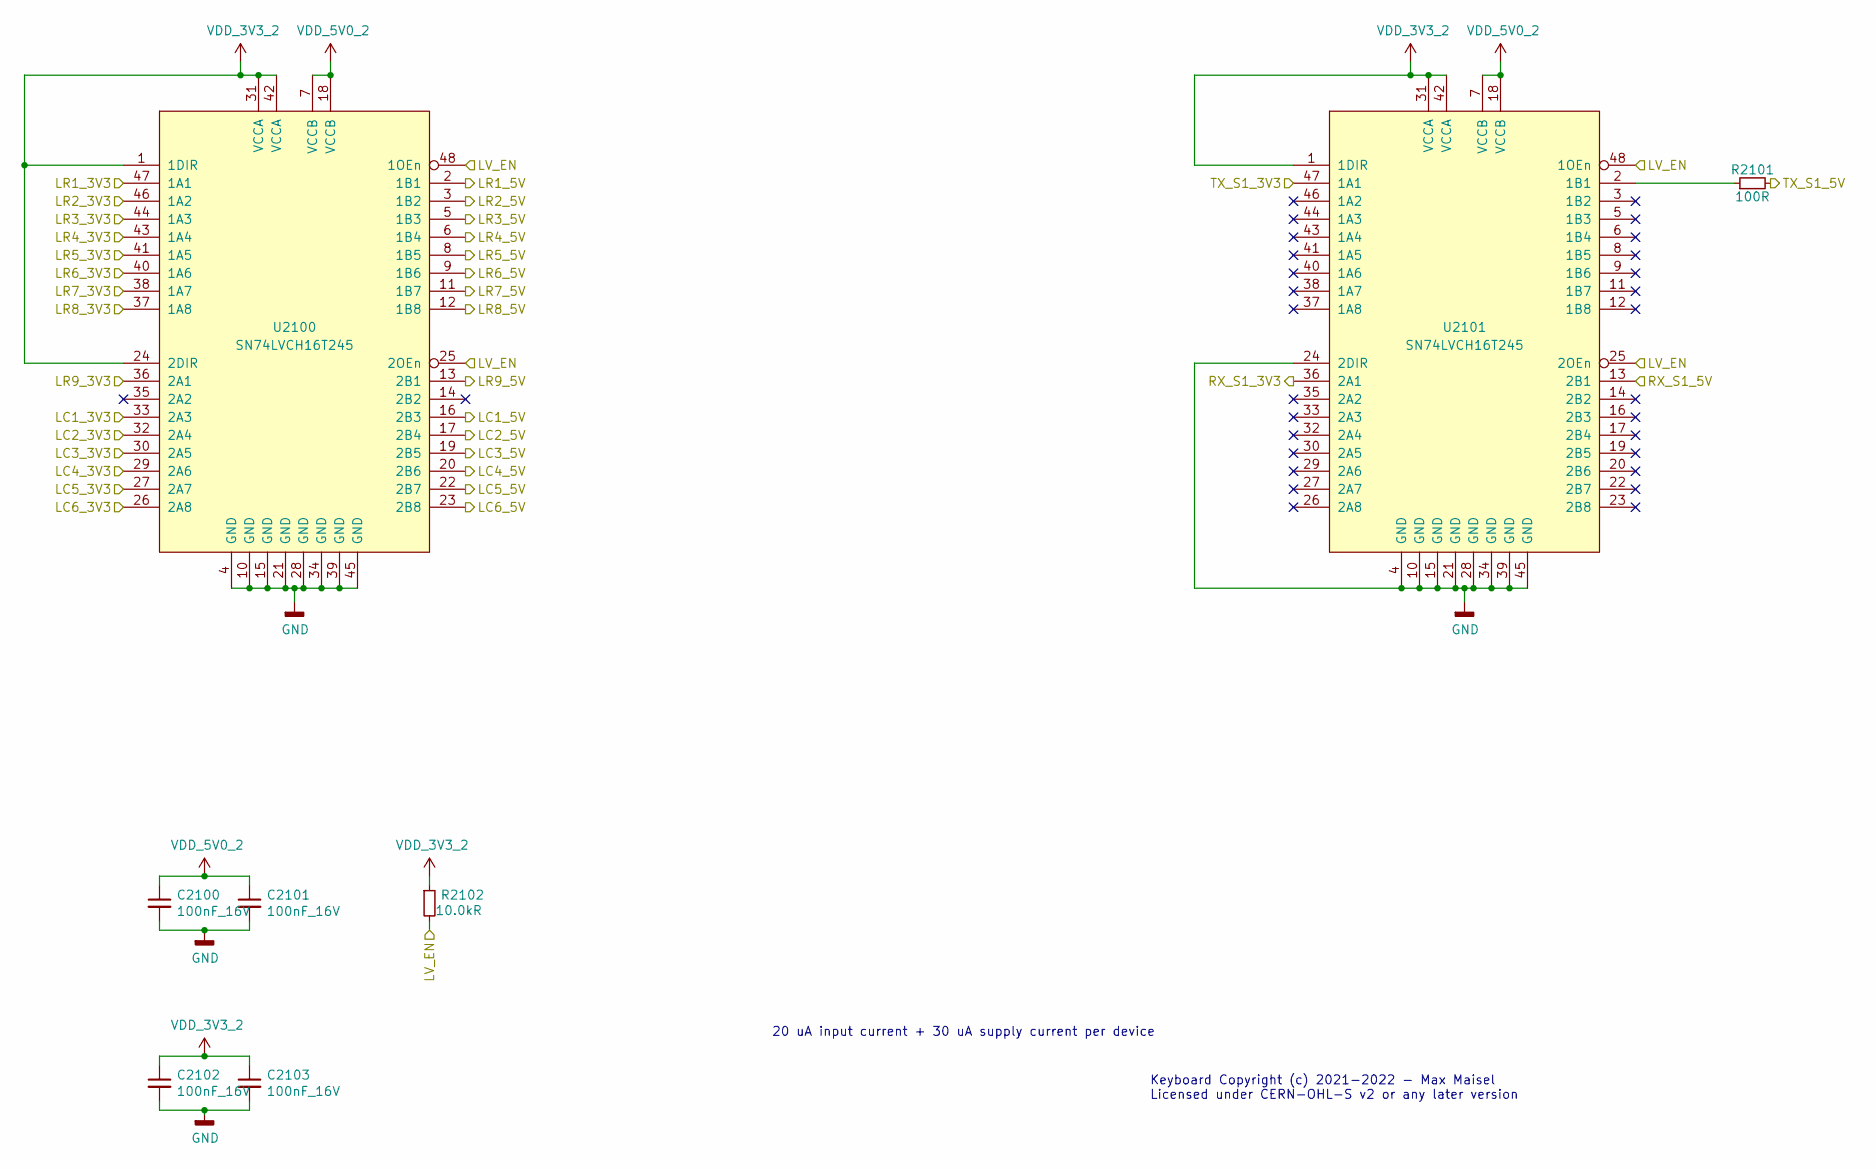
[picture p21: schematic LevelShifters-Numblock.kicad_sch]

Parts:
C2100, C2101, C2102, C2103: 100nF_16V; C_0402; mouser# 80-C0402C104K4R
R2101: 100R; R_0402; mouser# 667-ERJ-2RKF1000X
R2102: 10.0kR; R_0402; mouser# 667-ERJ-2RKF1002X
U2100, U2101: SN74LVCH16T245; TSSOP48-DGG

Connections:
GND: C2100.2, C2101.2, C2102.2, C2103.2, U2100.4 (GND), U2100.10 (GND), U2100.15 (GND), U2100.21 (GND), U2100.28 (GND), U2100.34 (GND), U2100.39 (GND), U2100.45 (GND), U2101.4 (GND), U2101.10 (GND), U2101.15 (GND), U2101.21 (GND), U2101.24 (2DIR), U2101.28 (GND), U2101.34 (GND), U2101.39 (GND), U2101.45 (GND)
LC1_3V3: U2100.33 (2A3)
LC1_5V: U2100.16 (2B3)
LC2_3V3: U2100.32 (2A4)
LC2_5V: U2100.17 (2B4)
LC3_3V3: U2100.30 (2A5)
LC3_5V: U2100.19 (2B5)
LC4_3V3: U2100.29 (2A6)
LC4_5V: U2100.20 (2B6)
LC5_3V3: U2100.27 (2A7)
LC5_5V: U2100.22 (2B7)
LC6_3V3: U2100.26 (2A8)
LC6_5V: U2100.23 (2B8)
LR1_3V3: U2100.47 (1A1)
LR1_5V: U2100.2 (1B1)
LR2_3V3: U2100.46 (1A2)
LR2_5V: U2100.3 (1B2)
LR3_3V3: U2100.44 (1A3)
LR3_5V: U2100.5 (1B3)
LR4_3V3: U2100.43 (1A4)
LR4_5V: U2100.6 (1B4)
LR5_3V3: U2100.41 (1A5)
LR5_5V: U2100.8 (1B5)
LR6_3V3: U2100.40 (1A6)
LR6_5V: U2100.9 (1B6)
LR7_3V3: U2100.38 (1A7)
LR7_5V: U2100.11 (1B7)
LR8_3V3: U2100.37 (1A8)
LR8_5V: U2100.12 (1B8)
LR9_3V3: U2100.36 (2A1)
LR9_5V: U2100.13 (2B1)
LV_EN: R2102.2, U2100.25 (2OEn), U2100.48 (1OEn), U2101.25 (2OEn), U2101.48 (1OEn)
unnamed: R2101.1, U2101.2 (1B1)
RX_S1_3V3: U2101.36 (2A1)
RX_S1_5V: U2101.13 (2B1)
TX_S1_3V3: U2101.47 (1A1)
TX_S1_5V: R2101.2
VDD_3V3_2: C2102.1, C2103.1, R2102.1, U2100.1 (1DIR), U2100.24 (2DIR), U2100.31 (VCCA), U2100.42 (VCCA), U2101.1 (1DIR), U2101.31 (VCCA), U2101.42 (VCCA)
VDD_5V0_2: C2100.1, C2101.1, U2100.7 (VCCB), U2100.18 (VCCB), U2101.7 (VCCB), U2101.18 (VCCB)

Notes on the sheet:
20 uA input current + 30 uA supply current per device
Keyboard Copyright (c) 2021-2022 - Max Maisel Licensed under CERN-OHL-S v2 or any later version
