mmmaisel/Keyboard/hw/LevelShifters-Right.kicad_sch

## KiCad design hw/LevelShifters-Right.kicad_sch (2026-01-05)

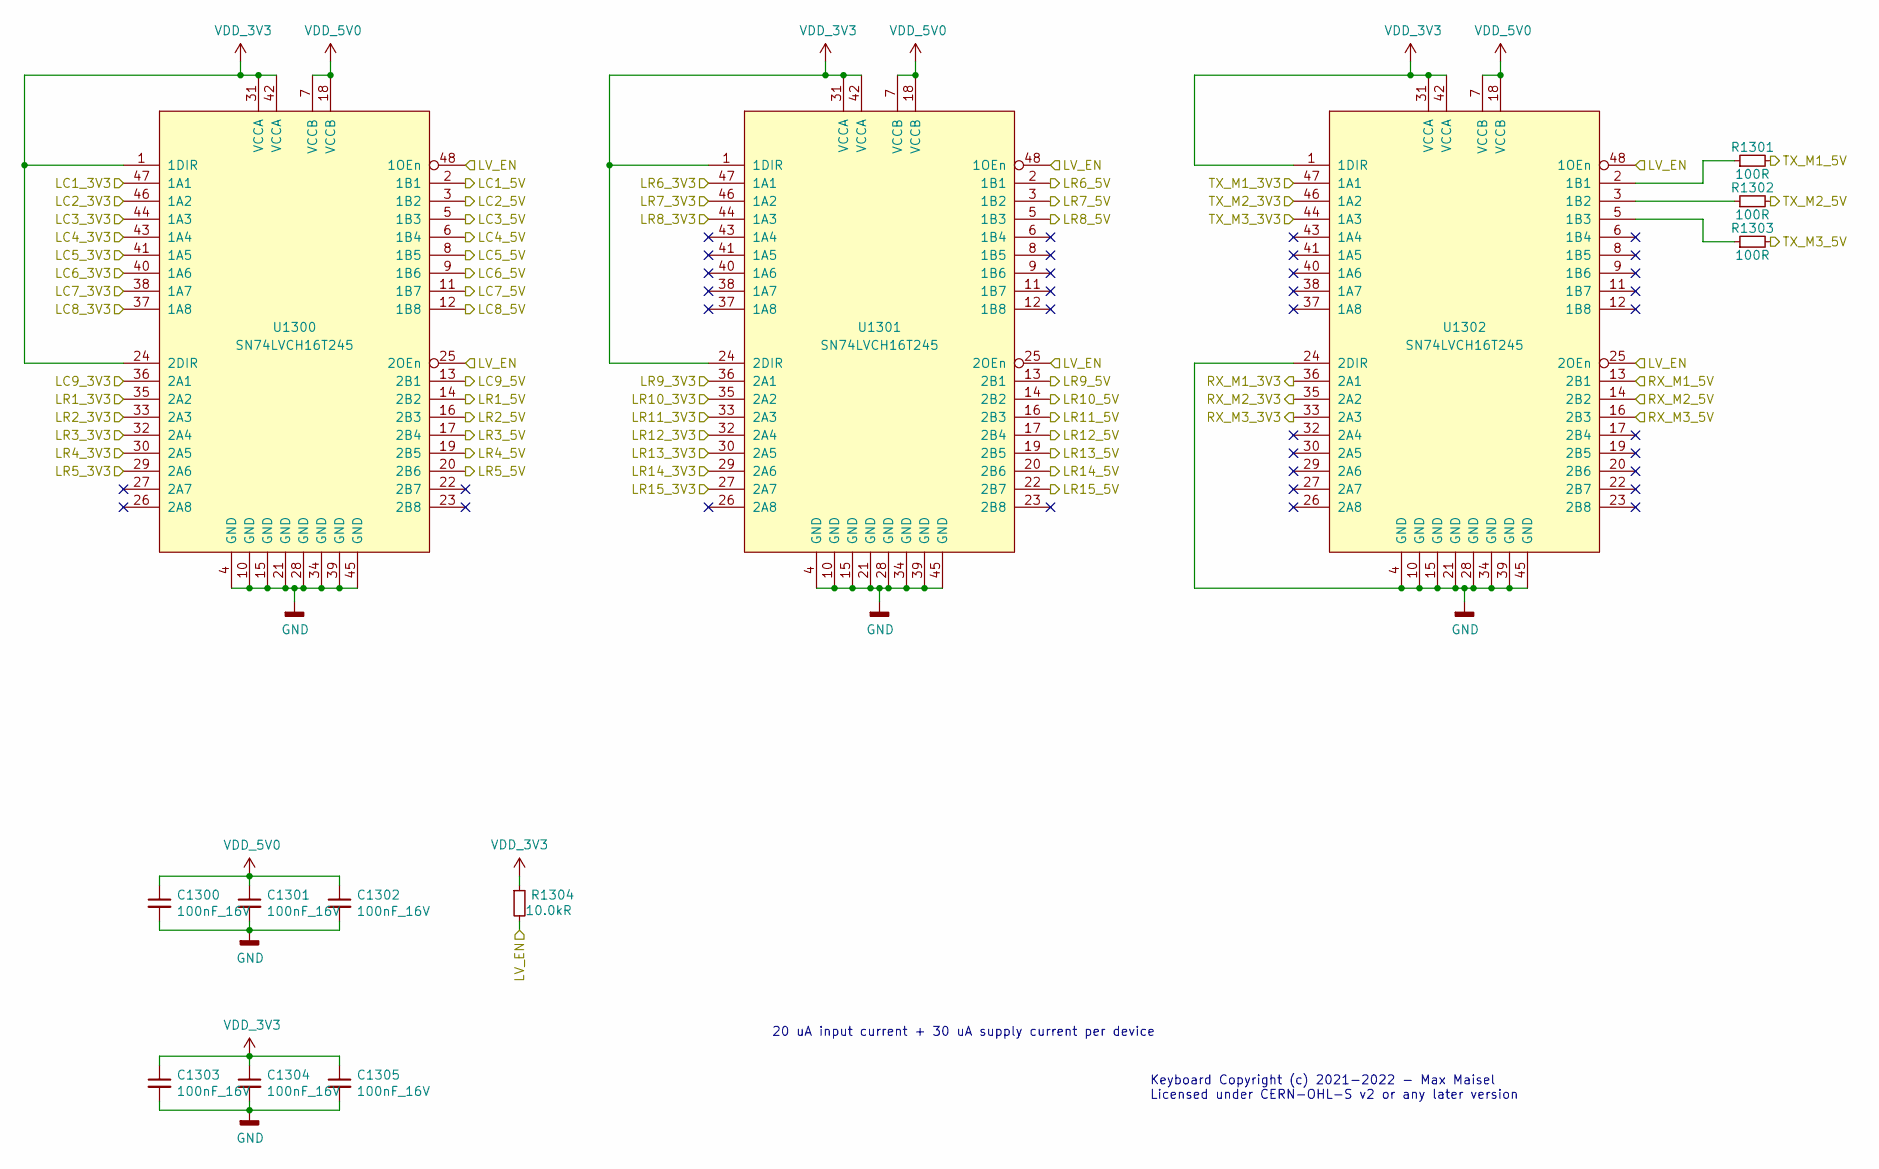
[picture p22: schematic LevelShifters-Right.kicad_sch]

Parts:
C1300, C1301, C1302, C1303, C1304, C1305: 100nF_16V; C_0402; mouser# 80-C0402C104K4R
R1301, R1302, R1303: 100R; R_0402; mouser# 667-ERJ-2RKF1000X
R1304: 10.0kR; R_0402; mouser# 667-ERJ-2RKF1002X
U1300, U1301, U1302: SN74LVCH16T245; TSSOP48-DGG

Connections:
GND: C1300.2, C1301.2, C1302.2, C1303.2, C1304.2, C1305.2, U1300.4 (GND), U1300.10 (GND), U1300.15 (GND), U1300.21 (GND), U1300.28 (GND), U1300.34 (GND), U1300.39 (GND), U1300.45 (GND), U1301.4 (GND), U1301.10 (GND), U1301.15 (GND), U1301.21 (GND), U1301.28 (GND), U1301.34 (GND), U1301.39 (GND), U1301.45 (GND), U1302.4 (GND), U1302.10 (GND), U1302.15 (GND), U1302.21 (GND), U1302.24 (2DIR), U1302.28 (GND), U1302.34 (GND), U1302.39 (GND), U1302.45 (GND)
LC1_3V3: U1300.47 (1A1)
LC1_5V: U1300.2 (1B1)
LC2_3V3: U1300.46 (1A2)
LC2_5V: U1300.3 (1B2)
LC3_3V3: U1300.44 (1A3)
LC3_5V: U1300.5 (1B3)
LC4_3V3: U1300.43 (1A4)
LC4_5V: U1300.6 (1B4)
LC5_3V3: U1300.41 (1A5)
LC5_5V: U1300.8 (1B5)
LC6_3V3: U1300.40 (1A6)
LC6_5V: U1300.9 (1B6)
LC7_3V3: U1300.38 (1A7)
LC7_5V: U1300.11 (1B7)
LC8_3V3: U1300.37 (1A8)
LC8_5V: U1300.12 (1B8)
LC9_3V3: U1300.36 (2A1)
LC9_5V: U1300.13 (2B1)
LR1_3V3: U1300.35 (2A2)
LR1_5V: U1300.14 (2B2)
LR2_3V3: U1300.33 (2A3)
LR2_5V: U1300.16 (2B3)
LR3_3V3: U1300.32 (2A4)
LR3_5V: U1300.17 (2B4)
LR4_3V3: U1300.30 (2A5)
LR4_5V: U1300.19 (2B5)
LR5_3V3: U1300.29 (2A6)
LR5_5V: U1300.20 (2B6)
LR6_3V3: U1301.47 (1A1)
LR6_5V: U1301.2 (1B1)
LR7_3V3: U1301.46 (1A2)
LR7_5V: U1301.3 (1B2)
LR8_3V3: U1301.44 (1A3)
LR8_5V: U1301.5 (1B3)
LR9_3V3: U1301.36 (2A1)
LR9_5V: U1301.13 (2B1)
LR10_3V3: U1301.35 (2A2)
LR10_5V: U1301.14 (2B2)
LR11_3V3: U1301.33 (2A3)
LR11_5V: U1301.16 (2B3)
LR12_3V3: U1301.32 (2A4)
LR12_5V: U1301.17 (2B4)
LR13_3V3: U1301.30 (2A5)
LR13_5V: U1301.19 (2B5)
LR14_3V3: U1301.29 (2A6)
LR14_5V: U1301.20 (2B6)
LR15_3V3: U1301.27 (2A7)
LR15_5V: U1301.22 (2B7)
LV_EN: R1304.2, U1300.25 (2OEn), U1300.48 (1OEn), U1301.25 (2OEn), U1301.48 (1OEn), U1302.25 (2OEn), U1302.48 (1OEn)
unnamed: R1301.1, U1302.2 (1B1)
unnamed: R1302.1, U1302.3 (1B2)
unnamed: R1303.1, U1302.5 (1B3)
RX_M1_3V3: U1302.36 (2A1)
RX_M1_5V: U1302.13 (2B1)
RX_M2_3V3: U1302.35 (2A2)
RX_M2_5V: U1302.14 (2B2)
RX_M3_3V3: U1302.33 (2A3)
RX_M3_5V: U1302.16 (2B3)
TX_M1_3V3: U1302.47 (1A1)
TX_M1_5V: R1301.2
TX_M2_3V3: U1302.46 (1A2)
TX_M2_5V: R1302.2
TX_M3_3V3: U1302.44 (1A3)
TX_M3_5V: R1303.2
VDD_3V3: C1303.1, C1304.1, C1305.1, R1304.1, U1300.1 (1DIR), U1300.24 (2DIR), U1300.31 (VCCA), U1300.42 (VCCA), U1301.1 (1DIR), U1301.24 (2DIR), U1301.31 (VCCA), U1301.42 (VCCA), U1302.1 (1DIR), U1302.31 (VCCA), U1302.42 (VCCA)
VDD_5V0: C1300.1, C1301.1, C1302.1, U1300.7 (VCCB), U1300.18 (VCCB), U1301.7 (VCCB), U1301.18 (VCCB), U1302.7 (VCCB), U1302.18 (VCCB)

Notes on the sheet:
20 uA input current + 30 uA supply current per device
Keyboard Copyright (c) 2021-2022 - Max Maisel Licensed under CERN-OHL-S v2 or any later version
