mmmaisel/Keyboard/hw/PowerSupply.kicad_sch

## KiCad design hw/PowerSupply.kicad_sch (2026-01-05)

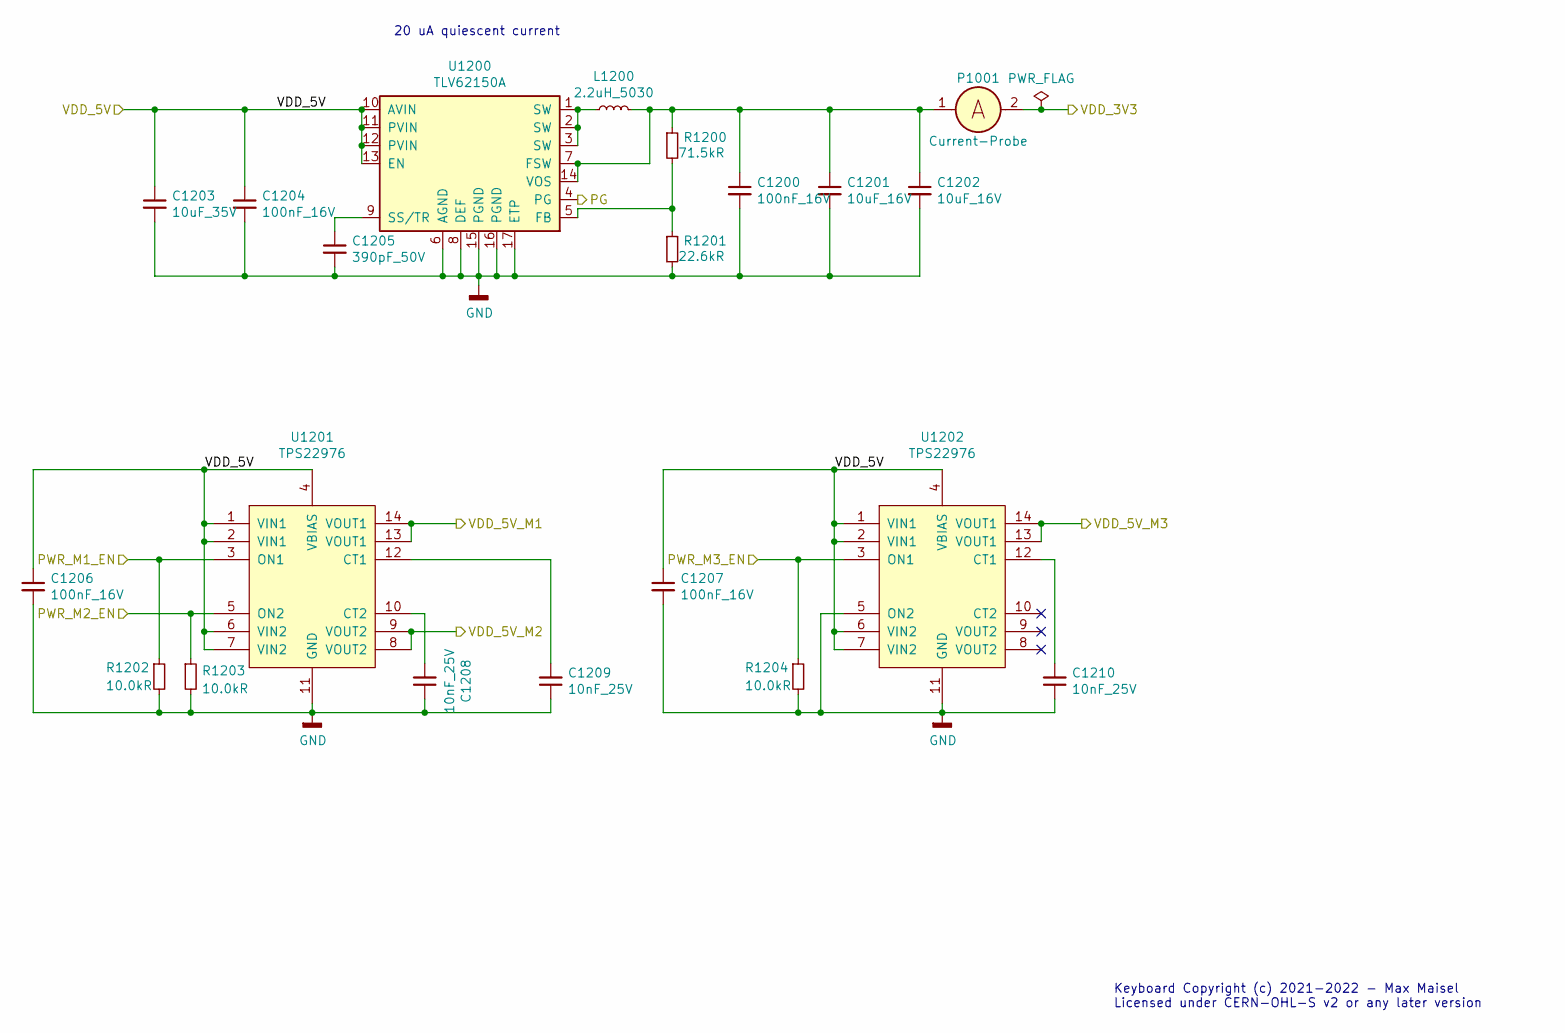
[picture p23: schematic PowerSupply.kicad_sch]

Parts:
C1200, C1204, C1206, C1207: 100nF_16V; C_0402; mouser# 80-C0402C104K4R
C1201, C1202: 10uF_16V; C_1206; mouser# 80-C1206C106K4P
C1203: 10uF_35V; C_1210; mouser# 963-GMK325BJ106KN-T
C1205: 390pF_50V; C_0402; mouser# 81-GRM155R71H391KA1D
C1208, C1209, C1210: 10nF_25V; C_0402; mouser# 603-CC0402KRX5R8BB10
L1200: 2.2uH_5030; L_Taiyo-Yuden_NR-50xx; mouser# 963-NRS5030T2R2NMGJV
P1001: Current-Probe; Current-Probe-2.54
R1200: 71.5kR; R_0402; mouser# 667-ERJ-2RKF7152X
R1201: 22.6kR; R_0402; mouser# 667-ERJ-S02F2262X
R1202, R1203, R1204: 10.0kR; R_0402; mouser# 667-ERJ-2RKF1002X
U1200: TLV62150A; VQFN16-RGT; mouser# 595-TLV62150ARGTR
U1201, U1202: TPS22976; WSON-14

Connections:
GND: C1200.2, C1201.2, C1202.2, C1203.2, C1204.2, C1205.2, C1206.2, C1207.2, C1208.1, C1209.1, C1210.1, R1201.2, R1202.2, R1203.2, R1204.2, U1200.6 (AGND), U1200.8 (DEF), U1200.15 (PGND), U1200.16 (PGND), U1200.17 (ETP), U1201.11 (GND), U1202.5 (ON2), U1202.11 (GND)
unnamed: C1200.1, C1201.1, C1202.1, L1200.2, P1001.1, R1200.1, U1200.7 (FSW), U1200.14 (VOS)
unnamed: C1205.1, U1200.9 (SS/TR)
unnamed: C1208.2, U1201.10 (CT2)
unnamed: C1209.2, U1201.12 (CT1)
unnamed: C1210.2, U1202.12 (CT1)
unnamed: L1200.1, U1200.1 (SW), U1200.2 (SW), U1200.3 (SW)
unnamed: R1200.2, R1201.1, U1200.5 (FB)
PG: U1200.4 (PG)
PWR_M1_EN: R1202.1, U1201.3 (ON1)
PWR_M2_EN: R1203.1, U1201.5 (ON2)
PWR_M3_EN: R1204.1, U1202.3 (ON1)
VDD_3V3: P1001.2
VDD_5V: C1203.1, C1204.1, C1206.1, C1207.1, U1200.10 (AVIN), U1200.11 (PVIN), U1200.12 (PVIN), U1200.13 (EN), U1201.1 (VIN1), U1201.2 (VIN1), U1201.4 (VBIAS), U1201.6 (VIN2), U1201.7 (VIN2), U1202.1 (VIN1), U1202.2 (VIN1), U1202.4 (VBIAS), U1202.6 (VIN2), U1202.7 (VIN2)
VDD_5V_M1: U1201.13 (VOUT1), U1201.14 (VOUT1)
VDD_5V_M2: U1201.8 (VOUT2), U1201.9 (VOUT2)
VDD_5V_M3: U1202.13 (VOUT1), U1202.14 (VOUT1)

Notes on the sheet:
20 uA quiescent current
Keyboard Copyright (c) 2021-2022 - Max Maisel Licensed under CERN-OHL-S v2 or any later version
