mmmaisel/Keyboard/hw/sim/LedMatrix.kicad_sch

## KiCad design hw/sim/LedMatrix.kicad_sch (2026-01-05)

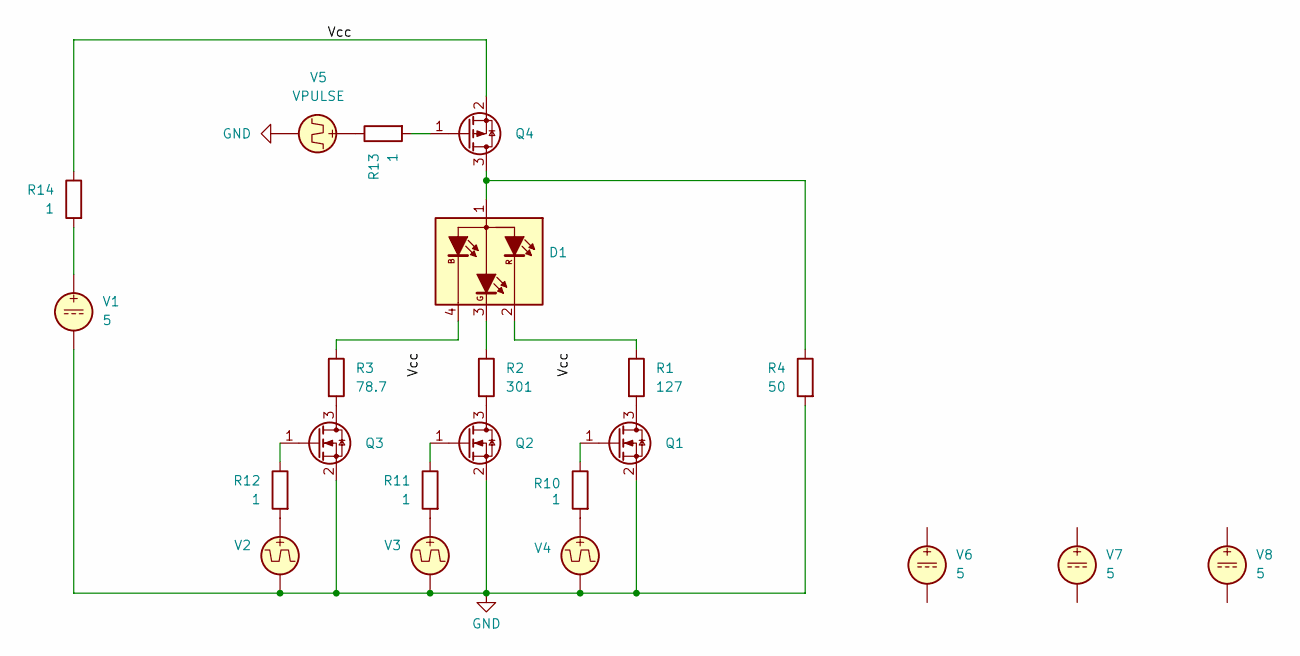
[picture p24: schematic LedMatrix.kicad_sch]

Parts:
D1: APTF1616LSEEZGKQBKC; APTF1616-RGB; mouser# 604-APTF1616LSEEZGKQ
Q1, Q2, Q3: NTA4153N; SC-75; mouser# 863-NTA4153NT1G
Q4: NTA4151P; SC-75; mouser# 863-NTA4151PT1G
R1: 127
R2: 301
R3: 78.7
R4: 50
R10, R11, R12, R13, R14: 1
V1, V6, V7, V8: 5
V2, V3, V4, V5: VPULSE

Connections:
GND: Q1.2 (S), Q2.2 (S), Q3.2 (S), R4.2, V1.2, V2.2, V3.2, V4.2, V5.2
unnamed: D1.1 (A), Q4.3 (D), R4.1
unnamed: D1.2 (KR), R1.1
unnamed: D1.3 (KG), R2.1
unnamed: D1.4 (KB), R3.1
unnamed: Q1.1 (G), R10.1
unnamed: Q1.3 (D), R1.2
unnamed: Q2.1 (G), R11.1
unnamed: Q2.3 (D), R2.2
unnamed: Q3.1 (G), R12.1
unnamed: Q3.3 (D), R3.2
unnamed: Q4.1 (G), R13.2
unnamed: R10.2, V4.1
unnamed: R11.2, V3.1
unnamed: R12.2, V2.1
unnamed: R13.1, V5.1
unnamed: R14.2, V1.1
Vcc: Q4.2 (S), R14.1
