mmmaisel/Keyboard/src/main.cpp

/******************************************************************************\
    Split Keyboard
    Copyright (C) 2019-2025 - Max Maisel

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
    You should have received a copy of the GNU General Public License
    along with this program.  If not, see <http://www.gnu.org/licenses/>.
\******************************************************************************/

#include "FreeRTOS/FreeRTOS.h"
#include "FreeRTOS/task.h"

#include "dev/gpio.h"

#include "effect.h"
#include "key_matrix.h"
#include "led_matrix.h"
#include "module.h"
#include "pinout.h"
#include "priority.h"
#include "uart_receiver.h"
#include "usb_phy.h"
#include "wiring.h"

const int STACK_SIZE_KEYBOARD = 0x100;
const int STACK_SIZE_UARTRX = 0x100;

// Task memory
StaticTask_t task_mem_keyboard;
StackType_t  task_stack_keyboard[STACK_SIZE_KEYBOARD];
StaticTask_t task_mem_uartrx1;
StackType_t  task_stack_uartrx1[STACK_SIZE_UARTRX];
StaticTask_t task_mem_uartrx2;
StackType_t  task_stack_uartrx2[STACK_SIZE_UARTRX];
StaticTask_t task_mem_uartrx6;
StackType_t  task_stack_uartrx6[STACK_SIZE_UARTRX];

// TODO: led control usb protocol

/// C++ main function, program starts here.
/// Please note that the real program starts in startup.cpp
[[noreturn]] int main() {
    Wiring wiring(Module::get_id());

    EventDispatcher::initialize();
    EffectController::initialize(wiring.key_config->page, wiring.led_config);
    EffectController::set_effect(&effect_backlight);

    wiring.led_matrix_hw_init();
    LedMatrix::initialize(wiring.led_config);

    wiring.key_matrix_hw_init();
    KeyMatrix::initialize(wiring.key_config);

    if(Module::get_id() == Module::RIGHT) {
        USBPhy::Initialize();

        using namespace pinout::right;
        dev::GPIOB->MODER |= MODE_PWREN0 | MODE_PWREN1 | MODE_PWREN2;
        dev::GPIOB->PUPDR |= PUPD_PWREN0 | PUPD_PWREN1 | PUPD_PWREN2;
        dev::GPIOB->set_odr(PWREN0 | PWREN1 | PWREN2);
    }

    xTaskCreateStatic(
        &EventSink::task,
        "KEYBOARD",
        STACK_SIZE_KEYBOARD,
        wiring.keyboard,
        priority::KEYBOARD,
        task_stack_keyboard,
        &task_mem_keyboard
    );
    // All secondary modules use UART1.
    xTaskCreateStatic(
        &UartReceiver::task_trampoline,
        "UARTRX1",
        STACK_SIZE_UARTRX,
        &uart1_receiver,
        priority::UARTRX,
        task_stack_uartrx1,
        &task_mem_uartrx1
    );

    if(Module::get_id() == Module::RIGHT) {
        xTaskCreateStatic(
            &UartReceiver::task_trampoline,
            "UARTRX2",
            STACK_SIZE_UARTRX,
            &uart2_receiver,
            priority::UARTRX,
            task_stack_uartrx2,
            &task_mem_uartrx2
        );
        xTaskCreateStatic(
            &UartReceiver::task_trampoline,
            "UARTRX6",
            STACK_SIZE_UARTRX,
            &uart6_receiver,
            priority::UARTRX,
            task_stack_uartrx6,
            &task_mem_uartrx6
        );
    }

    // Start scheduler
    vTaskStartScheduler();

    // Trap program here just in case that scheduler is stopped.
    for(;;);
}
