mmmaisel/Keyboard/src/wiring.cpp

/******************************************************************************\
    Split Keyboard
    Copyright (C) 2025 - Max Maisel

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
    You should have received a copy of the GNU General Public License
    along with this program.  If not, see <http://www.gnu.org/licenses/>.
\******************************************************************************/
#include "wiring.h"

#include "dev/gpio.h"
#include "dev/rcc.h"

#include "module.h"
#include "pin.h"
#include "pinout.h"
#include "uart_keyboard.h"
#include "usb_keyboard.h"

using namespace dev;
using namespace dev::rcc;

using Coord = LedMatrixConfig::Coord;

namespace right {
    using namespace pinout::right;

    void key_matrix_hw_init() {
        RCC->AHB1ENR |= GPIOBEN | GPIOCEN;
        GPIOB->MODER |= MODE_KR1 | MODE_KR2 | MODE_KR3 | MODE_KR4 |
            MODE_KR5 | MODE_KR6 | MODE_KR7;
        GPIOC->MODER |= MODE_KC1 | MODE_KC2 | MODE_KC3 | MODE_KC4 | MODE_KC5 |
            MODE_KC6;
        GPIOB->PUPDR |= PUPD_KR1 | PUPD_KR2 | PUPD_KR3 | PUPD_KR4 | PUPD_KR5 |
            PUPD_KR6 | PUPD_KR7;
        GPIOC->clear_odr(KC1|KC2|KC3|KC4|KC5|KC6);
    }

    KeyMatrixConfig key_matrix_cfg = {
        .page = 1,
        .row_count = 7,
        .col_count = 6,
        .nops = 0,
        .row_pins = {
            Pin { .port = GPIOB, .pin = KR1 },
            Pin { .port = GPIOB, .pin = KR2 },
            Pin { .port = GPIOB, .pin = KR3 },
            Pin { .port = GPIOB, .pin = KR4 },
            Pin { .port = GPIOB, .pin = KR5 },
            Pin { .port = GPIOB, .pin = KR6 },
            Pin { .port = GPIOB, .pin = KR7 },
        },
        .col_pins = {
            Pin { .port = GPIOC, .pin = KC1 },
            Pin { .port = GPIOC, .pin = KC2 },
            Pin { .port = GPIOC, .pin = KC3 },
            Pin { .port = GPIOC, .pin = KC4 },
            Pin { .port = GPIOC, .pin = KC5 },
            Pin { .port = GPIOC, .pin = KC6 },
        },
        .mapping = {
            { 4, 11, 18, 25, 37, 31},
            { 2,  9, 16, 23, 35, 29},
            { 3, 10, 17, 24, 36, 30},
            { 6, 13, 20, 27, 39, 33},
            { 5, 12, 19, 26, 38, 32},
            { 1,  8, 15, 28, 22, 34},
            { 7, 14, 21,  0,  0,  0},
        }
    };

    void led_matrix_hw_init() {
        RCC->AHB1ENR |= GPIOBEN | GPIODEN | GPIOEEN;
        GPIOB->MODER |= MODE_LVEN;
        GPIOD->MODER |= MODE_LC1 | MODE_LC2 | MODE_LC3 | MODE_LC4 | MODE_LC5 |
            MODE_LC6 | MODE_LC7 | MODE_LC8 | MODE_LC9;
        GPIOE->MODER |= MODE_LR1 | MODE_LR2 | MODE_LR3 | MODE_LR4 | MODE_LR5 |
            MODE_LR6 | MODE_LR7 | MODE_LR8 | MODE_LR9 | MODE_LR10 | MODE_LR11 |
            MODE_LR12 | MODE_LR13 | MODE_LR14 | MODE_LR15;
        GPIOB->clear_odr(LVEN);
        GPIOD->set_odr(LC1|LC2|LC3|LC4|LC5|LC6|LC7|LC8|LC9);
        GPIOE->clear_odr(LR1|LR2|LR3|LR4|LR5|LR6|LR7|LR8|LR9|LR10|LR11|LR12|LR13|LR14|LR15);
    }

    LedMatrixConfig led_matrix_cfg = {
        .rows = 15,
        .cols = 9,
        .nops = 1,
        .row_pins = {
            Pin { .port = GPIOE, .pin = LR1 },
            Pin { .port = GPIOE, .pin = LR2 },
            Pin { .port = GPIOE, .pin = LR3 },
            Pin { .port = GPIOE, .pin = LR4 },
            Pin { .port = GPIOE, .pin = LR5 },
            Pin { .port = GPIOE, .pin = LR6 },
            Pin { .port = GPIOE, .pin = LR7 },
            Pin { .port = GPIOE, .pin = LR8 },
            Pin { .port = GPIOE, .pin = LR9 },
            Pin { .port = GPIOE, .pin = LR10 },
            Pin { .port = GPIOE, .pin = LR11 },
            Pin { .port = GPIOE, .pin = LR12 },
            Pin { .port = GPIOE, .pin = LR13 },
            Pin { .port = GPIOE, .pin = LR14 },
            Pin { .port = GPIOE, .pin = LR15 },
        },
        .col_pins = {
            Pin { .port = GPIOD, .pin = LC1 },
            Pin { .port = GPIOD, .pin = LC2 },
            Pin { .port = GPIOD, .pin = LC3 },
            Pin { .port = GPIOD, .pin = LC4 },
            Pin { .port = GPIOD, .pin = LC5 },
            Pin { .port = GPIOD, .pin = LC6 },
            Pin { .port = GPIOD, .pin = LC7 },
            Pin { .port = GPIOD, .pin = LC8 },
            Pin { .port = GPIOD, .pin = LC9 },
        },
        .led_count = 42,
        .mapping = {
            Coord { .row =  0, .col = 0 }, // sentinel
            Coord { .row =  6, .col = 3 }, // row 1
            Coord { .row =  9, .col = 3 },
            Coord { .row =  9, .col = 4 },
            Coord { .row = 12, .col = 3 },
            Coord { .row =  0, .col = 3 },
            Coord { .row =  3, .col = 3 },
            Coord { .row =  3, .col = 4 },
            Coord { .row =  6, .col = 2 }, // row 2
            Coord { .row =  9, .col = 2 },
            Coord { .row =  9, .col = 8 },
            Coord { .row = 12, .col = 2 },
            Coord { .row =  0, .col = 2 },
            Coord { .row =  3, .col = 8 },
            Coord { .row =  3, .col = 2 },
            Coord { .row =  6, .col = 1 }, // row 3
            Coord { .row =  9, .col = 1 },
            Coord { .row =  9, .col = 0 },
            Coord { .row = 12, .col = 1 },
            Coord { .row =  0, .col = 1 },
            Coord { .row =  3, .col = 1 },
            Coord { .row =  3, .col = 0 },
            Coord { .row =  6, .col = 5 }, // row 4
            Coord { .row =  9, .col = 7 },
            Coord { .row =  9, .col = 5 },
            Coord { .row = 12, .col = 0 },
            Coord { .row =  0, .col = 7 },
            Coord { .row =  3, .col = 7 },
            Coord { .row =  3, .col = 5 },
            Coord { .row =  6, .col = 7 }, // row 5
            Coord { .row =  9, .col = 6 },
            Coord { .row = 12, .col = 5 },
            Coord { .row =  0, .col = 5 },
            Coord { .row =  3, .col = 6 },
            Coord { .row =  0, .col = 4 },
            Coord { .row =  6, .col = 6 }, // row 6
            Coord { .row = 12, .col = 4 },
            Coord { .row =  0, .col = 6 },
            Coord { .row =  0, .col = 0 },
            Coord { .row =  0, .col = 8 },
            Coord { .row =  6, .col = 8 }, // row 0
            Coord { .row =  6, .col = 4 },
            Coord { .row =  6, .col = 0 },
        }
    };
}

namespace left {
    using namespace pinout::left;

    void key_matrix_hw_init() {
        RCC->AHB1ENR |= GPIOBEN | GPIOCEN;
        GPIOB->MODER |= MODE_KR7;
        GPIOC->MODER |= MODE_KC1 | MODE_KC2 | MODE_KC3 | MODE_KC4 | MODE_KC5 |
            MODE_KC6 | MODE_KR1 | MODE_KR2 | MODE_KR3 | MODE_KR4 | MODE_KR5 |
            MODE_KR6;
        GPIOB->PUPDR |= PUPD_KR7;
        GPIOC->PUPDR |= PUPD_KR1 | PUPD_KR2 | PUPD_KR3 | PUPD_KR4 | PUPD_KR5 |
            PUPD_KR6;
        GPIOC->clear_odr(KC1|KC2|KC3|KC4|KC5|KC6);
    }

    KeyMatrixConfig key_matrix_cfg = {
        .page = 2,
        .row_count = 7,
        .col_count = 6,
        .nops = 0,
        .row_pins = {
            Pin { .port = GPIOC, .pin = KR1 },
            Pin { .port = GPIOC, .pin = KR2 },
            Pin { .port = GPIOC, .pin = KR3 },
            Pin { .port = GPIOC, .pin = KR4 },
            Pin { .port = GPIOC, .pin = KR5 },
            Pin { .port = GPIOC, .pin = KR6 },
            Pin { .port = GPIOB, .pin = KR7 },
        },
        .col_pins = {
            Pin { .port = GPIOC, .pin = KC1 },
            Pin { .port = GPIOC, .pin = KC2 },
            Pin { .port = GPIOC, .pin = KC3 },
            Pin { .port = GPIOC, .pin = KC4 },
            Pin { .port = GPIOC, .pin = KC5 },
            Pin { .port = GPIOC, .pin = KC6 },
        },
        .mapping = {
            {10,  3, 37, 24, 17, 31},
            {11,  4, 38, 25, 18, 32},
            {13,  6, 28, 27, 20, 34},
            { 9,  2, 36, 23, 16, 30},
            { 8,  1, 35, 22, 15, 29},
            {12,  5,  0, 26, 19, 33},
            {14,  7,  0,  0, 21,  0},
        }
    };

    void led_matrix_hw_init() {
        RCC->AHB1ENR |= GPIOAEN | GPIOBEN;
        GPIOA->MODER |= MODE_LC1 | MODE_LC2 | MODE_LC3 | MODE_LC4 | MODE_LC5 |
            MODE_LC6 | MODE_LC7 | MODE_LC8 | MODE_LC9 | MODE_LC10 |
            MODE_LR1 | MODE_LR2 | MODE_LR3;
        GPIOB->MODER |= MODE_LVEN | MODE_LR4 | MODE_LR5 | MODE_LR6 | MODE_LR7 |
            MODE_LR8 | MODE_LR9 | MODE_LR10 | MODE_LR11 | MODE_LR12;
        GPIOA->set_odr(LC1|LC2|LC3|LC4|LC5|LC6|LC7|LC8|LC9|LC10);
        GPIOA->clear_odr(LR1|LR2|LR3);
        GPIOB->clear_odr(LVEN|LR4|LR5|LR6|LR7|LR8|LR9|LR10|LR11|LR12);
    }

    LedMatrixConfig led_matrix_cfg = {
        .rows = 12,
        .cols = 10,
        .nops = 0,
        .row_pins = {
            Pin { .port = GPIOA, .pin = LR1 },
            Pin { .port = GPIOA, .pin = LR2 },
            Pin { .port = GPIOA, .pin = LR3 },
            Pin { .port = GPIOB, .pin = LR4 },
            Pin { .port = GPIOB, .pin = LR5 },
            Pin { .port = GPIOB, .pin = LR6 },
            Pin { .port = GPIOB, .pin = LR7 },
            Pin { .port = GPIOB, .pin = LR8 },
            Pin { .port = GPIOB, .pin = LR9 },
            Pin { .port = GPIOB, .pin = LR10 },
            Pin { .port = GPIOB, .pin = LR11 },
            Pin { .port = GPIOB, .pin = LR12 },
        },
        .col_pins = {
            Pin { .port = GPIOA, .pin = LC1 },
            Pin { .port = GPIOA, .pin = LC2 },
            Pin { .port = GPIOA, .pin = LC3 },
            Pin { .port = GPIOA, .pin = LC4 },
            Pin { .port = GPIOA, .pin = LC5 },
            Pin { .port = GPIOA, .pin = LC6 },
            Pin { .port = GPIOA, .pin = LC7 },
            Pin { .port = GPIOA, .pin = LC8 },
            Pin { .port = GPIOA, .pin = LC9 },
            Pin { .port = GPIOA, .pin = LC10 },
        },
        .led_count = 40,
        .mapping = {
            Coord { .row =  0, .col = 0 }, // sentinel
            Coord { .row =  3, .col = 0 }, // row 1
            Coord { .row =  9, .col = 0 },
            Coord { .row =  9, .col = 9 },
            Coord { .row =  0, .col = 0 },
            Coord { .row =  0, .col = 9 },
            Coord { .row =  6, .col = 0 },
            Coord { .row =  6, .col = 9 },
            Coord { .row =  3, .col = 1 }, // row 2
            Coord { .row =  9, .col = 1 },
            Coord { .row =  9, .col = 8 },
            Coord { .row =  0, .col = 1 },
            Coord { .row =  0, .col = 8 },
            Coord { .row =  6, .col = 1 },
            Coord { .row =  6, .col = 8 },
            Coord { .row =  3, .col = 2 }, // row 3
            Coord { .row =  9, .col = 2 },
            Coord { .row =  9, .col = 7 },
            Coord { .row =  0, .col = 2 },
            Coord { .row =  0, .col = 7 },
            Coord { .row =  6, .col = 2 },
            Coord { .row =  6, .col = 7 },
            Coord { .row =  3, .col = 3 }, // row 4
            Coord { .row =  9, .col = 3 },
            Coord { .row =  9, .col = 5 },
            Coord { .row =  0, .col = 3 },
            Coord { .row =  0, .col = 5 },
            Coord { .row =  6, .col = 3 },
            Coord { .row =  6, .col = 5 },
            Coord { .row =  3, .col = 4 }, // row 5
            Coord { .row =  9, .col = 4 },
            Coord { .row =  9, .col = 6 },
            Coord { .row =  0, .col = 4 },
            Coord { .row =  0, .col = 6 },
            Coord { .row =  6, .col = 4 },
            Coord { .row =  3, .col = 5 }, // row 6
            Coord { .row =  3, .col = 6 },
            Coord { .row =  3, .col = 7 },
            Coord { .row =  6, .col = 6 },
            Coord { .row =  3, .col = 9 }, // row 0
            Coord { .row =  3, .col = 8 },
        }
    };
}

namespace nav {
    using namespace pinout::nav;

    void key_matrix_hw_init() {
        RCC->AHB1ENR |= GPIOBEN | GPIOCEN;
        GPIOC->MODER |= MODE_KC1 | MODE_KC2 | MODE_KC3 |
            MODE_KR1 | MODE_KR2 | MODE_KR3 | MODE_KR4 | MODE_KR5;
        GPIOC->PUPDR |= PUPD_KR1 | PUPD_KR2 | PUPD_KR3 | PUPD_KR4 | PUPD_KR5;
        GPIOC->clear_odr(KC1|KC2|KC3);
    }

    KeyMatrixConfig key_matrix_cfg = {
        .page = 3,
        .row_count = 5,
        .col_count = 3,
        .nops = 3,
        .row_pins = {
            Pin { .port = GPIOC, .pin = KR1 },
            Pin { .port = GPIOC, .pin = KR2 },
            Pin { .port = GPIOC, .pin = KR3 },
            Pin { .port = GPIOC, .pin = KR4 },
            Pin { .port = GPIOC, .pin = KR5 },
        },
        .col_pins = {
            Pin { .port = GPIOC, .pin = KC1 },
            Pin { .port = GPIOC, .pin = KC2 },
            Pin { .port = GPIOC, .pin = KC3 },
        },
        .mapping = {
            { 2,  8, 11},
            { 1,  4, 10},
            { 3,  9, 14},
            { 6, 12, 15},
            { 5,  7, 13},
        }
    };

    void led_matrix_hw_init() {
        RCC->AHB1ENR |= GPIOAEN | GPIOBEN;
        GPIOA->MODER |= MODE_LC1 | MODE_LC2 | MODE_LC3 | MODE_LC4 | MODE_LC5;
        GPIOB->MODER |= MODE_LVEN | MODE_LR1 | MODE_LR2 | MODE_LR3 | MODE_LR4 |
            MODE_LR5 | MODE_LR6 | MODE_LR7 | MODE_LR8 | MODE_LR9;
        GPIOA->set_odr(LC1|LC2|LC3|LC4|LC5);
        GPIOB->clear_odr(LVEN|LR1|LR2|LR3|LR4|LR5|LR6|LR7|LR8|LR9);
    }

    LedMatrixConfig led_matrix_cfg = {
        .rows = 9,
        .cols = 5,
        .nops = 5,
        .row_pins = {
            Pin { .port = GPIOB, .pin = LR1 },
            Pin { .port = GPIOB, .pin = LR2 },
            Pin { .port = GPIOB, .pin = LR3 },
            Pin { .port = GPIOB, .pin = LR4 },
            Pin { .port = GPIOB, .pin = LR5 },
            Pin { .port = GPIOB, .pin = LR6 },
            Pin { .port = GPIOB, .pin = LR7 },
            Pin { .port = GPIOB, .pin = LR8 },
            Pin { .port = GPIOB, .pin = LR9 },
        },
        .col_pins = {
            Pin { .port = GPIOA, .pin = LC1 },
            Pin { .port = GPIOA, .pin = LC2 },
            Pin { .port = GPIOA, .pin = LC3 },
            Pin { .port = GPIOA, .pin = LC4 },
            Pin { .port = GPIOA, .pin = LC5 },
        },
        .led_count = 15,
        .mapping = {
            Coord { .row =  0, .col = 0 }, // sentinel
            Coord { .row =  0, .col = 0 }, // row 1
            Coord { .row =  3, .col = 0 },
            Coord { .row =  6, .col = 0 },
            Coord { .row =  0, .col = 1 }, // row 2
            Coord { .row =  3, .col = 1 },
            Coord { .row =  6, .col = 1 },
            Coord { .row =  0, .col = 2 }, // row 3
            Coord { .row =  3, .col = 2 },
            Coord { .row =  6, .col = 2 },
            Coord { .row =  0, .col = 4 }, // row 4
            Coord { .row =  3, .col = 4 },
            Coord { .row =  6, .col = 4 },
            Coord { .row =  0, .col = 3 }, // row 5
            Coord { .row =  3, .col = 3 },
            Coord { .row =  6, .col = 3 },
        }
    };
}

namespace num {
    using namespace pinout::num;

    void key_matrix_hw_init() {
        RCC->AHB1ENR |= GPIOBEN | GPIOCEN;
        GPIOC->MODER |= MODE_KC1 | MODE_KC2 | MODE_KC3 | MODE_KC4 |
            MODE_KR1 | MODE_KR2 | MODE_KR3 | MODE_KR4 | MODE_KR5;
        GPIOC->PUPDR |= PUPD_KR1 | PUPD_KR2 | PUPD_KR3 | PUPD_KR4 | PUPD_KR5;
        GPIOC->clear_odr(KC1|KC2|KC3|KC4);
    }

    KeyMatrixConfig key_matrix_cfg = {
        .page = 4,
        .row_count = 5,
        .col_count = 4,
        .nops = 2,
        .row_pins = {
            Pin { .port = GPIOC, .pin = KR1 },
            Pin { .port = GPIOC, .pin = KR2 },
            Pin { .port = GPIOC, .pin = KR3 },
            Pin { .port = GPIOC, .pin = KR4 },
            Pin { .port = GPIOC, .pin = KR5 },
        },
        .col_pins = {
            Pin { .port = GPIOC, .pin = KC1 },
            Pin { .port = GPIOC, .pin = KC2 },
            Pin { .port = GPIOC, .pin = KC3 },
            Pin { .port = GPIOC, .pin = KC4 },
        },
        .mapping = {
            {16, 18,  4,  8},
            {13,  9,  1,  5},
            {15, 11,  3,  7},
            {14, 10,  2,  6},
            {17, 12,  0,  0},
        }
    };

    void led_matrix_hw_init() {
        RCC->AHB1ENR |= GPIOAEN | GPIOBEN;
        GPIOA->MODER |= MODE_LR1 | MODE_LR2 | MODE_LR3 | MODE_LR4 | MODE_LR5 |
            MODE_LR6 | MODE_LR7 | MODE_LR8 | MODE_LR9;
        GPIOB->MODER |= MODE_LVEN | MODE_LC1 | MODE_LC2 | MODE_LC3 | MODE_LC4 |
            MODE_LC5 | MODE_LC6;
        GPIOA->clear_odr(LR1|LR2|LR3|LR4|LR5|LR6|LR7|LR8|LR9);
        GPIOB->clear_odr(LVEN);
        GPIOB->set_odr(LC1|LC2|LC3|LC4|LC5|LC6);
    }

    LedMatrixConfig led_matrix_cfg = {
        .rows = 9,
        .cols = 6,
        .nops = 4,
        .row_pins = {
            Pin { .port = GPIOA, .pin = LR1 },
            Pin { .port = GPIOA, .pin = LR2 },
            Pin { .port = GPIOA, .pin = LR3 },
            Pin { .port = GPIOA, .pin = LR4 },
            Pin { .port = GPIOA, .pin = LR5 },
            Pin { .port = GPIOA, .pin = LR6 },
            Pin { .port = GPIOA, .pin = LR7 },
            Pin { .port = GPIOA, .pin = LR8 },
            Pin { .port = GPIOA, .pin = LR9 },
        },
        .col_pins = {
            Pin { .port = GPIOB, .pin = LC1 },
            Pin { .port = GPIOB, .pin = LC2 },
            Pin { .port = GPIOB, .pin = LC3 },
            Pin { .port = GPIOB, .pin = LC4 },
            Pin { .port = GPIOB, .pin = LC5 },
            Pin { .port = GPIOB, .pin = LC6 },
        },
        .led_count = 18,
        .mapping = {
            Coord { .row =  0, .col = 0 }, // sentinel
            Coord { .row =  0, .col = 0 }, // row 1
            Coord { .row =  3, .col = 0 },
            Coord { .row =  3, .col = 3 },
            Coord { .row =  6, .col = 0 },
            Coord { .row =  0, .col = 3 }, // row 2
            Coord { .row =  3, .col = 1 },
            Coord { .row =  3, .col = 2 },
            Coord { .row =  6, .col = 3 },
            Coord { .row =  0, .col = 1 }, // row 3
            Coord { .row =  3, .col = 4 },
            Coord { .row =  3, .col = 5 },
            Coord { .row =  6, .col = 1 },
            Coord { .row =  0, .col = 2 }, // row 4
            Coord { .row =  0, .col = 4 },
            Coord { .row =  6, .col = 2 },
            Coord { .row =  0, .col = 5 }, // row 5
            Coord { .row =  6, .col = 4 },
            Coord { .row =  6, .col = 5 },
        }
    };
}

Wiring::Wiring(BYTE mod_id) {
    switch(mod_id) {
        case Module::RIGHT:
            keyboard = &usb_keyboard;
            key_config = &right::key_matrix_cfg;
            key_matrix_hw_init = right::key_matrix_hw_init;
            led_config = &right::led_matrix_cfg;
            led_matrix_hw_init = right::led_matrix_hw_init;
            break;

        case Module::LEFT:
            keyboard = &uart_keyboard;
            key_config = &left::key_matrix_cfg;
            key_matrix_hw_init = left::key_matrix_hw_init;
            led_config = &left::led_matrix_cfg;
            led_matrix_hw_init = left::led_matrix_hw_init;
            break;

        case Module::NAV:
            keyboard = &uart_keyboard;
            key_config = &nav::key_matrix_cfg;
            key_matrix_hw_init = nav::key_matrix_hw_init;
            led_config = &nav::led_matrix_cfg;
            led_matrix_hw_init = nav::led_matrix_hw_init;
            break;

        case Module::NUM:
            keyboard = &uart_keyboard;
            key_config = &num::key_matrix_cfg;
            key_matrix_hw_init = num::key_matrix_hw_init;
            led_config = &num::led_matrix_cfg;
            led_matrix_hw_init = num::led_matrix_hw_init;
            break;

        default:
            break;
    }
}
