mmmaisel/Keyboard/src/modular_keyboard.cpp

/******************************************************************************\
    Split Keyboard
    Copyright (C) 2022-2025 - Max Maisel

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
    You should have received a copy of the GNU General Public License
    along with this program.  If not, see <http://www.gnu.org/licenses/>.
\******************************************************************************/
#include "modular_keyboard.h"

#include "dev/core.h"

#include "effect.h"
#include "event.h"
#include "hid_keyboard_endpoint.h"
#include "key_layout.h"
#include "module.h"
#include "priority.h"
#include "uart_protocol.h"

#include <cstring>

EventQueue ModularKeyboard::_queue;
Event ModularKeyboard::_buffer = {0};
DWORD ModularKeyboard::_pages[PAGE_COUNT] = {0};

[[noreturn]] void ModularKeyboard::task(void* pContext __attribute((unused))) {
    // XXX: store led state in flash?
    for(;;) {
        if(_queue.recv(&_buffer) != pdTRUE)
            continue;

        if(_buffer.type == EVENT_KEYS)
            EffectController::on_keys(_buffer.keys.state);

        asm volatile("nop");

        if(Module::get_id() == Module::RIGHT) {
            //update_keys();
        } else {
            //UartProtocol::send_key_page(m_buffer);
        }
    }
}

/*void ModularKeyboard::send_page(KeyMatrix::Page* page) {
    xQueueSend(m_queue, page, portMAX_DELAY);
}

void ModularKeyboard::send_page_from_isr(KeyMatrix::Page* page) {
    BaseType_t xHigherPriorityTaskWoken = pdFALSE;
    xQueueSendFromISR(m_queue, page, &xHigherPriorityTaskWoken);
    portYIELD_FROM_ISR(xHigherPriorityTaskWoken);
}*/

void ModularKeyboard::get_keys(BYTE* buffer) {
    BYTE pos = 0;
    //BYTE is_fn = 0;
    //BYTE fn_code = 0;

    /*for(BYTE i = 0; i < PAGE_COUNT; ++i) {
        for(BYTE j = 0; j < KeyMatrix::MAX_KEYS; ++j) {
            BYTE keycode = m_pages[i].keys[j];

            if(keycode == keycodes::KEY_FN)
                is_fn = 1;
            if(fn_code == 0)
                fn_code = keycode;
        }
    }

    // TODO: process fn_code to keycode here
    if(is_fn) {
        buffer[0] = keycodes::KEY_NONE;
        return;
    }

    for(BYTE i = 0; i < PAGE_COUNT; ++i) {
        for(BYTE j = 0; j < KeyMatrix::MAX_KEYS; ++j) {
            BYTE keycode = m_pages[i].keys[j];
            if(keycode == keycodes::KEY_NONE)
                continue;

            buffer[pos] = keycode;
            if(++pos == BUFFER_SIZE-1) {
                buffer[pos] = keycodes::KEY_NONE;
                return;
            }
        }
    }*/
    buffer[pos] = keycodes::KEY_NONE;
}

/*void ModularKeyboard::set_led(const LedMatrix::Led& led) {
    if(!LedMatrix::set_led(led) && Module::get_id() == Module::RIGHT)
        UartProtocol::send_led(led);
}

void ModularKeyboard::update_keys() {
    BYTE id = m_buffer.id;
    BYTE buffer[BUFFER_SIZE];

    EffectController::on_update_page(m_pages[id].keys, m_buffer.keys);
    memcpy(&m_pages[id], &m_buffer, sizeof(KeyMatrix::Page));
    get_keys(buffer);
    ep1.send_report(buffer);
}*/
