mmmaisel/Keyboard/src/key_matrix.cpp

/******************************************************************************\
    Split Keyboard
    Copyright (C) 2022-2025 - Max Maisel

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
    You should have received a copy of the GNU General Public License
    along with this program.  If not, see <http://www.gnu.org/licenses/>.
\******************************************************************************/
#include "key_matrix.h"

#include "dev/core.h"
#include "dev/gpio.h"
#include "dev/rcc.h"
#include "dev/timer.h"

#include "event.h"
#include "priority.h"

const KeyMatrixConfig* KeyMatrix::_config = nullptr;
BYTE KeyMatrix::_col = 0;
BYTE KeyMatrix::_phase = KeyMatrix::PHASE_DRIVE;
DWORD KeyMatrix::_debounced_keys = 0;
DWORD KeyMatrix::_key_history[KeyMatrix::HISTORY_LEN] = {0};
BYTE KeyMatrix::_history_idx = 0;

void KeyMatrix::initialize(const KeyMatrixConfig* config) {
    using namespace dev;
    using namespace dev::rcc;
    using namespace dev::timer;

    _config = config;

    // Configure 10 kHz timer
    // Timer clock is multiplied by 2 if APB1_DIV != 1
    // f_mat = f_tim / 2 / n_col
    // TODO: check frequency, currently it is 9.06 kHz, not 10 ??
    RCC->APB1ENR |= TIM3EN;
    TIM3->CR1 = DIR | URS;
    TIM3->ARR = 10;
    TIM3->PSC = 120;
    TIM3->DIER |= UIE;
    TIM3->CR1 |= CEN;

    // Enable Timer interrupt
    NVIC->enable_isr(isrnum::TIM3);
    NVIC->set_priority(isrnum::TIM3, priority::KEY_MATRIX);
}

void KeyMatrix::ISR() {
    using namespace dev;
    using namespace dev::timer;
    BaseType_t task_woken = pdFALSE;

    TIM3->SR &= ~UIF;

    if(_phase == PHASE_DRIVE) {
        // Drive next column.
        _config->col_pins[_col].port->set_odr(_config->col_pins[_col].pin);
        _phase = PHASE_READ;
    } else if(_phase == PHASE_READ) {
        // Read current columns rows
        for(BYTE row = 0; row < _config->row_count; ++row) {
            if(_config->row_pins[row].port->IDR & _config->row_pins[row].pin)
                _key_history[_history_idx] |=
                    (1ull << (_config->mapping[row][_col] - 1));
        }

        // Stop drive current column
        _config->col_pins[_col].port->clear_odr(_config->col_pins[_col].pin);

        // All columns scanned?
        if(++_col >= _config->col_count) {
            _col= 0;
            // Rotate history
            if(++_history_idx >= HISTORY_LEN)
                _history_idx = 0;

            // Debounce state, change it if the new state occurred
            // three times in a row.
            DWORD keys_or = _key_history[0];
            DWORD keys_and = _key_history[0];
            for(BYTE i = 1; i < HISTORY_LEN; ++i) {
                keys_and &= _key_history[i];
                keys_or |= _key_history[i];
            }
            _debounced_keys =
                (~_debounced_keys & keys_and) | (_debounced_keys & keys_or);

            // Clear state for next scan
            _key_history[_history_idx] = 0;

            // Send event
            Event event = {
                .type = EVENT_KEYS,
                .keys = KeyEvent {
                    .page = _config->page,
                    .state = _debounced_keys,
                }
            };
            EventDispatcher::send_from_isr(&event, &task_woken);
        }

        if(_col == 0 && _config->nops != 0)
            _phase = PHASE_NOP;
        else
            _phase = PHASE_DRIVE;
    } else {
        // One cycle consists of drive and read
        if(++_col >= _config->nops*2) {
            _col = 0;
            _phase = PHASE_DRIVE;
        }
    }
    portYIELD_FROM_ISR(task_woken);
}

extern "C" void tim3_vector() {
    KeyMatrix::ISR();
}
