mmmaisel/Keyboard/src/system.cpp

/******************************************************************************\
    Split Keyboard
    Copyright (C) 2019-2025 - Max Maisel

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
    You should have received a copy of the GNU General Public License
    along with this program.  If not, see <http://www.gnu.org/licenses/>.
\******************************************************************************/
#include <stdint.h>

#include "FreeRTOS/FreeRTOS.h"
#include "FreeRTOS/task.h"
#include "FreeRTOS/queue.h"

extern void* __heap_start__;

/// @internal
/// A function which is called after main() and handles something
/// with destruction of global objects.
///
/// As main() never exits here this function is a stub.
/// cppcheck-suppress[unusedFunction]
extern "C" void __dso_handle() {
}

/// @internal
/// A deprecated function which is called after main() and handles
/// destruction of modules.
///
/// As main() never exits here this function is a stub.
/// cppcheck-suppress[unusedFunction]
extern "C" void _fini() {
}

/// @internal
/// Increases heap size, used by malloc / new.
/// Since there is no dynamic memory in this program this function is a stub.
/// cppcheck-suppress[unusedFunction]
extern "C" void* _sbrk(int incr) {
    return __heap_start__;
}

/**********************************************************************\
 * FreeRTOS
\**********************************************************************/

/// @internal
/// FreeRTOS assertion failed hook
extern "C" void vAssertCalled(const char* file, int line) {
    for(;;);
}

StaticTask_t xIdleTaskTCB;
StackType_t uxIdleTaskStack[configMINIMAL_STACK_SIZE];

extern "C" void vApplicationGetIdleTaskMemory
(
    StaticTask_t **ppxIdleTaskTCBBuffer,
    StackType_t **ppxIdleTaskStackBuffer,
    uint32_t *pulIdleTaskStackSize
)
{
    // Pass out a pointer to the StaticTask_t structure in
    // which the Idle task's state will be stored.
    *ppxIdleTaskTCBBuffer = &xIdleTaskTCB;

    // Pass out the array that will be used as the Idle task's stack.
    *ppxIdleTaskStackBuffer = uxIdleTaskStack;

    // Pass out the size of the array pointed to by *ppxIdleTaskStackBuffer.
    // Note that, as the array is necessarily of type StackType_t,
    // configMINIMAL_STACK_SIZE is specified in words, not bytes.
    *pulIdleTaskStackSize = configMINIMAL_STACK_SIZE;
}

/// @internal
/// FreeRTOS stack overflow hook
#ifdef DEBUG
extern "C" void vApplicationStackOverflowHook(
    TaskHandle_t xTask, char *pcTaskName)
{
    for(;;);
}
#endif

/**********************************************************************\
 * Fatal software errors
\**********************************************************************/

void error_handler() {
    // TODO: signal error somehow
    for(;;);
}

/// @internal
/// Pure virtual function call error hook
/// cppcheck-suppress[unusedFunction]
extern "C" void __cxa_pure_virtual() {
    error_handler();
}

/**********************************************************************\
 * Error interrupts
\**********************************************************************/

extern "C" void fault_vector() __attribute__((naked));
extern "C" void fault_vector() {
    error_handler();
}

extern "C" void nmi_vector() __attribute__((naked));
extern "C" void nmi_vector() {
    error_handler();
}

extern "C" void default_vector() __attribute__((naked));
extern "C" void default_vector() {
    error_handler();
}
