mmmaisel/Keyboard/(commit log)

2022-02-21 Initially commit project, schematics and symbol library to git.
    [CPU-Left.kicad_sch, CPU-Navblock.kicad_sch, CPU-Numblock.kicad_sch, CPU-Right.kicad_sch, KeyMatrix-Left.kicad_sch, KeyMatrix-Navblock.kicad_sch, KeyMatrix-Numblock.kicad_sch, KeyMatrix-Right.kicad_sch]
2022-02-21 Initially commit 3D models and footprint library to git.
2022-02-21 Add ESD diodes to key matrix pins.
    Better save than sorry.
    [CPU-Left.kicad_sch, CPU-Navblock.kicad_sch, CPU-Numblock.kicad_sch, CPU-Right.kicad_sch, KeyMatrix-Left.kicad_sch, KeyMatrix-Navblock.kicad_sch, KeyMatrix-Numblock.kicad_sch, KeyMatrix-Right.kicad_sch]
2022-02-21 Fix SW_Cherry_MX1A_RGB LED window position.
2022-03-21 Use alternate functions for STM32 pins.
    [CPU-Left.kicad_sch, CPU-Navblock.kicad_sch, CPU-Numblock.kicad_sch, CPU-Right.kicad_sch]
2022-03-21 Add DistanceBolt-6x3.5 symbol, footprint and 3D model.
2022-03-21 Add 100R resistor to symbol library.
2022-03-21 Add alternate IO pin functions to FC68125_1_1 connector.
2022-04-02 Fix some text sizes and courtyards in footprint library.
2022-04-02 Update schematic:
    - Add ESD protection.
    - Adjust distance bolts so they fit to the MX mounting plate.
    - Make key layout symmetric.
    - Add resistor to TX driver outputs.
    - Use alternate IO functions on inter-board connectors.
    [CPU-Left.kicad_sch, CPU-Navblock.kicad_sch, CPU-Numblock.kicad_sch, KeyMatrix-Left.kicad_sch, KeyMatrix-Navblock.kicad_sch, KeyMatrix-Numblock.kicad_sch, KeyMatrix-Right.kicad_sch, Keyboard-Left.kicad_sch]
2022-04-09 Layout Keyboard PCB.
2022-05-14 Add basic firmware with LED and key matrix support.
    [st_nucleo_f401re.cfg]
2022-05-14 Change key matrix capacitors to 220pF.
    [KeyMatrix-Left.kicad_sch, KeyMatrix-Navblock.kicad_sch, KeyMatrix-Numblock.kicad_sch, KeyMatrix-Right.kicad_sch]
2022-05-14 Adjust LED matrix resistors.
    [LedMatrix-Left.kicad_sch, LedMatrix-Navblock.kicad_sch, LedMatrix-Numblock.kicad_sch, LedMatrix-Right.kicad_sch]
2022-05-14 Re-link changed components with PCB.
    [Keyboard.kicad_sch]
2022-05-16 Add basic USB driver and descriptors.
2022-05-19 Factor out interrupt enable/disable helper method.
2022-05-21 Implement UART read/write with DMA.
2022-05-21 Implement initialization for all UARTs.
2022-05-21 Factor out ModularKeyboard class and make UART event driven.
2022-05-21 Refactor module detection.
    Perform it early during reset so that it is available globally during
    constructors.
    [key_matrix.cpp, key_matrix.h, led_matrix.cpp, led_matrix.h, main.cpp, module.cpp, module.h, startup.cpp]
2022-05-21 Select alternate pin function for missing UART6 pins in schematic.
    [CPU-Navblock.kicad_sch]
2022-05-21 Fix some compiler warnings after meson conversion.
    [key_matrix.cpp, led_matrix.cpp, startup.cpp, system.cpp]
2022-05-22 Control Num/Caps/Scroll LEDs via USB-HID.
2022-05-22 Implement simple inter-board UART protocol.
2022-05-22 Access LEDs by HID keycode.
    Therefore, add lookup tables for all modules.
2022-05-25 Add inter-board LED protocol.
2022-05-27 Define interrupt priorities and set them correctly.
    [core.h, hid_keyboard_endpoint.cpp, key_matrix.cpp, led_matrix.cpp, modular_keyboard.cpp, priority.h, startup.cpp, uart.cpp]
2022-05-28 Change switch orientation to south to improve LED illumination.
2022-05-28 Improve APTF1616-RGB pin 1 marking.
2022-06-02 Improve current probe DRC behaviour.
    Replace the shorting pad with a graphical line.
2022-06-03 Layout south facing keyboard PCB.
    Furthermore, optimize matrix component placement foir cleaner layout.
    [KeyMatrix-Left.kicad_sch]
2022-06-29 Add current probes to 3.3V and pull-up to LV_EN.
    [CPU-Left.kicad_sch, CPU-Navblock.kicad_sch, CPU-Numblock.kicad_sch, Keyboard.kicad_sch, LevelShifters-Left.kicad_sch, LevelShifters-Navblock.kicad_sch, LevelShifters-Numblock.kicad_sch, LevelShifters-Right.kicad_sch]
2022-07-03 Add net labels to LED tracks.
    [LedMatrix-Left.kicad_sch, LedMatrix-Navblock.kicad_sch, LedMatrix-Numblock.kicad_sch, LedMatrix-Right.kicad_sch]
2022-07-03 Fix LED matrix addressing and add clear method.
    [led_matrix.cpp, led_matrix.h]
2022-07-03 Add key and LED layout for right module.
2022-07-03 Handle default keyboard LEDs from HID report.
2022-07-17 Add 300R symbol and use it at green LEDs.
    [Keyboard.kicad_sch, LedMatrix-Left.kicad_sch, LedMatrix-Navblock.kicad_sch, LedMatrix-Numblock.kicad_sch, LedMatrix-Right.kicad_sch]
2022-07-23 Add key and LED layout for left module.
2022-07-23 Do not initialize UART6 on left module.
2022-07-23 Add pull-downs to power switches.
    [Keyboard.kicad_sch, PowerSupply.kicad_sch]
2022-08-12 Add key and LED layouts for Nav and Num modules.
2022-08-28 Add FreeRTOS debugging support to debug builds.
    [st_nucleo_f401re.cfg]
2022-08-28 Implement basic UART key event reading.
2022-09-03 Broadcast LED state changes to secondary boards.
2022-09-10 Handle received LED messages.
2023-07-30 Upgrade to KiCad 7 file format.
    [CPU-Left.kicad_sch, CPU-Navblock.kicad_sch, CPU-Numblock.kicad_sch, CPU-Right.kicad_sch, KeyMatrix-Left.kicad_sch, KeyMatrix-Navblock.kicad_sch, KeyMatrix-Numblock.kicad_sch, KeyMatrix-Right.kicad_sch]
2023-07-30 Add Pin header 1x8x2.54 horizontal symbol, footprint and 3D model.
2023-07-30 Replace JTAG connectors with angled ones one back side.
    [CPU-Left.kicad_sch, CPU-Navblock.kicad_sch, CPU-Numblock.kicad_sch, CPU-Right.kicad_sch]
2023-12-09 Increase lightpipe mounting holes.
2024-01-11 Add keyboard case CAD models.
    [Keyboard-Outer-Case.FCStd]
2025-10-02 Refactor LED matrix and re-implement basic flash effect.
2025-10-03 Refactor remaining module wiring.
2025-10-03 Add LED rainbow test effect.
2025-10-05 Start breaking refactoring of UART.
2025-10-06 Re-implement UART write.
2025-10-07 Implement uart receiver.
2025-12-27 Fix key-state and page encoding.
    [key_matrix.cpp, uart_receiver.cpp, uart_serde.cpp]
2025-12-27 Add left module key layout and fix some keys.
    [key_layout.cpp]
2025-12-28 Make effects runtime switchable and other effect fixes/improvements.
    [effect.cpp, effect.h, event.cpp, main.cpp]
2025-12-28 Fix and enable UART2/6.
    [main.cpp, rcc.h, startup.cpp, uart.cpp, uart.h, uart_receiver.cpp, uart_receiver.h, uart_serde.h]
2025-12-28 Adjust matrix timer frequencies.
2025-12-29 Propagate LED effect switch to other hardware modules.
2026-01-01 Drive LED matrix row-major.
2026-01-02 Balance LED matrices by inserting nop cycles.
2026-01-02 Re-Implement std keyboard LED host controls.
2026-01-05 Upgrade libraries to Kicad 9.
2026-01-05 Upgrade project to Kicad 9.
    [CPU-Left.kicad_sch, CPU-Navblock.kicad_sch, CPU-Numblock.kicad_sch, CPU-Right.kicad_sch, KeyMatrix-Left.kicad_sch, KeyMatrix-Navblock.kicad_sch, KeyMatrix-Numblock.kicad_sch, KeyMatrix-Right.kicad_sch]
2026-01-05 Optimize connector frontplate cutouts and integrate them into footprint.
2026-01-05 Fix some footprint mounting types.
    [CPU-Left.kicad_sch, CPU-Navblock.kicad_sch, CPU-Numblock.kicad_sch, PowerSupply.kicad_sch]
2026-01-05 Add NTA4153N and NTA4151P MOSFET symbols.
2026-01-05 Replace LED matrix BJTs with MOSFETs and update PCB.
    [LedMatrix-Left.kicad_sch, LedMatrix-Navblock.kicad_sch, LedMatrix-Numblock.kicad_sch, LedMatrix-Right.kicad_sch]
2026-01-05 Add LED matrix simulation.
    [LedMatrix.kicad_sch]
2026-01-11 Logarithmically scale LED colors.
